EmanuelKaefer/Open-robot-arm/README.txt

# Robot Arm Project

This repository contains an ongoing project focused on the development of a 6-DOF robotic arm. The project is part of a school project and may later be extended into a larger final thesis project. The goal is to design and build a functional robotic arm while gaining experience in mechanical design, electronics, embedded systems, and software.

The repository includes hardware designs, firmware, control software, and documentation. As the project progresses, new features, improvements, and design iterations will be added.

# Technical Details
* Mechanical: Largely custom built. Most components are designed specifically for this project and manufactured using 3D printing.
* Electronics: Custom designed PCB created in KiCad, utilizing an STM32F446RET6 chip and TMC5160t pro 1.0 motor drivers.
* Software: Control algorithms are developed using MATLAB for modeling, simulation, and deployment.

# Licensing
This project is dual-licensed to respect the different requirements of hardware and software development:

* Software: All code within this repository is licensed under the GNU General Public License v3.0 (GPL-3.0). See `LICENSE-SOFTWARE` for details.
* Hardware: All hardware designs, including PCB layouts and mechanical CAD files, are licensed under the CERN Open Hardware Licence Version 2 (CERN-OHL-S-2.0). See `LICENSE-HARDWARE` for details.
