EmanuelKaefer/Open-robot-arm/Software/README.txt

# Software

This folder contains all software related to controlling the robot arm.  

## Notes
- Currently, most files are placeholders and will be implemented later.
