EmanuelKaefer/Open-robot-arm/Electrical/driver_board/README.txt

# Motor Driver Board

This board will handle the power and control signals for the robot arm's motors.

Decisions pending:
-Layout
