EmanuelKaefer/Open-robot-arm/doc/template/template_mama/.template_mama/content/software.tex

% !TeX spellcheck = de_DE
\chapter{Low Level Architektur und Steuerung}

%\section{Low Level Architektur und Steuerung}
\label{sec:software}

Dieses Kapitel beschreibt die Implementierung der zentralen Low-Level-Robotersteuerung, die auf einem Mikrocontroller läuft. Sie stellt das funktionale Bindeglied zwischen der mechanischen Konstruktion (siehe \ref{sec:hardware}) und der elektrischen Leistungselektronik (siehe \ref{sec:elektrisches_H}) dar. Die Firmware wurde auf Hardwareabstraktionsebene (STM32CubeHAL) basierendem C für einen STM32F446-Mikrocontroller in der Entwicklungsumgebung STM32CubeIDE entwickelt \cite{a2021_this}. Ziel der Softwarearchitektur ist es, harte Echtzeitanforderungen für die synchrone Ansteuerung von sechs Schrittmotoren zu erfüllen und gleichzeitig eine hochgradig skalierbare Basis für zukünftige Pfadplanungen zu schaffen.

\section{Implementierung der 6 Achsen und Skalierbarkeit}
\label{subsec:hal}

Bei der Ansteuerung eines 6-Achs-Roboterarms führt die Zuweisung von Mikrocontroller-Pins als Einzelvariablen und die statische Zuweisung von Peripherie-Registern schnell zu eingeschränktem und fehleranfälligem Programmcode. Um dies zu vermeiden, wurde eine Pointer-Array-basierte Datenstruktur implementiert. Anstatt jede Achse separat zu adressieren, werden Pointer auf die entsprechenden Hardware-Timer (\texttt{TIM\_HandleTypeDef}), PWM-Kanäle sowie die GPIO-Ports für Richtungs- (\texttt{DIR}) und Chip-Select-Signale (\texttt{CS}) in globalen Arrays gekapselt.\cite{a2021_this}

Durch diese Entkopplung von physikalischer Hardware und Steuerungslogik kann jede Achse über einen simplen Index angesprochen werden. Dies ermöglicht es, Kernfunktionen wie das Starten und Stoppen der Motoren oder das Homing über alle Treiber mittels einfacher Schleifenkonstrukte umzusetzen, was die Skalierbarkeit und Wartbarkeit des Systems maßgeblich erhöht.

\subsection{Richtungssignale (DIR-Pins)}
\label{subsec:hal_DIR}
Zur Bestimmung der Drehrichtung benötigt jeder Schrittmotortreiber einen DIR-Pin (Direction). Ein High-Pegel (1) bewirkt eine Drehung im Uhrzeigersinn, ein Low-Pegel (0) eine Drehung gegen den Uhrzeigersinn. Um dies für alle sechs Motoren effizient und skalierbar umzusetzen, wurden Arrays eingesetzt. 

\begin{lstlisting}[language=C, caption={Arrays für DIR-Pins/Ports}, label={lst:ARRAY_DIR}]
	GPIO_TypeDef* DIR_PORTS[6] = {TMC1_DIR_GPIO_Port, TMC2_DIR_GPIO_Port,  TMC3_DIR_GPIO_Port, TMC4_DIR_GPIO_Port, TMC5_DIR_GPIO_Port, TMC6_DIR_GPIO_Port};
	uint16_t      DIR_PINS[6]  = {TMC1_DIR_Pin, TMC2_DIR_Pin,  TMC3_DIR_Pin, TMC4_DIR_Pin, TMC5_DIR_Pin, TMC6_DIR_Pin};
\end{lstlisting}
%TODO erklären was mit Port Pins und warum pointer

\subsection{Geschwindigkeitsregelung (STEP-Pins)}
\label{subsec:hal_STEP}
Die Geschwindigkeitsregelung über die STEP-Pins wird mittels Hardware-Pulsweitenmodulation (PWM) durch Timer implementiert. Die Motortreiber benötigen zur Vorgabe der Geschwindigkeit ein Frequenzsignal am STEP-Eingang. Dies ist ebenfalls durch Arrays realisiert.
\begin{lstlisting}[language=C, caption={Arrays für STEP-Timer/Channels}, label={lst:ARRAY_STEP}]
	TIM_HandleTypeDef* AXIS_TIMERS[6] = {&htim2, &htim1, &htim3, &htim4, &htim8, &htim10};
	uint32_t AXIS_CHANNELS[6] = {TIM_CHANNEL_1, TIM_CHANNEL_1, TIM_CHANNEL_1, TIM_CHANNEL_1, TIM_CHANNEL_1, TIM_CHANNEL_1};
\end{lstlisting}

\subsection{Vergleich: Mit und ohne Array-Abstraktion}
\label{subsubsec:hal_comparison}

Ohne Array-Abstraktion würde die Motoransteuerung mehrere if-else-Blöcke 
erfordern. Als Beispiel wird die Funktion zum Stoppen einer Motor-PWM von drei Achsen gezeigt.

\subsubsection{Hardcodierte Hardware-Zuordnung}

\begin{lstlisting}[language=C, caption={Motor-Stopp ohne Array-Abstraktion (Anti-Pattern)}, 
	label={lst:hal_no_array}]
	void Step_Stop_HardCoded(uint8_t ax) {
		if (ax == 0) {
			HAL_TIM_PWM_Stop(&htim2, TIM_CHANNEL_1);
			HAL_TIM_Base_Stop_IT(&htim2);
		}
		else if (ax == 1) {
			HAL_TIM_PWM_Stop(&htim1, TIM_CHANNEL_1);
			HAL_TIM_Base_Stop_IT(&htim1);
		}
		else if (ax == 2) {
			HAL_TIM_PWM_Stop(&htim3, TIM_CHANNEL_1);
			HAL_TIM_Base_Stop_IT(&htim3);
		}
		
	}
\end{lstlisting}

Das führt zu mehreren Problemen:
\begin{itemize}
	\item \textbf{Code-Duplikation}: Die gleiche Logik wird sechsmal wiederholt.
	\item \textbf{Wartbarkeit}: Änderungen müssen sechsmal vorgenommen werden.
	\item \textbf{Fehleranfälligkeit}: Es ist leicht, einen Achsen-Fall zu vergessen oder falsch zuzuordnen.
	\item \textbf{Skalierbarkeit}: Das Hinzufügen oder Entfernen einer Achse erfordert massive Codeänderungen.
\end{itemize}

\section{Initialisierung und SPI-Kommunikation der Motortreiber}
\label{subsec:spi_init}
\subsection{SPI-Protokoll}
Das Serial Peripheral Interface (SPI) ist ein serielles Hochgeschwindigkeits-Bussystem, das vorwiegend zur Kommunikation von Mikrocontrollern mit Peripheriegeräten auf Platinen dient. SPI ist vollduplexfähig, das heißt, dass bei jedem Takt ein Bit vom Master an den Slave und umgekehrt gesendet wird. Es besteht aus drei Leitungen: MOSI (Master Out $\longrightarrow$ Slave In), MISO (Master In $\longleftarrow$ Slave Out) und SCK (Serial Clock). Hinzu kommt eine CS-Leitung (Chip Select), die vom Master separat zu jedem Slave geführt werden muss. Nur wenn diese CS-Leitung auf LOW gezogen wird, sendet oder empfängt der Slave Daten. Die Kommunikation erfordert in der Regel zwei Übertragungszyklen. Im ersten Zyklus sendet der Master ein Kommando an den Slave. Da der Slave zu diesem Zeitpunkt die Antwort noch nicht vorbereitet hat, sendet er irrelevante Dummy-Daten zurück. In der zweiten Übertragung sendet der Master einen leeren Datensatz, um das Taktsignal aufrechtzuerhalten, woraufhin der Slave die bereitgestellte Antwort übermittelt. Die Übertragungen erfolgen jeweils synchron \cite{a2025_serial}.

\subsubsection{SPI-Modi}
\label{subsubsec:SPIMODE}
Es existieren vier SPI-Modi (0-3). Diese definieren sich wie folgt:

\begin{figure}[htbp]
	\centering
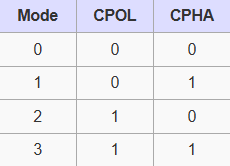
[picture p1: doc/template/template_mama/.template_mama/figures/allgemein/SPIMode.png]
	
	\caption{Diagramm der SPI-Modi}
	\label{fig:SPIMode}
\end{figure}

CPOL (Clock Polarity):
\begin{itemize}
	\item 0: Takt ist im Ruhezustand LOW, ein Wechsel auf HIGH zählt als steigende Taktflanke.
	\item 1: Takt ist invertiert (im Ruhezustand HIGH), ein Wechsel auf LOW zählt als steigende Taktflanke.
\end{itemize}

CPHA (Clock Phase):
\begin{itemize}
	\item 0: Daten werden bei der ersten Taktflanke (abhängig von CPOL) eingelesen und bei der darauffolgenden ausgegeben.
	\item 1: Daten werden bei der zweiten Taktflanke eingelesen und bei der ersten ausgegeben.
\end{itemize}

\subsection{Initialisierung der Motortreiber}
Die verwendeten Schrittmotortreiber vom Typ TMC5160 in Kombination mit NEMA-17-Schrittmotoren erfordern eine initiale Konfiguration ihrer internen Register, um Parameter wie Haltestrom, Betriebsstrom (Run-Current) und den Chopper-Modus festzulegen. Diese Kommunikation erfolgt über einen geteilten SPI-Bus. Um die Treiber individuell adressieren zu können, wird vor jedem Datentransfer der spezifische Chip-Select-Pin (\texttt{CS}) der Zielachse auf ein niedriges Potential (LOW) gezogen. Die TMC5160 erfordern den Betrieb im SPI-Modus 3 (siehe \ref{fig:SPIMode}) \cite{power}.

Um Fehler direkt bei der Initialisierung der Treiber zu erkennen, wurde eine Validierung implementiert, die zwingend erfolgreich durchlaufen werden muss. Nach dem Schreiben der Konfigurationsdaten liest der Mikrocontroller das globale Statusregister (\texttt{GSTAT}) sowie aktuelle Treiberzustände zurück. Nur wenn das System valide Antworten (\texttt{GSTAT} = 0) detektiert, wird die Steuerung freigegeben. Störsignale oder fehlende Hardware-Verbindungen werden so unmittelbar beim Systemstart erkannt und führen zu einem sicheren Systemabbruch. 

Die gewählte Konfiguration der Motortreiber stellt sich wie folgt dar:

\begin{table}[htbp]
	\footnotesize 
	\centering
	\caption[Konfiguration der TMC5160T-Register via SPI]{\textsc{Konfiguration der TMC5160T-Register via SPI}}
	\label{tab:tmc5160_config}
	
	\begin{tabularx}{\linewidth}{l X}
		\toprule
		\textbf{Register (Wert)} & \textbf{Funktion} \\
		\midrule
		\texttt{GSTAT} (0x01) = \texttt{0x00000007} & Setzt das globale Statusregister zurück. Löscht den Fehlerspeicher für Reset, Unterspannung der Charge-Pump und Driver-Shutdown vor dem Testlauf. \\
		\addlinespace
		\texttt{GCONF} (0x00) = \texttt{0x00000005} & Der treiber nutzt die Analoge Stromskalierung und den Internen Sense Wiederstand \\
		\addlinespace
		\texttt{IHOLD\_IRUN} (0x10) = \texttt{0x0008100A} & Konfiguriert den Motorstrom: Setzt den Fahrstrom (\texttt{IRUN}) auf 52\,\%, den Haltestrom im Stillstand (\texttt{IHOLD}) auf 32\,\% sowie eine Verzögerung (\texttt{IHOLDDELAY}) von 20µs für die Stromabsenkung. \\
		\addlinespace
		\texttt{CHOPCONF} (0x6C) = \texttt{0x100C0403} & Konfiguration des Chopper-Verfahrens. Aktiviert den \textit{SpreadCycle}-Modus und definiert das Signal-Timing (\textit{TOFF}, \textit{TBL}). \\
		\bottomrule \cite{power}
	\end{tabularx}
\end{table}

\section{Finite State Machine (Endlicher Zustandsautomat)}
\label{subsec:fsm}

Um die auf dem Mikrocontroller laufende Software deterministisch zu gestalten und Deadlocks zu verhindern, kommt eine Finite State Machine (FSM) zum Einsatz. Eine FSM ist ein mathematisches Modell für Systeme, die sich zu jedem Zeitpunkt in genau einem von mehreren Zuständen befinden. Eine FSM besteht strukturell aus den folgenden Komponenten \cite{a2026_statemachine}:

\begin{itemize}
	\item Zustände (States): Die verschiedenen operativen Phasen des Systems.
	\item Startzustand (Initial State): Der Zustand, in dem die FSM initialisiert wird.
	\item Übergänge (Transitions): Die definierten Bedingungen für den Wechsel zwischen Zuständen.
	\item Ereignisse (Inputs): Die Trigger, die einen Zustandswechsel bewirken.
	\item Aktionen (Outputs): Die ausführenden Operationen der FSM.
\end{itemize}

\subsection{Zustände}

\begin{figure}[htbp]
	\centering
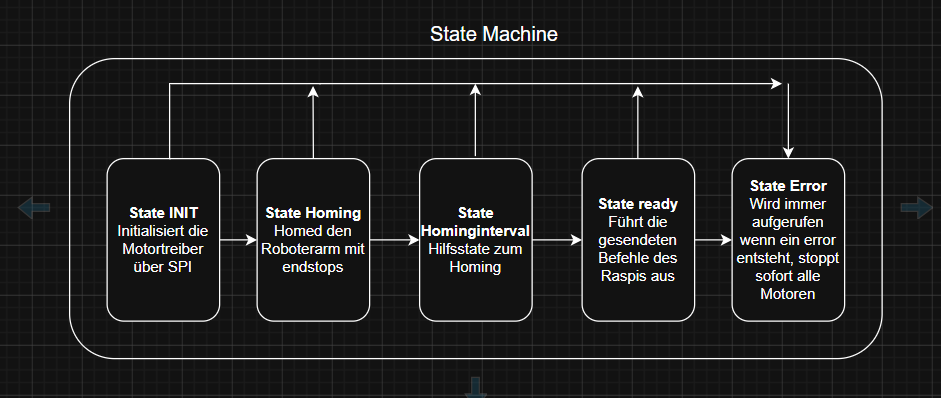
[picture p2: doc/template/template_mama/.template_mama/figures/allgemein/State_maschin.png]
	
	\caption{Diagramm der Finite State Machine}
	\label{fig:Finite_State_Maschine}
\end{figure}

Für den entwickelten Roboterarm wurden die Zustände \texttt{STATE\_INIT}, \texttt{STATE\_HOMING}, \texttt{STATE\_HOMING\_OFFSET}, \texttt{STATE\_READY} und \texttt{STATE\_ERROR} definiert. Als Startzustand dient \texttt{STATE\_INIT}, da vor dem regulären Betrieb eine Treiberinitialisierung zwingend erforderlich ist.
%TODO mehr ausführen wie unsere Finite State Machine die Komponenten macht und ändern auf das was es dann am ende ist
Die Spezifikationen der Zustände gestalten sich wie folgt:

\begin{table}[htbp]
	\footnotesize 
	\centering
	\caption[Zustände der Finite State Machine]{\textsc{Zustände der Finite State Machine}}
	\label{tab:fsm_states}
	
	\begin{tabularx}{\linewidth}{l X}
		\toprule
		\textbf{Zustand} & \textbf{Funktion} \\
		\midrule
		\texttt{STATE\_INIT}          & Initialisiert die Motortreiber über den SPI-Bus und konfiguriert die Registerparameter. \\
		\addlinespace 
		\texttt{STATE\_HOMING}        & Führt den ersten Teil der kinematischen Referenzfahrt durch, bei der die Achse bis zur Auslösung des Endschalters verfahren wird. \\
		\addlinespace
		\texttt{STATE\_HOMING\_OFFSET} & Führt den zweiten Teil der kinematischen Referenzfahrt durch. Die Achse verfährt vom Endschalter um einen definierten Offset auf die finale Home-Position. \\
		\addlinespace
		\texttt{STATE\_READY}         & Der reguläre Betriebszustand. Der Mikrocontroller verarbeitet eingehende Befehle und setzt diese in Trajektorien um. \\
		\addlinespace
		\texttt{STATE\_ERROR}         & Fehlerzustand. Alle Motoren werden umgehend gestoppt und ein Fehlercode wird ausgegeben. Ein manueller Reset ist erforderlich. \\
		\bottomrule
	\end{tabularx}
\end{table}
\newpage
%\section{Kinematische Referenzierungsfahrt (Homing)}
%\label{subsec:homing}
%
%Da Schrittmotoren über keine absolute Positionscodierung verfügen und aus Kostengründen auf absolute Encoder verzichtet wurde, ist der Systemzustand nach jedem Kaltstart undefiniert. Um den vordefinierten kinematischen Nullpunkt des Roboters zu ermitteln, muss zwingend eine Kalibrierungsfahrt (Homing) durchgeführt werden.
%
%\subsection{Interrupt-Verarbeitung und Hardware-Entprellung}
%\label{subsubsec:interrupts}
%
%Für die Erfassung der Endschaltersignale kommen externe Interrupts (\texttt{EXTI}s) zum Einsatz. Die Verwendung von Interrupts reduziert die Prozessorauslastung signifikant, da aktives Polling (permanentes Abfragen der Pins) entfällt. Sobald eine Signalflanke detektiert wird, löst der Hardware-Controller einen Interrupt-Request aus, der den regulären Programmablauf unterbricht und eine spezifische Interrupt-Service-Routine (ISR) aufruft. Diese Routine setzt ein Flag, das dem Hauptprogramm signalisiert, dass der Endschalter erreicht wurde, der Positions-Offset berechnet und die Drehrichtung umgekehrt werden muss \cite{a2021_this}.
%
%Um mehrfache Interrupt-Auslösungen durch mechanisches Schalterprellen (Bouncing) zu verhindern, ist in der Interrupt-Routine eine softwareseitige Entprellung (Debouncing) integriert. Diese blockiert nach der ersten Flankenerkennung alle weiteren Signale desselben Pins für ein Zeitfenster von 30\,ms. 
%
%Die Implementierung in C ist wie folgt realisiert:
%\newpage
%\begin{lstlisting}[language=C, caption={Software-Entprellung (Debouncing) innerhalb der ISR}, label={lst:IQR_debounce}]
%	static uint32_t last = 0;
%	uint32_t now = HAL_GetTick();
%	if (now - last < 30) return;
%	last = now;
%\end{lstlisting}
%
%\subsection{Berechnung kinematischer Offsets}
%\label{subsubsec:offsets}
%
%Der mechanische Nullpunkt an der Position der Endschalter entspricht in der Regel nicht dem kinematischen Nullpunkt des Robotermodells. Diese Diskrepanz erfordert die Berechnung eines Ausgleichsoffsets. Die zu kompensierende Winkeldifferenz muss dazu in die entsprechende Schrittanzahl der Motoren umgerechnet werden. Die allgemeine Gleichung lautet:
%
%$$ \text{Steps} = \frac{\Delta\text{rad}}{2\cdot\pi} \cdot \text{Vollschritte} \cdot \text{Mikroschritte} \cdot \text{Getriebeübersetzung} $$
%
%Mit den konkret eingesetzten Hardwareparametern ergibt sich folgende Berechnung:
%
%$$ \text{Steps} = \frac{\Delta\text{rad}}{2\cdot\pi} \cdot 200 \cdot 16 \cdot 20 $$
%
%\begin{itemize}
%	\item $\Delta\text{rad}$: Die berechnete Winkeldifferenz zwischen Endschalter und kinematischer Home-Position (in Radiant).
%	\item $200$: Die Anzahl der physikalischen Vollschritte des Motors pro Umdrehung ($1,8^\circ$ Schrittwinkel).
%	\item $16$: Die konfigurierte Mikroschritt-Auflösung pro Vollschritt.
%	\item $20$: Das mechanische Untersetzungsverhältnis des Getriebes (1:20) für alle Achsen.
%\end{itemize}
%
%\subsection{Sequenzieller Homing-Ablauf}
%\label{subsubsec:homing_sequence}
%
%Die Referenzierung des 6-Achs-Systems erfolgt aus Sicherheitsgründen sequenziell. Dadurch werden mechanische Kollisionen oder kritische Fehler – wie das gleichzeitige Auffahren mehrerer Achsen auf die Endanschläge – konstruktiv ausgeschlossen. Ein weiterer Vorteil des sequenziellen Homings ist die Möglichkeit der isolierten visuellen Überprüfung der Korrektheit jeder einzelnen Achsbewegung. Der Ablauf wird durch eine globale Index-Variable (\texttt{current\_homingaxis}) gesteuert und verläuft hierarchisch von der Basis (Achse 0) bis zum Endeffektor (Achse 5). Der Vorgang pro Achse gliedert sich in folgende Phasen: 
%
%Zunächst verfährt die Achse im Zustand \texttt{STATE\_HOMING} mit konstanter Geschwindigkeit in Richtung des Endschalters. Nach Auslösen des Interrupts berechnet der Algorithmus den erforderlichen Offset, invertiert das Richtungssignal (\texttt{DIR}) und leitet den Zustandswechsel zu \texttt{STATE\_HOMING\_OFFSET} ein. Die Achse gilt erst dann als referenziert, wenn die berechnete Schrittzahl für den Offset über den Timer-Interrupt exakt abgefahren wurde. Anschließend wird der Achsindex inkrementiert und die Prozedur für das nächste Gelenk gestartet, bis das Gesamtsystem kalibriert ist und in den regulären Betriebszustand \texttt{STATE\_READY} übergeht.

%\section{Verbindung mir Raspberry Pi und normaler Betrieb}

%\label{sec:normalerBetrieb}
%	Im normalen Betrieb erhält der STM über UART Befehle von einem Raspberry pi 4b, der Raspberry sendet die Zielposition zu der sich der Endeffektor des Roboterarms bewegen soll in Radianten, also einen Array von 6 joint Winkeln und die Ausrichtung des Greifers. Außerdem noch eine Maximale Geschwindigkeit auf die die Motoren beschleunigen sollen
%\subsection{UART-Protokoll}
%	  
\section{Regulärer Betrieb und Trajektoriensteuerung}
\label{sec:regulaerer_betrieb}
%TODO: alles da iwan mal umschreiben weil is !:! von ai wegen kein bock jetz doku schreiben aber trotzdem bsschen zusammenfassung das ich anhalt habe wenn ich mache...

Im regulären Punkt-zu-Punkt-Betrieb würde ein abruptes Anfahren der Schrittmotoren zu extrem hohen mechanischen Belastungen, starken Schwingungen und eventuellen Schrittverlusten führen. Um eine geschmeidige Bewegung zu garantieren wird eine Trajektorienplanung mit trapez- bzw. dreieckförmigem Geschwindigkeitsprofil auf dem Mikrocontroller ausgeführt.

\subsection{Mathematische Umsetzung des Trapezprofils}
\label{subsec:math_trapez}

Das Geschwindigkeitsprofil unterteilt die Bewegung einer Achse grundsätzlich in drei Phasen: Beschleunigung ($a$), Konstantfahrt ($v_{\max}$) und Verzögerung ($-a$). 

\subsubsection{Unterscheidung zwischen Trapez- und Dreiecksprofil}
Vor Beginn einer Bewegung wird für jede Achse geprüft, ob die zu fahrende Distanz $S_i$ ausreicht, um die gewünschte Maximalgeschwindigkeit $v_{\max, i}$ und damit das Trapezprofil zu erreichen. Die dafür erforderliche Mindestdistanz berechnet sich zu:
\begin{equation}
	S_{\text{min}, i} = \frac{v_{\max, i}^2}{a_i}
\end{equation}
Ist $S_i < S_{\text{min}, i}$, wird die Maximalgeschwindigkeit nicht erreicht. Das Profil wird zu einem Dreiecksprofil reduziert.
\subsubsection{Mehrachs-Synchronisation ($t_{\text{sync}}$)}
Damit sich der Endeffektor des Roboterarms geradlinigen und synchrone bewegt, müssen alle sechs Achsen exakt zeitgleich an ihrer jeweiligen Zielposition ankommen. Dafür wird zunächst für jede Achse $i$ die theoretische Gesamtfahrzeit $t_i$ berechnet:
\begin{equation}
	t_i = 
	\begin{cases} 
		\frac{S_i}{v_{\max, i}} + \frac{v_{\max, i}}{a_i} & \text{falls Trapezprofil} \\[6pt]
		2 \cdot \sqrt{\frac{S_i}{a_i}} & \text{falls Dreiecksprofil}
	\end{cases}
\end{equation}
Die langsamste Achse bestimmt die globale Synchronisationszeit $t_{\text{sync}}$ des Gesamtsystems:
\begin{equation}
	t_{\text{sync}} = \min(t_1, t_2, \dots, t_6)
\end{equation}
Anschließend werden die Geschwindigkeiten $v_{\text{synced}, i}$ aller schnelleren Achsen skaliert, sodass ihre Bewegung exakt über die Zeit $t_{\text{sync}}$ gestreckt wird. Die beschleunigung bleibt hierbei unabhängig der zu fahrenden Schritte gleich da die veränderung von  $v_{\text{max}}$ ausreicht um alle möglichen szenarien ausreichend abzudecken.

\subsection{Softwareimplementierung auf dem STM32}
\label{subsec:sw_implementation}

Die Generierung der Schrittfrequenzen erfolgtchtzeitnah über eine periodische Interrupt-Service-Routine (ISR) mittels eines Timer-Interrupts.

\subsubsection{Dynamische Frequenzanpassung via ARR}
Die Geschwindigkeit eines Schrittmotors ist proportional zur Frequenz der STEP-Impulse. Der STM32 steuert diese Frequenz über das Auto-Reload-Register (\texttt{ARR}) des jeweiligen Timers. In jedem Regelzyklus der ISR wird die neue Soll-Geschwindigkeit $v(t)$ berechnet und das \texttt{ARR}-Register dynamisch nach folgender Formel aktualisiert:
\begin{equation}
	\text{ARR}_i = \frac{f_{\text{timer}}}{(PSC_i + 1) \cdot f_{\text{step}, i}} - 1
\end{equation}
wobei $f_{\text{timer}}$ die Quarzfrequenz des Mikrocontrollers und $PSC$ den eingestellten Prescaler bezeichnet.

\subsection{Systemstabilität und Troubleshooting (Praktische Herausforderungen)}
\label{subsec:troubleshooting}

Bei der Umsetzung der Trajektoriensteuerung zeigten sich in der Praxis hardware- und softwareseitige Phänomene, die gezielt gelöst werden mussten, um einen stabilen Lauf zu garantieren.

\subsubsection{Timer-Lockup und Auto-Reload Preload (\texttt{TIM\_CR1\_ARPE})}
Beim dynamischen Herabsetzen des \texttt{ARR}-Wertes während der Bremsphase trat vereinzelt ein Einfrieren des Timers bzw. ein Kriecheffekt mit minimaler Frequenz ($\approx 15\,\text{Hz}$) auf. 
\textbf{Ursache:} Wenn der aktuelle Zählerstand des Timers (\texttt{CNT}) im Moment des Umschreibens bereits größer war als der neue, kleinere \texttt{ARR}-Wert, zählte der Timer bis zum Maximum des 16-Bit-Registers ($65.535$) hoch, bevor ein Overflow stattfand.
\textbf{Lösung:} Aktivierung des Auto-Reload Preload Bits (\texttt{ARPE}) im Kontrollregister \texttt{TIMx\_CR1}. Dadurch wird das neue \texttt{ARR} gepuffert und erst beim nächsten regulären Update-Event (UEV) übernommen.

\subsubsection{Besonderheiten der Advanced Timers (\texttt{TIM1} / \texttt{TIM8})}
Während die Allzweck-Timer (\texttt{TIM2}--\texttt{TIM4}) direkt PWM-Signale ausgaben, blieben die Ausgänge von \texttt{TIM1} und \texttt{TIM8} zunächst pegellos.
\textbf{Ursache:} \texttt{TIM1} und \texttt{TIM8} sind präzise \textit{Advanced Control Timer}. Diese verfügen über eine Totzeit-Generierung und eine Notabschaltung (Break Input), weshalb die Ausgänge standardmäßig hochohmig geschaltet sind.
\textbf{Lösung:} Explizites Setzen des Main Output Enable Bits (\texttt{MOE}) im Break-and-Dead-Time-Register (\texttt{BDTR}) via Macro:
\begin{lstlisting}[language=C, caption={Freischaltung der Advanced Timer Ausgänge}]
	__HAL_TIM_MOE_ENABLE(&htim1);
	__HAL_TIM_MOE_ENABLE(&htim8);
\end{lstlisting}

\subsubsection{Fließkommarundung und Kriechphasen-Eliminierung}
Durch Akkumulation von Fließkomma-Rundungsfehlern (\texttt{float}-Präzision) in der Iterationsschleife erreichte die Differenz zwischen Ist- und Zielposition in Grenzfällen nie exakt Null. Dies führte dazu, dass der Motor kurz vor dem Ziel in einer unendlichen Kriechphase mit Minimalfrequenz verharrte.
\textbf{Lösung:} Einführung einer Abbruchschwelle. Unterschreitet die Restdistanz einen Wert von $0{,}5$ Mikroschritten, wird die Profilberechnung hart beendet und der PWM-Timer gestoppt.
\textbf{Mathematischer Nachweis der Toleranz:} Bei $16$ Mikroschritten pro Vollschritt, einem $1{,}8^\circ$-Motor und einer $1:20$ Getriebeübersetzung entspricht eine Abweichung von $0{,}5$ Mikroschritten:
\begin{equation}
	\Delta\varphi = \frac{1{,}8^\circ}{16 \cdot 20} \cdot 0{,}5 = 0{,}0028125^\circ \ll 1^\circ
\end{equation}
Die Positioniergenauigkeit liegt somit um Größenordnungen unterhalb der geforderten $1^\circ$-Toleranzgrenze.
\chapter{High Level Software}
\section{Ausblick}
Die High-Level-Software auf dem Raspberry Pi ermöglicht die Eingabe kartesischer Zielkoordinaten für den Endeffektor über ein Graphical User Interface (GUI). Diese kartesischen Koordinaten (x, y, z) werden mithilfe der Python-Bibliothek IKpy über inverse Kinematik in sechs Gelenkwinkel in Radiant transformiert. Zudem lässt sich über die GUI die maximale Geschwindigkeit definieren, auf welche die Motoren beschleunigen dürfen. Da der Fokus der bisherigen Entwicklung primär auf der Low-Level-Software lag, befindet sich die High-Level-Implementierung noch in einer frühen Projektphase.
%\section{Inverse Kinematik}
%
%\subsection{Grundlagen der Kinematik}
%
%Die Kinematik ist ein Teilgebiet der Mechanik, das sich mit der Beschreibung von Bewegungen 
%starrer Körper befasst, ohne dabei die verursachenden Kräfte zu berücksichtigen. Im Kontext 
%der Robotik wird zwischen zwei grundlegenden Problemstellungen unterschieden: der 
%\textit{Vorwärtskinematik} (engl. \textit{Forward Kinematics}) und der \textit{Inversen 
%	Kinematik} (engl. \textit{Inverse Kinematics}, kurz IK).
%
%Bei der \textbf{Vorwärtskinematik} werden aus gegebenen Gelenkwinkeln $\theta_1, \theta_2, 
%\ldots, \theta_n$ eines kinematischen Systems die resultierende Position und Orientierung 
%des Endeffektors im kartesischen Raum berechnet. Diese Transformation ist eindeutig und 
%lässt sich durch eine geschlossene mathematische Abbildung beschreiben:
%
%\begin{equation}
%	\mathbf{T} = f(\theta_1, \theta_2, \ldots, \theta_n)
%\end{equation}
%
%\noindent wobei $\mathbf{T} \in SE(3)$ die homogene Transformationsmatrix darstellt, die 
%sowohl die Rotation als auch die Translation des Endeffektors im Weltkoordinatensystem 
%kodiert.
%
%\subsection{Definition der Inversen Kinematik}
%
%Die \textbf{Inverse Kinematik} stellt das inverse Problem dar: Gegeben eine gewünschte 
%Position und Orientierung $\mathbf{T}^* \in SE(3)$ des Endeffektors, gesucht ist der 
%Vektor der Gelenkwinkel $\boldsymbol{\theta} = (\theta_1, \ldots, \theta_n)^T$, der 
%diese Zielkonfiguration realisiert:
%
%\begin{equation}
%	\boldsymbol{\theta} = f^{-1}(\mathbf{T}^*)
%\end{equation}
%
%Im Gegensatz zur Vorwärtskinematik ist dieses Problem im Allgemeinen weder trivial noch 
%eindeutig lösbar. Abhängig von der Struktur des Roboters und der gewünschten Zielposition 
%können mehrere, unendlich viele oder keine Lösungen existieren.
%
%\subsection{Mathematische Herausforderungen}
%
%Die Inverse Kinematik ist mit einer Reihe grundlegender mathematischer Herausforderungen 
%verbunden:
%
%\begin{itemize}
%	\item \textbf{Nichtlinearität:} Die kinematischen Gleichungen beinhalten trigonometrische 
%	Funktionen, was das System nichtlinear und damit analytisch schwer lösbar macht.
%	
%	\item \textbf{Mehrdeutigkeit:} Ein und dieselbe Endeffektorposition kann durch 
%	unterschiedliche Gelenkkonfigurationen erreicht werden (z.\,B. Ellbogen oben vs. 
%	Ellbogen unten bei einem menschlichen Arm).
%	
%	\item \textbf{Redundanz:} Besitzt ein Roboterarm mehr Freiheitsgrade (DOF, 
%	\textit{Degrees of Freedom}) als zur Erfüllung der Aufgabe notwendig, spricht man von 
%	einem redundanten System. In diesem Fall existiert ein kontinuierlicher Lösungsraum.
%	
%	\item \textbf{Erreichbarkeit:} Nicht jede beliebige Pose im Raum liegt im 
%	Arbeitsraum (engl. \textit{Workspace}) des Roboters. Außerhalb des Arbeitsraums 
%	existiert keine Lösung.
%	
%	\item \textbf{Singularitäten:} Bestimmte Konfigurationen führen zu sogenannten 
%	kinematischen Singularitäten, in denen die Jacobi-Matrix ihren vollen Rang verliert 
%	und das System seine Manövrierfähigkeit in bestimmten Richtungen einbüßt.
%\end{itemize}
%
%\subsection{Lösungsverfahren der Inversen Kinematik}
%
%Die Inverse Kinematik lässt sich grundsätzlich durch verschiedene Ansätze lösen. Die
%Bibliothek IKpy, die in dieser Arbeit eingesetzt wird, verwendet ein
%\textbf{optimierungsbasiertes numerisches Verfahren}. Dabei wird die Inverse Kinematik
%als nichtlineares Minimierungsproblem formuliert: Gesucht ist derjenige
%Gelenkwinkelvektor $\boldsymbol{\theta} = (\theta_1, \ldots, \theta_n)^T$, der den
%Fehler zwischen der tatsächlich erreichten Pose des Endeffektors
%$f(\boldsymbol{\theta})$ und der gewünschten Zielppose $\mathbf{T}^*$ minimiert:
%
%\begin{equation}
%	\boldsymbol{\theta}^* = \arg\min_{\boldsymbol{\theta}}
%	\left\| f(\boldsymbol{\theta}) - \mathbf{T}^* \right\|^2
%\end{equation}
%
%\noindent Zur Lösung dieses Optimierungsproblems greift IKpy auf Algorithmen aus der
%Bibliothek \texttt{scipy.optimize} zurück, standardmäßig auf die Methode
%\textit{L-BFGS-B} (\textit{Limited-memory Broyden–Fletcher–Goldfarb–Shanno with Bounds})
%\cite{byrd1995limited}. Dabei handelt es sich um ein quasi-Newton-Verfahren, das speziell
%für hochdimensionale Probleme mit Variablenbeschränkungen entwickelt wurde. Es approximiert
%die Hesse-Matrix der Kostenfunktion durch eine kompakte Darstellung der vergangenen
%Gradienten, ohne diese vollständig zu berechnen oder zu speichern. Dies macht das
%Verfahren sowohl speicher- als auch recheneffizient.
%
%Der Gradient der Kostenfunktion wird dabei numerisch über finite Differenzen approximiert.
%Für jeden Iterationsschritt $k$ wird der Gelenkwinkelvektor in Richtung des negativen
%Gradienten aktualisiert, bis ein Konvergenzkriterium erfüllt ist:
%
%\begin{equation}
%	\boldsymbol{\theta}_{k+1} = \boldsymbol{\theta}_k -
%	\alpha_k \, \mathbf{H}_k^{-1} \, \nabla_{\boldsymbol{\theta}} \,
%	\mathcal{L}(\boldsymbol{\theta}_k)
%\end{equation}
%
%\noindent wobei $\alpha_k$ die Schrittweite, $\mathbf{H}_k^{-1}$ die approximierte
%inverse Hesse-Matrix und $\mathcal{L}(\boldsymbol{\theta})$ die Kostenfunktion bezeichnet.
%Gelenklimitierungen $\theta_i \in [\theta_i^{\min},\, \theta_i^{\max}]$ werden direkt
%als Variablenbeschränkungen (Bounds) in das Optimierungsproblem integriert und vom
%L-BFGS-B-Algorithmus nativ berücksichtigt, ohne dass Strafterme erforderlich sind.
%%TODO irgendwie Zitieren und AI auch Zitieren
%\subsection{Implementierung mit IKpy}
%Die Python Bibliothek IKpy übernimmt mit einem Simplen code die Berechnung der Inversen Kinematik. Das spart den Zeitaufwand die Inverse Kinematik von Grund auf selbst zu programmieren. Dabei bezieht sie sich für die Propationendes Roboters auf die aus dem 3d CAD Model extrahierte URDF. 
%
%\subsubsection{Universal Robot Description File - URDF}
%
%
%\subsection{Zusammenfassung}
%
%Die Inverse Kinematik stellt eine zentrale Aufgabe in der Robotik dar, die die Brücke 
%zwischen der aufgabenorientierten Beschreibung von Bewegungen im kartesischen Raum und 
%der gelenk\-winkel\-basierten Steuerung realer Robotersysteme schlägt. Die Wahl des 
%geeigneten Lösungsverfahrens hängt dabei stets von der konkreten Roboterstruktur, den 
%Echtzeitanforderungen sowie den gewünschten Nebenbedingungen ab.
%
%
%\section{Hypertext Markup Language-HTML}
%
%
%\section{FastAPI}
%
