EmanuelKaefer/Open-robot-arm/doc/template/template_mama/.template_mama/content/vorwort.tex

%% !TeX spellcheck = de_DE
%%DATE 2.4 12:01
%\chapter{Vorwort}
%{
%Vorwort Einfügen
%\par
%-""-\par
%\vspace{1cm}
%Ort Datum Einfügen\par
%Matteo Gassler \& Emanuel Käfer \& Alexander Dick
%}
