EmanuelKaefer/Open-robot-arm/doc/template/template_mama/.template_mama/formal/title.tex

%%%% Time-stamp: <2013-02-25 16:05:46 vk>
%% ========================================================================
%%%% Titelseite für eine Vorwissenschaftliche Arbeit
%% ========================================================================
%%
%% created by
%%
%%      Karl Voit
%%

\thispagestyle{empty}  %% no page header or footer

\large  %% basic font size of the titlepage

\begin{center}

{\huge\bfseries\mytitle}

\vfill

\\[5mm]

\vfill

ASIT-Projekt verfasst von\\[5mm]
\begin{spacing}{1.0}
	\Large\bfseries\myauthor\\
\end{spacing}

\vfill

Betreuer: \mysupervisor

\vfill

\myinstitute\\

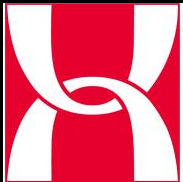
[picture p4: doc/template/template_mama/.template_mama/figures/allgemein/HTBLA_Saalfelden_Logo.png]
\\[5mm]

\vfill

%%\mysubmissiontown, \mysubmissionmonth~\mysubmissionyear
\end{center}

\hrule

Abgabevermerk:

%%\hfill

\mysubmissiontown, 19 Juni~\mysubmissionyear \quad \quad \quad \quad \quad \quad übernommen von: 

\normalsize %% new page, reset font size
\newpage

%% if myaddcolophon is set to "true", colophon is added:
\ifthenelse{\boolean{myaddcolophon}}{
  \newpage
  \thispagestyle{empty}  %% no page header or footer

  ~
  \vfill
  \mycolophon
}{}
\newpage

%% end of title page
%%% Local Variables:
%%% mode: latex
%%% mode: auto-fill
%%% mode: flyspell
%%% eval: (ispell-change-dictionary "de_AT")
%%% TeX-master: "../main"
%%% End:
