EmanuelKaefer/Open-robot-arm/doc/template/template_mama/.template_mama/content/abtract_englisch.tex

% !TeX spellcheck = en_US
%DATE 2.4 12:01
\chapter{Abstract-Englisch}
{
abstract english einfügen
}
%The thesis deals with the development of the ice hockey training system "PuckVision", whose core component is an 0.80 m x 0.80 m plastic plate serving as the playing surface. The objective is to move the puck as quickly as possible over illuminated spots. Each spot consists of an LED light and a Hall effect sensor, which precisely detects whether the puck has been successfully guided over it. The LED visualizes the spot and indicates the respective training task.  
%
%The data is transmitted in real-time via the I\textsuperscript{2}C communication protocol to a central control unit, the "ESP32" microcontroller, which synchronizes and controls all sensors, LEDs, and game functions. Players can track their progress through an accompanying website, which provides data such as scores or an option to reset the system.
