EmanuelKaefer/Open-robot-arm/doc/template/template_mama/.template_mama/formal/declaration.tex

%%%% Time-stamp: <2017-02-14 16:01:12 vk>
%% ========================================================================
%%%% Disclaimer
%% ========================================================================
%%
%% created by
%%
%%      Karl Voit, and Matthias Wölbitsch
%%
%%
%% code for the date and signature fields adapted from
%% http://tex.stackexchange.com/a/20562

\chapter*{Eidesstattliche Erklärung}
\foreignlanguage{ngerman}{%
	Wir erklären an Eides statt, dass wir die vorliegende Arbeit
	selbstständig verfasst, andere als die angegebenen
	Quellen/Hilfsmittel nicht benutzt, und die den benutzten Quellen
	wörtlich und inhaltlich entnommenen Stellen als solche kenntlich
	gemacht haben.}

 {

\newcommand{\textfield}[2]{
	\vbox{
		\hsize=#1\kern3cm\hrule\kern1ex
		\hbox to \hsize{\strut\hfil\footnotesize#2\hfil}
	}
}

\hbox to \hsize{\textfield{4cm}{Datum}\hfill\textfield{7cm}{Iason Vasiliadis}}
\hbox to \hsize{\hfill\textfield{7cm}{Fabian Gassler}}
}
