EmanuelKaefer/Open-robot-arm/Software/config_TMC5160T V1.0 [09.04.2026].docx

Hier sind alle wichtigen Kenndaten aus deinem aktuellen Konfig-Code:

Strom

Parameter | Wert | Bedeutung
IRUN | 16/31 | 50% = ~1.05A Fahrstrom
IHOLD | 8/31 | 25% = ~0.52A Haltestrom
IHOLDDELAY | 6 | Verzögerung bis Haltestrom nach Stopp
Max möglich | 31/31 | 100% = ~2.1A (Motorlimit)

Schritte

Parameter | Wert | Bedeutung
Mikroschritte (mres) | 4 = 16x | 16 Mikroschritte pro Vollschritt
Motorschritte | 200 | Standard Schrittmotor
Pulse/Umdrehung | 3200 | 200 × 16 = 3200 Pulse = 1 Umdrehung

Geschwindigkeit

Frequenz | U/min | U/s
800 Hz | 15 RPM | 0.25 U/s
1600 Hz | 30 RPM | 0.5 U/s
3200 Hz | 60 RPM | 1.0 U/s
8000 Hz | 150 RPM | 2.5 U/s

Chopper / Treiber

Parameter | Wert | Bedeutung
toff | 3 | Chopper aktiv (>0 = ein)
StealthChop | aktiv | leiser Betriebsmodus
RSENSE | 0.075Ω | Sense Widerstand auf der Platine
VM | 24V | Motorversorgungsspannung
