EmanuelKaefer/Open-robot-arm/doc/Software/Doku MicrokontollerSW[27.04.2026].odt

Dokumentation: Implementierung der Achssteuerung (Baseline-Setup)

1. Einleitung und Zielsetzung

Im Rahmen des Projekts (Steuerung eines 6-Achs-Roboterarms) wurde zunächst die Basisarchitektur für eine einzelne Achse entwickelt und validiert. Das Ziel dieser Phase war es, eine robuste Kommunikation mit dem Schrittmotortreiber (TMC5160) aufzubauen, eine deterministische Signalerzeugung für die Motorbewegung zu implementieren und ein sicheres, echtzeitfähiges Homing-Verfahren mittels Endschaltern zu evaluieren. Diese validierte Einzelachs-Architektur dient als Skalierungsgrundlage für das spätere 6-Achs-System.

2. Hardware-Abstraktion und Treiber-Kommunikation

Die Steuerung des Schrittmotors erfolgt über den Trinamic TMC5160 Treiber. Die Anbindung an den STM32F446-Mikrocontroller wurde in zwei logische Schichten unterteilt: Konfiguration (via SPI) und Bewegung (via STEP/DIR).

2.1 SPI-Kommunikation (Register-Konfiguration)

Für die Initialisierung und Überwachung des Treibers wurde eine SPI-Schnittstelle (SPI1) im Master-Modus konfiguriert.

- Implementierung: Es wurden spezifische Lese- und Schreibfunktionen (TMC_WriteReg, TMC_ReadReg) entwickelt, die das TMC-spezifische Protokoll (5 Byte pro Transfer: 1 Byte Adresse + 4 Byte Payload) umsetzen.
- Besonderheit: Das MSB (Most Significant Bit) des Adress-Bytes wird programmatisch modifiziert (Setzen auf 1 für Write, 0 für Read).
- Diagnose: Beim Systemstart werden Statusregister wie GSTAT und DRV_STATUS ausgelesen, um Parameter wie Undervoltage oder fehlende Chip-Select-Antworten vor dem Motorstart zu detektieren. Dies verhindert undefinierte Zustände, falls die Hardware nicht korrekt versorgt ist.

3. Echtzeitfähige Signalgenerierung (STEP/DIR)

Anstatt die STEP-Pulse per Software (z. B. Polling oder HAL_Delay) zu generieren, wurde eine hardwarenahe Timer-PWM-Lösung implementiert. Dies entlastet die CPU (wichtig für spätere kinematische Berechnungen von 6 Achsen) und garantiert ein jitterfreies Taktsignal.

3.1 Timer-Konfiguration (Hardware-PWM)

- Es wird Timer 1 (TIM1, Channel 1) im PWM-Modus verwendet.
- Frequenz-Berechnung: Die Funktion Step_SetFreqHz() berechnet dynamisch den Auto-Reload-Register (ARR) Wert basierend auf einem 1-MHz-Timer-Tick (erreicht durch einen Prescaler von 15 bei 16 MHz Systemtakt).
  - Formel: ARR=(ftimerfstep)−1
- Tastverhältnis (Duty Cycle): Das Compare-Register (CCR) wird dynamisch auf (ARR+1)/2 gesetzt, um ein konstantes Tastverhältnis von exakt 50 % bei allen Frequenzen zu gewährleisten, was für den TMC5160 optimal ist.

4. Sensorauswertung und Interrupt-System (EXTI)

Für die Endschalter (Limit Switches) wurde ein interruptbasiertes System (EXTI - External Interrupt) gewählt.

4.1 Design-Entscheidung: EXTI vs. Polling

Polling (das ständige Abfragen des Pin-Zustands in der Hauptschleife) wurde verworfen, da bei blockierenden Prozessen (z.B. UART-Übertragungen oder späteren Inverskinematik-Berechnungen) der Motor über den Endschalter hinaus in den mechanischen Anschlag fahren könnte. Der Hardware-Interrupt (EXTI) garantiert eine sofortige, deterministische Reaktion im Mikrosekundenbereich.

4.2 Skalierbare Pin-Auswahl

- Da das finale System 6 Endschalter benötigt, wurden die Pins strategisch so gewählt, dass keine EXTI-Line-Konflikte entstehen. Im STM32 teilen sich Pins mit derselben Nummer (z. B. PA10 und PC10) dieselbe Interrupt-Leitung.
- Gewähltes Mapping: PC10 (EXTI10), PC11 (EXTI11), PB12 (EXTI12), PB13 (EXTI13), PB14 (EXTI14) und PD2 (EXTI2). Somit hat jeder Endschalter eine eigene, diskrete Interrupt-Leitung.

4.3 Signalaufbereitung (Entprellung / Debouncing)

- Mechanische Schalter weisen ein Prellverhalten auf (Signal flackert beim Schließen). Um Mehrfachauslösungen des Interrupts zu verhindern, wurde in der Callback-Funktion (HAL_GPIO_EXTI_Callback) ein Software-Debounce implementiert. Dabei wird mittels HAL_GetTick() ein Zeitstempel geprüft; weitere Flanken innerhalb von 30 Millisekunden werden ignoriert.

5. Software-Architektur: Finite State Machine (FSM)

- Die Hauptlogik in der while(1)-Schleife wurde als Zustandsautomat (Finite State Machine) mit switch-case umgesetzt. Dies strukturiert den Programmablauf deterministisch:
- STATE_INIT: Startet SPI, schreibt TMC-Register, prüft die Kommunikation. Wechselt nur bei fehlerfreiem Treiberstatus in den nächsten Zustand.
- STATE_HOMING: Führt die Referenzfahrt durch. Der Motor wird mit einer langsamen, vordefinierten Frequenz (z. B. 200 Hz) gestartet.
- STATE_READY: Wartezustand für spätere Trajektorien-Befehle (UART-Parsing etc.).
- STATE_ERROR: Fängt Hardwarefehler (Undervoltage) oder Homing-Fehler ab.

6. Problemanalyse und Lösungsansätze (Troubleshooting)

Dieser Abschnitt ist extrem wertvoll für die Arbeit, da er zeigt, dass du iterativ und analytisch arbeitest.

6.1 Fehlerhafte HAL-Architektur-Integration (Interrupt-Verlust)

Problem: Der EXTI-Pin PC10 (Limit Switch) stoppte den Motor bei Betätigung zunächst nicht, obwohl der Pin in CubeMX korrekt auf GPIO_MODE_IT_FALLING konfiguriert war. Analyse: Die STM32-HAL-Architektur erfordert ein manuelles Aktivieren des NVIC (Nested Vectored Interrupt Controller) sowie das explizite Verknüpfen der Hardware-Interrupt-Vektoren in der Datei stm32f4xx_it.c. Diese fehlten im generierten Code. Lösung: Der Interrupt EXTI15_10_IRQn wurde im NVIC manuell mit Priorität 5 freigeschaltet. Zudem wurde der Handler EXTI15_10_IRQHandler implementiert, welcher den Hardware-Flag löscht und den User-Callback aufruft.

6.2 Stromspitzen und Schutzabschaltung (CC-Mode des Netzteils)

Problem: Nach Upload des Codes rotierte der Motor kurzzeitig sehr schnell, woraufhin das Labornetzteil in die Strombegrenzung (Constant Current - CC) ging. Analyse: Es gab zwei Faktoren:

Das Homing startete den Hardware-Timer (Step_Start()) in jedem Zyklus der while(1)-Schleife neu, was zu unsauberer Pulsausgabe führte.

Beim plötzlichen Stoppen durch den Endschalter ging der TMC5160 in den "Hold"-Zustand über. Bei unpassender Konfiguration der Registerwerte (speziell IHOLD_IRUN) forderte der Treiber den vollen Haltestrom an. Der hohe Strom bei stehendem Motor überstieg das Limit des Netzteils, was zu einem Spannungseinbruch führte. Lösung: Das Homing wurde durch ein "Start-Flag" gesichert, sodass der Motor nur einmalig angesteuert wird (if (!started)). Zusätzlich wurde beim Stopp-Event (stoprequest) der Haltestrom im Register 0x10 dynamisch von 0x00061008 (hoher Run-Strom) auf 0x00061002 (niedriger Hold-Strom) reduziert. Dadurch bleibt die Leistungsaufnahme beim Anhalten des Motors stabil unter der Netzteilgrenze. Zusätzlich erzwingt __HAL_TIM_MOE_DISABLE_UNCONDITIONALLY(&htim1) einen sofortigen Hardware-Stopp des PWM-Signals beim Homing-Event.

Tipp für später: Speichere dir diesen Text ab. Wenn du später in der Arbeit ein Kapitel über "Entwicklung der Mikrocontroller-Firmware" schreibst, hast du hier bereits die perfekten Zwischenüberschriften und Argumentationsketten!

Anmerkung Interrupts:„Um die Echtzeitanforderungen der Endschalter zu erfüllen, wurde das Hardware-Interrupt-System (EXTI) des STM32 genutzt. Dabei wurde die von der STM32-HAL vorgegebene Callback-Architektur verwendet. Die physikalische Interrupt Service Routine (ISR, EXTI15_10_IRQHandler) dient lediglich als Einsprungpunkt und delegiert die Hardware-Verwaltung (wie das Löschen des Pending-Flags) an die HAL-Schicht. Die eigentliche Applikationslogik – der Notstopp des Motors – wurde isoliert in der Callback-Funktion (HAL_GPIO_EXTI_Callback) implementiert. Diese Trennung von Hardware-Verwaltung und Steuerungslogik erhöht die Wartbarkeit und Sicherheit des Codes.“

Achsen homing

1. Die Mathematik (für deine Dokumentation)

Wir gehen von einem Standard-Schrittmotor mit 1.8° pro Vollschritt aus (200 Schritte pro Umdrehung).

- Schritte pro Motorumdrehung: 200×16 (Microsteps)=3200 Schritte
- Schritte pro Getriebeausgangsumdrehung: 3200×20 (Gear Ratio)=64000 Schritte
- Winkeldifferenz (Δrad): |−0.3470−0.0174|=0.3644 rad
- Benötigte Schritte: 0.3644/2π×64000≈3711.7→3712 Schritte

Zusammenfassung des Ablaufs:

1. Das Programm startet das Homing und der Motor dreht langsam auf den Schalter zu.
2. Der Schalter wird gedrückt → EXTI Callback feuert → Step_Stop() hält sofort an und setzt stoprequest = 1.
3. Die Main-Schleife sieht stoprequest, berechnet die Differenz in Radiant und wandelt sie in genau 3712 Schritte um.
4. Die Drehrichtung wird umgekehrt.
5. Step_Start_Exact(3712) wird aufgerufen.
6. Der Timer erzeugt Pulse. Bei jedem Puls zählt der PeriodElapsedCallback mit.
7. Bei Puls 3712 stoppt der Callback den Motor hart, setzt currentState = STATE_READY und der Roboter ist exakt an seiner kinematischen Nullposition!

Anmerkung SPI auf breadboard

Für deine wissenschaftliche Arbeit:

Das ist ein Geschenk für deine Doku! Du kannst ein ganzes Unterkapitel darüber schreiben: "Einfluss parasitärer Effekte beim Breadboard-Prototyping auf die SPI-Kommunikation". Darin beschreibst du:

1. Signalintegrität bei fliegender Verdrahtung war ungenügend.
2. Falsche SPI-Antworten führten zu fehlerhafter Initialisierung.
3. Lösungsansatz: Reduktion der SPI-Baudrate und Einfügen einer Boot-Verzögerung für den Motor-Treiber.

"Transition vom Solderless-Breadboard-Prototypen zur gelöteten Lochrasterplatine zur Minimierung von parasitären Effekten und Kontaktwiderständen."
