EmanuelKaefer/Open-robot-arm/doc/template/template_mama/.template_mama/main.pdf

# Entwicklung eines 6dof Roboterarms

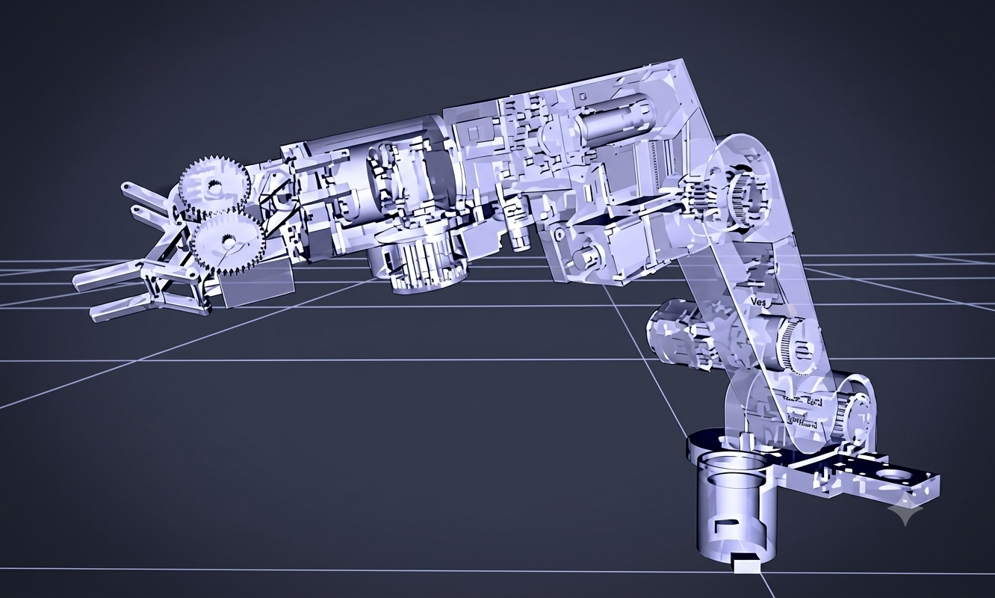
[picture p5: figure]

### ASIT-Projekt verfasst von

## Matteo Gassler Emanuel Kafer ¨ Alexander Dick

### Betreuer: Prof. Dr. Gerhard Gaube

### HTBLA Saalfelden

### Abteilung fur Elektrotechnik ¨

### Abgabevermerk:

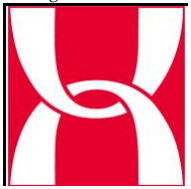
[picture p6: figure]

Saalfelden, 19 Juni 2026 | ubernommen von: ¨

# Inhaltsverzeichnis

1 Projektuberblick ¨ | 1
2 Low Level Architektur und Steuerung | 3
3 High Level Software | 13
4 Mechanik | 14
5 Elektronikdesign und Hardware-Architektur | 18
Quellenverzeichnis | 25

ii

# 1 Projektuberblick ¨

### 1.1 Zielsetzung

Da die Entwicklung unseres 6dof Roboterarms im Rahmen des Faches ASIT erfolgt und der Lernerfolg im Vordergrund steht konnten wir uns die Aufgabenstellung selbst stellen und hatten dabei keine großen Einschrankungen. Wir haben uns dazu ¨ entschieden das der Roboterarm als Mindestanforderung eine Pick and Place Operation, also ein Objekt aufheben und wo anders platzieren konnen soll. Als optionale weitere ¨ Herausforderung soll man uber ein Graphical user Interface Koordinaten eingeben ¨ konnen zu denen sich der Arm dann bewegt. Nach einem Schuljahr Arbeit an dem ¨ Projekt haben wir uns entschieden es als Diplom und Abschlussarbeit fortzusetztn.

### 1.2 Umsetzungsstand der Software

Der aktuelle Umsetzungsstand der Software umfasst ein vollstandiges Initialisieren ¨ der Motortreiber und ein sequentielles Homing. Dieses sequentielle Homing wird im verlauf des Projekts aber noch durch ein Absolut encoderhoming ersetzt.

### 1.3 Umsetzungsstand der Elektronik

Der aktuelle Entwicklungsstand der Elektronik basiert auf der Evaluierung der Messdaten unserer ersten Testplatine. Derzeit werden die finalen Erganzungen im Schaltplan ¨ vorgenommen und mittels Simulationen verifiziert.

### 1.4 Umsetzungsstand des Mechanischen

Der aktuelle Umsetzungsstand der Mechanik, ist dass der Roboter Arm nahe null Spiel in den Getrieben hat und nun einen Geradlinigen Schwerpunkt auf weißt. Durch den Geradlinigen Aufbau, steht der Arm nun Stabiler und die Massen verteilt sich berechenbarer. Durch großere Motoren und besseren Getrieben hat der Arm mehr ¨

1 Projektuberblick ¨

Drehmoment pro gelenk. Zudem wird durch eingeplante Hallsensoren die Bewegung Uberwacht werden, somit wird der arm genauer. ¨

# 2 Low Level Architektur und Steuerung

Dieses Kapitel beschreibt die Implementierung der zentralen Low-Level-Robotersteuerung, die auf einem Mikrocontroller lauft. Sie stellt das funktionale Bindeglied zwischen ¨ der mechanischen Konstruktion (siehe 4) und der elektrischen Leistungselektronik (siehe 5) dar. Die Firmware wurde auf Hardwareabstraktionsebene (STM32CubeHAL)
basierendem C fur einen STM ¨ | 32F446-Mikrocontroller in der Entwicklungsumgebung
STM32CubeIDE entwickelt [1]. Ziel der Softwarearchitektur ist es, harte Echtzeitan-
forderungen fur die synchrone Ansteuerung von sechs Schrittmotoren zu erf ¨ | | ullen ¨
und gleichzeitig eine hochgradig skalierbare Basis fur zuk ¨ | unftige Pfadplanungen zu ¨
schaffen.

### 2.1 Implementierung der 6 Achsen und Skalierbarkeit

Bei der Ansteuerung eines 6-Achs-Roboterarms fuhrt die Zuweisung von Mikrocontroller- ¨ Pins als Einzelvariablen und die statische Zuweisung von Peripherie-Registern schnell
zu eingeschranktem und fehleranf ¨ | alligem Programmcode. Um dies zu vermeiden, ¨
wurde eine Pointer-Array-basierte Datenstruktur implementiert. Anstatt jede Achse separat zu adressieren, werden Pointer auf die entsprechenden Hardware-Timer
(TIM HandleTypeDef), PWM-Kanale sowie die GPIO-Ports f ¨ | ur Richtungs- ( ¨ | DIR) und
Chip-Select-Signale (CS) in globalen Arrays gekapselt.[1]
Durch diese Entkopplung von physikalischer Hardware und Steuerungslogik kann
jede Achse uber einen simplen Index angesprochen werden. Dies erm ¨ | oglicht es, Kern- ¨
funktionen wie das Starten und Stoppen der Motoren oder das Homing uber alle ¨ Treiber mittels einfacher Schleifenkonstrukte umzusetzen, was die Skalierbarkeit und Wartbarkeit des Systems maßgeblich erhoht. ¨

### 2.1.1 Richtungssignale (DIR-Pins)

Zur Bestimmung der Drehrichtung benotigt jeder Schrittmotortreiber einen DIR-Pin ¨ (Direction). Ein High-Pegel (1) bewirkt eine Drehung im Uhrzeigersinn, ein Low-Pegel
(0) eine Drehung gegen den Uhrzeigersinn. Um dies fur alle sechs Motoren effizient ¨

2 Low Level Architektur und Steuerung

und skalierbar umzusetzen, wurden Arrays eingesetzt.

1 GPIO_TypeDef * DIR_PORTS [6] = { TMC1_DIR_GPIO_Port , TMC2_DIR_GPIO_Port ,

TMC3_DIR_GPIO_Port , TMC4_DIR_GPIO_Port , TMC5_DIR_GPIO_Port ,

TMC6_DIR_GPIO_Port };

2 | uint16_t | DIR_PINS [6] | = { TMC1_DIR_Pin , TMC2_DIR_Pin , | TMC3_DIR_Pin

, TMC4_DIR_Pin , TMC5_DIR_Pin , TMC6_DIR_Pin };

Programmcode 2.1: Arrays fur DIR-Pins/Ports ¨

### 2.1.2 Geschwindigkeitsregelung (STEP-Pins)

Die Geschwindigkeitsregelung uber die STEP-Pins wird mittels Hardware-Pulsweitenmodulation ¨ (PWM) durch Timer implementiert. Die Motortreiber benotigen zur Vorgabe der Ge- ¨ schwindigkeit ein Frequenzsignal am STEP-Eingang. Dies ist ebenfalls durch Arrays realisiert.

1 | TIM_HandleTypeDef * AXIS_TIMERS [6] = {& htim2 , &htim1 , &htim3 , &htim4 , &
| htim8 , & htim10 };
2 | uint32_t AXIS_CHANNELS [6] = { TIM_CHANNEL_1 , TIM_CHANNEL_1 ,
| TIM_CHANNEL_1 , TIM_CHANNEL_1 , TIM_CHANNEL_1 , TIM_CHANNEL_1 };

Programmcode 2.2: Arrays fur STEP-Timer/Channels ¨

### 2.1.3 Vergleich: Mit und ohne Array-Abstraktion

Ohne Array-Abstraktion wurde die Motoransteuerung mehrere if-else-Bl ¨ | ocke erfordern. ¨
Als Beispiel wird die Funktion zum Stoppen einer Motor-PWM von drei Achsen gezeigt.

Hardcodierte Hardware-Zuordnung

1 | void Step_Stop_HardCoded ( uint8_t ax) {
2 | if (ax == 0) {
3 | HAL_TIM_PWM_Stop (& htim2 , TIM_CHANNEL_1 ) ;
4 | HAL_TIM_Base_Stop_IT (& htim2 ) ;
5 | }
6 | else if (ax == 1) {
7 | HAL_TIM_PWM_Stop (& htim1 , TIM_CHANNEL_1 ) ;

8 | HAL_TIM_Base_Stop_IT (& htim1 ) ;
9 | }
10 | else if (ax == 2) {
11 | HAL_TIM_PWM_Stop (& htim3 , TIM_CHANNEL_1 ) ;
12 | HAL_TIM_Base_Stop_IT (& htim3 ) ;
13 | }

14

15 }

Programmcode 2.3: Motor-Stopp ohne Array-Abstraktion (Anti-Pattern)

Das fuhrt zu mehreren Problemen: ¨

- Code-Duplikation: Die gleiche Logik wird sechsmal wiederholt.
- Wartbarkeit: Anderungen m ¨ | ussen sechsmal vorgenommen werden. ¨
- Fehleranfalligkeit ¨ | : Es ist leicht, einen Achsen-Fall zu vergessen oder falsch
zuzuordnen.
- Skalierbarkeit: Das Hinzufugen oder Entfernen einer Achse erfordert massive ¨ Codeanderungen. ¨

### 2.2 Initialisierung und SPI-Kommunikation der

### Motortreiber

### 2.2.1 SPI-Protokoll

Das Serial Peripheral Interface (SPI) ist ein serielles Hochgeschwindigkeits-Bussystem, das vorwiegend zur Kommunikation von Mikrocontrollern mit Peripheriegeraten auf ¨ Platinen dient. SPI ist vollduplexfahig, das heißt, dass bei jedem Takt ein Bit vom ¨ Master an den Slave und umgekehrt gesendet wird. Es besteht aus drei Leitungen: MOSI (Master Out −→ Slave In), MISO (Master In ←− Slave Out) und SCK (Serial Clock). Hinzu kommt eine CS-Leitung (Chip Select), die vom Master separat zu jedem Slave gefuhrt werden muss. Nur wenn diese CS-Leitung auf LOW gezogen wird, ¨ sendet oder empfangt der Slave Daten. Die Kommunikation erfordert in der Regel ¨ zwei Ubertragungszyklen. Im ersten Zyklus sendet der Master ein Kommando an den ¨

Slave. Da der Slave zu diesem Zeitpunkt die Antwort noch nicht vorbereitet hat, sendet
er irrelevante Dummy-Daten zuruck. In der zweiten ¨ | Ubertragung sendet der Master ¨

2 Low Level Architektur und Steuerung

einen leeren Datensatz, um das Taktsignal aufrechtzuerhalten, woraufhin der Slave die
bereitgestellte Antwort ubermittelt. Die ¨ | Ubertragungen erfolgen jeweils synchron [ ¨ | 2].

SPI-Modi

Es existieren vier SPI-Modi (0-3). Diese definieren sich wie folgt:

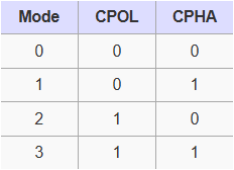
[picture p7: figure]

Abbildung 2.1: Diagramm der SPI-Modi

CPOL (Clock Polarity):

- 0: Takt ist im Ruhezustand LOW, ein Wechsel auf HIGH zahlt als steigende ¨ Taktflanke.
- 1: Takt ist invertiert (im Ruhezustand HIGH), ein Wechsel auf LOW zahlt als ¨ steigende Taktflanke.

CPHA (Clock Phase):

- 0: Daten werden bei der ersten Taktflanke (abhangig von CPOL) eingelesen und ¨ bei der darauffolgenden ausgegeben.
- 1: Daten werden bei der zweiten Taktflanke eingelesen und bei der ersten ausgegeben.

### 2.2.2 Initialisierung der Motortreiber

Die verwendeten Schrittmotortreiber vom Typ TMC5160 in Kombination mit NEMA-17-Schrittmotoren erfordern eine initiale Konfiguration ihrer internen Register, um Parameter wie Haltestrom, Betriebsstrom (Run-Current) und den Chopper-Modus festzulegen. Diese Kommunikation erfolgt uber einen geteilten SPI-Bus. Um die Treiber ¨ individuell adressieren zu konnen, wird vor jedem Datentransfer der spezifische Chip- ¨ Select-Pin (CS) der Zielachse auf ein niedriges Potential (LOW) gezogen. Die TMC5160 erfordern den Betrieb im SPI-Modus 3 (siehe 2.1) [3].
Um Fehler direkt bei der Initialisierung der Treiber zu erkennen, wurde eine Validierung implementiert, die zwingend erfolgreich durchlaufen werden muss. Nach dem Schreiben der Konfigurationsdaten liest der Mikrocontroller das globale Statusregister
(GSTAT) sowie aktuelle Treiberzustande zur ¨ | uck. Nur wenn das System valide Antwor- ¨
ten (GSTAT = 0) detektiert, wird die Steuerung freigegeben. Storsignale oder fehlende ¨ Hardware-Verbindungen werden so unmittelbar beim Systemstart erkannt und fuhren ¨ zu einem sicheren Systemabbruch.
Die gewahlte Konfiguration der Motortreiber stellt sich wie folgt dar: ¨

Tabelle 2.1: Konfiguration der TMC5160T-Register via SPI

Register (Wert) | Funktion
GSTAT (0x01) = 0x00000007 | Setzt das globale Statusregister zuruck. L ¨ | oscht den Fehlerspei- ¨
| cher fur Reset, Unterspannung der Charge-Pump und Driver- ¨ Shutdown vor dem Testlauf.
GCONF (0x00) = 0x00000005 | Der treiber nutzt die Analoge Stromskalierung und den Internen
| Sense Wiederstand
IHOLD IRUN (0x10) = 0x0008100A | Konfiguriert den Motorstrom: Setzt den Fahrstrom (IRUN) auf
52 %, den Haltestrom im Stillstand (IHOLD) auf 32 % sowie eine
Verzogerung ( ¨ | IHOLDDELAY) von 20µs fur die Stromabsenkung. ¨
CHOPCONF (0x6C) = 0x100C0403 | Konfiguration des Chopper-Verfahrens. Aktiviert den SpreadCycle-
Modus und definiert das Signal-Timing (TOFF, TBL).
[3]

### 2.3 Finite State Machine (Endlicher Zustandsautomat)

Um die auf dem Mikrocontroller laufende Software deterministisch zu gestalten und Deadlocks zu verhindern, kommt eine Finite State Machine (FSM) zum Einsatz. Eine FSM ist ein mathematisches Modell fur Systeme, die sich zu jedem Zeitpunkt in ¨

2 Low Level Architektur und Steuerung

genau einem von mehreren Zustanden befinden. Eine FSM besteht strukturell aus den ¨ folgenden Komponenten [4]:

- Zustande (States): Die verschiedenen operativen Phasen des Systems. ¨
- Startzustand (Initial State): Der Zustand, in dem die FSM initialisiert wird.
- Uberg ¨ | ange (Transitions): Die definierten Bedingungen f ¨ | ur den Wechsel zwischen ¨

Zustanden. ¨
- Ereignisse (Inputs): Die Trigger, die einen Zustandswechsel bewirken.
- Aktionen (Outputs): Die ausfuhrenden Operationen der FSM. ¨

### 2.3.1 Zust¨ande

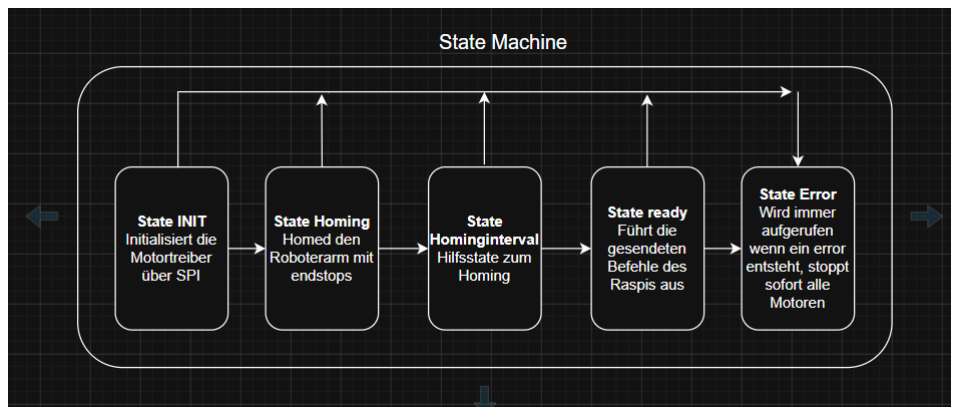
[picture p8: figure]

Abbildung 2.2: Diagramm der Finite State Machine

Fur den entwickelten Roboterarm wurden die Zust ¨ | ande ¨ | STATE INIT, STATE HOMING,

STATE HOMING OFFSET, STATE READY und STATE ERROR definiert. Als Startzustand dient
STATE INIT, da vor dem regularen Betrieb eine Treiberinitialisierung zwingend erfor- ¨ derlich ist. Die Spezifikationen der Zustande gestalten sich wie folgt: ¨

Tabelle 2.2: Zustande der ¨ | Finite State Machine
Zustand | Funktion
STATE INIT | Initialisiert die Motortreiber uber den SPI-Bus und konfiguriert die Register- ¨
parameter.
STATE HOMING | Fuhrt den ersten Teil der kinematischen Referenzfahrt durch, bei der die ¨
Achse bis zur Auslosung des Endschalters verfahren wird. ¨

STATE HOMING OFFSET Fuhrt den zweiten Teil der kinematischen Referenzfahrt durch. Die Achse ¨ verfahrt vom Endschalter um einen definierten Offset auf die finale Home- ¨ Position.

STATE READY | Der regulare Betriebszustand. Der Mikrocontroller verarbeitet eingehende ¨
Befehle und setzt diese in Trajektorien um.
STATE ERROR | Fehlerzustand. Alle Motoren werden umgehend gestoppt und ein Fehlercode
wird ausgegeben. Ein manueller Reset ist erforderlich.

### 2.4 Regul¨arer Betrieb und Trajektoriensteuerung

Im regularen Punkt-zu-Punkt-Betrieb w ¨ | urde ein abruptes Anfahren der Schrittmotoren ¨
zu extrem hohen mechanischen Belastungen, starken Schwingungen und eventuellen Schrittverlusten fuhren. Um eine geschmeidige Bewegung zu garantieren wird eine ¨ Trajektorienplanung mit trapez- bzw. dreieckformigem Geschwindigkeitsprofil auf ¨ dem Mikrocontroller ausgefuhrt. ¨

### 2.4.1 Mathematische Umsetzung des Trapezprofils

Das Geschwindigkeitsprofil unterteilt die Bewegung einer Achse grundsatzlich in drei ¨
Phasen: Beschleunigung (a), Konstantfahrt (vmax) und Verzogerung ( ¨ | −a).

Unterscheidung zwischen Trapez- und Dreiecksprofil

Vor Beginn einer Bewegung wird fur jede Achse gepr ¨ | uft, ob die zu fahrende Di- ¨
stanz Si ausreicht, um die gewunschte Maximalgeschwindigkeit ¨ | vmax,i und damit das
Trapezprofil zu erreichen. Die dafur erforderliche Mindestdistanz berechnet sich zu: ¨

Smin,i =

v

2
max,i
ai

(2.1)

Ist Si < Smin,i

, wird die Maximalgeschwindigkeit nicht erreicht. Das Profil wird zu einem Dreiecksprofil reduziert.

2 Low Level Architektur und Steuerung

Mehrachs-Synchronisation (tsync)

Damit sich der Endeffektor des Roboterarms geradlinigen und synchrone bewegt, mussen alle sechs Achsen exakt zeitgleich an ihrer jeweiligen Zielposition ankommen. ¨
Dafur wird zun ¨ | achst f ¨ | ur jede Achse ¨ | i die theoretische Gesamtfahrzeit ti berechnet:

ti =

Si
vmax,i

+

vmax,i
ai

falls Trapezprofil

2 ·

# qSi

ai

falls Dreiecksprofil

(2.2)

Die langsamste Achse bestimmt die globale Synchronisationszeit tsync des Gesamtsystems:
tsync = min(t1, t2, . . . , t6) | (2.3)

Anschließend werden die Geschwindigkeiten vsynced,i aller schnelleren Achsen skaliert,
sodass ihre Bewegung exakt uber die Zeit ¨ | tsync gestreckt wird. Die beschleunigung
bleibt hierbei unabhangig der zu fahrenden Schritte gleich da die ver ¨ | anderung von ¨
vmax ausreicht um alle moglichen szenarien ausreichend abzudecken. ¨

### 2.4.2 Softwareimplementierung auf dem STM32

Die Generierung der Schrittfrequenzen erfolgtchtzeitnah uber eine periodische Interrupt- ¨ Service-Routine (ISR) mittels eines Timer-Interrupts.

Dynamische Frequenzanpassung via ARR

Die Geschwindigkeit eines Schrittmotors ist proportional zur Frequenz der STEP-
Impulse. Der STM32 steuert diese Frequenz uber das Auto-Reload-Register ( ¨ | ARR) des
jeweiligen Timers. In jedem Regelzyklus der ISR wird die neue Soll-Geschwindigkeit v(t) berechnet und das ARR-Register dynamisch nach folgender Formel aktualisiert:

ARRi =

ftimer
(PSCi + 1) · fstep,i
− 1 | (2.4)

wobei ftimer die Quarzfrequenz des Mikrocontrollers und PSC den eingestellten Prescaler bezeichnet.

### 2.4.3 Systemstabilit¨at und Troubleshooting (Praktische

Herausforderungen)

Bei der Umsetzung der Trajektoriensteuerung zeigten sich in der Praxis hardware- und
softwareseitige Phanomene, die gezielt gel ¨ | ost werden mussten, um einen stabilen Lauf ¨
zu garantieren.

Timer-Lockup und Auto-Reload Preload (TIM CR1 ARPE)

Beim dynamischen Herabsetzen des ARR-Wertes wahrend der Bremsphase trat verein- ¨ zelt ein Einfrieren des Timers bzw. ein Kriecheffekt mit minimaler Frequenz (≈ 15 Hz)
auf. Ursache: Wenn der aktuelle Zahlerstand des Timers ( ¨ | CNT) im Moment des Um-
schreibens bereits großer war als der neue, kleinere ¨ | ARR-Wert, zahlte der Timer bis zum ¨
Maximum des 16-Bit-Registers (65.535) hoch, bevor ein Overflow stattfand. Losung: ¨ Aktivierung des Auto-Reload Preload Bits (ARPE) im Kontrollregister TIMx CR1. Da-
durch wird das neue ARR gepuffert und erst beim nachsten regul ¨ | aren Update-Event ¨
(UEV) ubernommen. ¨

Besonderheiten der Advanced Timers (TIM1 / TIM8)

Wahrend die Allzweck-Timer ( ¨ | TIM2–TIM4) direkt PWM-Signale ausgaben, blieben
die Ausgange von ¨ | TIM1 und TIM8 zunachst pegellos. ¨ | Ursache: TIM1 und TIM8 sind
prazise ¨ | Advanced Control Timer. Diese verfugen ¨ | uber eine Totzeit-Generierung und ¨
eine Notabschaltung (Break Input), weshalb die Ausgange standardm ¨ | aßig hochohmig ¨
geschaltet sind. Losung: ¨ | Explizites Setzen des Main Output Enable Bits (MOE) im
Break-and-Dead-Time-Register (BDTR) via Macro:
1 | __HAL_TIM_MOE_ENABLE (& htim1 ) ;
2 | __HAL_TIM_MOE_ENABLE (& htim8 ) ;

Programmcode 2.4: Freischaltung der Advanced Timer Ausgange ¨

Fließkommarundung und Kriechphasen-Eliminierung

Durch Akkumulation von Fließkomma-Rundungsfehlern (float-Prazision) in der Ite- ¨ rationsschleife erreichte die Differenz zwischen Ist- und Zielposition in Grenzfallen nie ¨ exakt Null. Dies fuhrte dazu, dass der Motor kurz vor dem Ziel in einer unendlichen ¨

2 Low Level Architektur und Steuerung

Kriechphase mit Minimalfrequenz verharrte. Losung: ¨ | Einfuhrung einer Abbruch- ¨
schwelle. Unterschreitet die Restdistanz einen Wert von 0,5 Mikroschritten, wird die Profilberechnung hart beendet und der PWM-Timer gestoppt. Mathematischer Nachweis der Toleranz: Bei 16 Mikroschritten pro Vollschritt, einem 1,8◦
-Motor und einer
1 : 20 Getriebeubersetzung entspricht eine Abweichung von 0,5 Mikroschritten: ¨

∆φ =

1,8◦
16 · 20 · 0,5 = 0,0028125◦ ≪ 1
| ◦
(2.5)

Die Positioniergenauigkeit liegt somit um Großenordnungen unterhalb der geforderten ¨ 1

◦
-Toleranzgrenze.

# 3 High Level Software

### 3.1 Ausblick

Die High-Level-Software auf dem Raspberry Pi ermoglicht die Eingabe kartesischer ¨
Zielkoordinaten fur den Endeffektor ¨ | uber ein Graphical User Interface (GUI). Diese ¨
kartesischen Koordinaten (x, y, z) werden mithilfe der Python-Bibliothek IKpy uber ¨ inverse Kinematik in sechs Gelenkwinkel in Radiant transformiert. Zudem lasst sich ¨ uber die GUI die maximale Geschwindigkeit definieren, auf welche die Motoren ¨
beschleunigen durfen. Da der Fokus der bisherigen Entwicklung prim ¨ | ar auf der Low- ¨
Level-Software lag, befindet sich die High-Level-Implementierung noch in einer fruhen ¨ Projektphase.

# 4 Mechanik

### 4.1 Entwicklungsansatz und Design-Entscheidungen

### 4.1.1 Ausgangssituation

Das Projekt verfolgt das Ziel, einen kostengunstigen, modularen Roboterararm mit ¨ sechs Freiheitsgraden zu entwickeln. Die Hauptanforderungen waren:

- Modulare Architektur: Teilweise Unabhangige Entwicklung, was dadurch Aus- ¨ tausch einzelner Komponenten vereinfacht
- Additive Fertigung: Moglichst einfache Fertigungsart um Diy zu sein ¨
- Open-Source-Prinzip: Vollstandige CAD-Dateien offen verf ¨ | ugbar ¨
- Kostengunstigkeit ¨ | : Minimierung von gekauften Komponenten durch intelligen-
tes Design

### 4.1.2 Design-Aufbau

Segmentierter Aufbau

Der Arm wurde in 6 funktionale Segmente unterteilt, die jeweils einen Freiheitsgrad realisieren:

Segment | DOF | Bewegung | Komponenten
Base | – | Stativ | Strukturrahmen, Befesti-gungspunkte
Shoulder | 1 | Vertikale Rotation (Yaw) | Motor, Getriebe, Hall Sen-sor
Upper Arm | 2 | Pitch & Roll | Motor, Getriebe, Hall Sen-sor
Forearm | 1 | Ellbogen-Pitch | Motor
Wrist | 2 | Pitch & Roll | Motor, Ubsetzung ¨
Gripper | – | Greifbewegung | 2-Finger-Greifer, Servo

Tabelle 4.1: Segmentierung des Roboterarms mit Freiheitsgraden

Iterative Verbesserungen (V1 bis V6)

Der Designprozess durchlief mehrere Versionsschritte:

- V1–V3: Konzeptphase mit grundlegenden Geometrien und ersten Motorintegrationen
- V4: Optimierung der Gelenkgeometrien, Reduktion von Spielraumen, erste Kolli- ¨ sionstests
- V5: Produktionsreife Version mit verfeinerten Toleranzen, optimierter Massenverteilung und vollstandiger CAD-Dokumentation ¨
- V6 Aktuell: Große Anderungen durch Fehlern welche in V ¨ | 5 waren

### 4.2 Konstruktive L¨osungsans¨atze

### 4.2.1 Design choices und Hardware wahl

Die Antriebselemente wurden nach folgenden Kriterien ausgewahlt: ¨

- Nema 17 und Nema 23 Motoren: Fur pr ¨ azise Kontrolle durch Micro-Stepping. ¨
- Getriebe: In V6 wurden 20:1 Cycloidal-Drive-Getriebe verwendet, da diese kaum merkbares Spiel aufweisen.

Berechnung der theoretischen und realen Nutzlast

Um die tatsachliche Nutzlast (Payload) des Roboterarms am Endeffektor zu ermit- ¨ teln, muss das theoretische maximale Drehmoment dem statischen Eigengewicht der bewegten Struktur gegenubergestellt werden. Der Basis-Motor wird hierbei nicht ¨ berucksichtigt, da sein Gewicht nicht gegen die Schwerkraft gehoben werden muss. ¨

Theoretisches Gesamtdrehmoment: Der an der Schulterachse verwendete Nema 23 Schrittmotor liefert ein maximales Haltemoment von MMotor = 2 Nm. Durch die 20-fache Untersetzung des Cycloidal-Getriebes (i = 20) ergibt sich ein theoretisches Gesamtdrehmoment am Schultergelenk von:

Mgesamt = MMotor · i = 2 Nm · 20 = 40 Nm

4 Mechanik

Bei einer maximalen Auslage (Reach) von rmax = 0, 5 m resultiert daraus eine theoretische maximale Hebekraft Fmax, die ohne Berucksichtigung des Eigengewichts senkrecht ¨ nach unten wirken darf:

Fmax =

Mgesamt

rmax

=

40 Nm
0, 5 m = 80 N

Einfluss von Eigengewicht und Schwerkraft: Von diesem theoretischen Maximum muss das Drehmoment MEigen abgezogen werden, welches durch das Eigengewicht des ausgestreckten Arms entsteht. Das bewegte Gesamtgewicht mbewegt setzt sich aus den 3D-gedruckten Strukturteilen (ca. 1, 91 kg) und den mitgehobenen Motoren (ein Nema 23 und drei Nema 17, ca. 2, 30 kg) zusammen.

Fur eine statische Worst-Case-Absch ¨ | atzung nehmen wir eine Gesamtmasse von ¨ | mbewegt =
4, 21 kg an. Der gemeinsame Massenschwerpunkt wird zur Vereinfachung in der Mitte der Auslage bei rS = 0, 25 m angenommen. Bei der Erdbeschleunigung (g = 9, 81 m/s²
| | )
ergibt sich:
| MEigen = mbewegt · g · rS
| MEigen = 4, 21 kg · 9, 81m
s

2

- 0, 25 m ≈ 10, 33 Nm

Reale statische Nutzlast: Das verbleibende Drehmoment, das fur die eigentliche ¨ Nutzlast am Endeffektor (MNutz) zur Verfugung steht, ist die Differenz aus dem ¨ Gesamtdrehmoment und dem Eigengewicht:

MNutz = Mgesamt − MEigen = 40 Nm − 10, 33 Nm = 29, 67 Nm

Damit ergibt sich die maximal hebbare reale Masse mNutz am Greifer bei voller Auslage von 0, 5 m:

mNutz =

MNutz
rmax · g

=

29, 67 Nm
0, 5 m · 9, 81m
s

2

≈ 6, 05 kg

Hinweis: Dies stellt eine rein statische Betrachtung dar. In der Praxis verringern der mechanische Wirkungsgrad der gedruckten Getriebe sowie dynamische Tragheitsmomente bei der ¨ Beschleunigung die tatsachliche Nutzlast. ¨

### 4.3 Zukunftige Entwicklung (V6) ¨

Version 6 wird mit verbesserten Aspekten geplant:

- Optimierte Massenverteilung fur pr ¨ azisere Kinematik ¨
- Zusatzliche Sensorsupports (position durch Hallsensor) ¨
- Verbesserte Zuganglichkeit f ¨ | ur Wartung und Kalibrierung ¨

# 5 Elektronikdesign und

# Hardware-Architektur

Dieses Kapitel beschreibt die Konzeptionierung, Komponentenauswahl und das Plati-
nendesign (PCB) fur die Steuerung des ¨ | 6-DOF-Roboterarms. Die zu entwickelnde Plati-
ne fungiert als zentrales Management-System des Roboters. Sie nimmt die High-Level-Befehle des Raspberry Pi 4B entgegen, verarbeitet diese auf einem STM32F446RET6-
Chip und steuert uber eine dedizierte Leistungselektronik sechs TMC ¨ | 5160T Pro v1.0
Schrittmotortreiber an. Neben der Signalintegritat steht die stabile Spannungsversor- ¨ gung der NEMA-17-Motoren im Vordergrund.

### 5.1 Systemarchitektur und Signalfluss

In diesem Abschnitt wird das grundlegende Blockschaltbild der Elektronik beschrieben. Das System teilt sich in drei logische Ebenen auf: High-Level-Recheneinheit (Raspberry Pi), Low-Level-Steuerung (STM32) und die Leistungsebene (TMC5160T Treiber). Die
Kommunikation erfolgt uber UART (Pi zu STM ¨ | 32) und einen gemeinsamen SPI-Bus
fur die Konfiguration der Treiberstufen. ¨

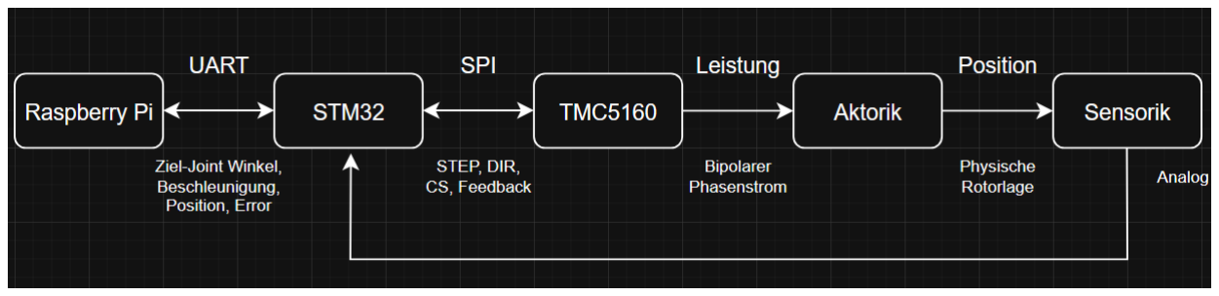
[picture p9: figure]

Abbildung 5.1: Blockschaltbild der Elektronik-Architektur

[1]

### 5.2 Komponentenauswahl und Begrundung ¨

### 5.2.1 Zentraler Mikrocontroller (STM32F446RET6)

Die Wahl fiel auf den STM32F446RET6 im LQFP64-Gehause. Ausschlaggebend hierf ¨ | ur¨
waren die hohe Taktfrequenz von 180 MHz sowie das Vorhandensein von ausreichend Hardware-Timern, um sechs Schrittmotoren unabhangig und synchron per Hardware- ¨
PWM anzusteuern (siehe 2.1.2). Zudem bietet der Chip genugend GPIOs f ¨ | ur die sechs ¨
separaten Chip-Select-Leitungen des SPI-Busses.

### 5.2.2 Schrittmotortreiber (TMC5160T Pro v1.0)

Fur die Ansteuerung der NEMA- ¨ | 17-Schrittmotoren werden TMC5160T Pro v1.0 Mo-
dule genutzt. Diese Treiber bieten neben einer hohen Stromtragfahigkeit vor allem ¨ die Anbindung uber einen geteilten SPI-Bus, was eine dynamische Konfiguration der ¨ Motorstrome erlaubt. ¨

### 5.3 Mikrocontroller-Infrastruktur und Peripherie

Fur den stabilen Betrieb des STM ¨ | 32F446RET6 wurde eine dedizierte Infrastrukturbe-
schaltung auf dem Board implementiert. Diese sichert die Signalqualitat, die Program- ¨ mierbarkeit und optionale Diagnosemoglichkeiten. ¨

### 5.3.1 Taktversorgung (HSE) und Reset-Schaltung

Um die harten Echtzeitanforderungen bei der synchronen Generierung der Schrittfre-
quenzen zu erfullen, wird der interne RC-Oszillator des STM ¨ | | 32 durch einen prazisen, ¨
externen Quarzoszillator (High-Speed External, HSE) ersetzt. Dieser ist mit zwei Lastkondensatoren (C10, C11) und einem Serienwiderstand (R3) beschaltet. Die manuelle
Systemrucksetzung wird ¨ | uber einen physischen Taster realisiert, der ¨ | uber ein RC- ¨
Glied hardwareseitig entprellt ist, um transiente Storungen auf der ¨ | NRST-Leitung zu
blockieren.

5 Elektronikdesign und Hardware-Architektur

### 5.3.2 Programmierschnittstelle (SWD) und USB-C-Interface

Das Flashen und Debuggen der Firmware erfolgt uber ein standardisiertes Serial- ¨ Wire-Debug-Interface (SWD) via Stecker J2 (SWDIO, SWCLK). Erganzend wurde ein ¨ USB-C-Anschluss (J1) als USB-2.0-Full-Speed-Schnittstelle integriert. Um eine korrekte
Erkennung an modernen USB-C-Host-Anschlussen (z. B. PCs) zu gew ¨ | ahrleisten, sind ¨
die Configuration-Channel-Leitungen (CC1, CC2) mit zwei Pull-Down-Widerstanden ¨ gegen Masse gezogen. Ein Pull-Up-Widerstand an der D+-Leitung sorgt fur die korrekte ¨ USB-Enumeration.

### 5.4 Schnittstellen und Bus-Topologie

### 5.4.1 UART-Interface zum Raspberry Pi

Die Kommunikation mit dem Raspberry Pi erfolgt uber eine direkt angebundene ¨ UART-Schnittstelle. Hier werden die berechneten Ziel-Joint-Winkel in Radiant sowie die maximale Beschleunigung vom High-Level-System an den STM32 ubertragen. ¨

### 5.4.2 SPI-Bus und Chip-Select-Logik

Da sich alle sechs TMC5160-Treiber denselben SPI-Bus teilen (MOSI, MISO, SCK),
muss jede Achse uber eine eigene Chip-Select-Leitung ( ¨ | CS) exklusiv angesprochen
werden.

### 5.4.3 STEP/DIR-Leitungen und Signalintegrit¨at

Neben SPI benotigt jeder Treiber eine dedizierte ¨ | STEP- und DIR-Leitung zur Vorgabe
von Geschwindigkeit und Drehrichtung. Da diese Signale im harten Schaltbetrieb
(MHz-Bereich) arbeiten, werden im Layout optionale Vorwiderstande zur D ¨ | ampfung ¨
von Signaluberschwingen eingeplant.[ ¨ | 3]

### 5.5 Spannungsversorgung und Power-Management

Aufgrund der hohen Eingangsspannung von 24 V und den unterschiedlichen Lastanforderungen der Systemkomponenten ist der Einsatz von DC/DC-Abwartswandler (Buck ¨

Converter) erforderlich. Ein linearer Spannungsregler wurde bei dieser Spannungs- ¨
differenz eine unzulassige Verlustleistung ¨ | Ploss = (Vin − Vout) · I in Form von Warme ¨
erzeugen. Das System nutzt eine kaskadierte und parallele Schaltregler-Topologie, um vier getrennte Spannungsebenen bereitzustellen:[5]
- 24 V Hauptversorgung: Direkte Speisung der TMC5160-Leistungsstufen uber ¨ den Terminal-Block J2.
- 12 V Lufter-Versorgung: ¨ | Erzeugt aus den 24 V uber einen synchronen Abw ¨ | artswandler ¨
(U4). Diese Schiene dient exklusiv der Versorgung von aktiven Systemluftern, um ¨
die Abwarme der Motortreiber effektiv abzuf ¨ | uhren. ¨
- 5 V Logik- und Pi-Versorgung: Uber den Schaltregler ( ¨ | U2) realisiert. Diese Schiene

versorgt den Raspberry Pi 4B sowie die Peripheriesensorik. Die Stabilisierung erfolgt uber einen LC-Ausgangsfilter. ¨
- 3,3 V Mikrocontroller-Versorgung: Abgestuft aus der stabilen 5 V-Schiene mittels
eines kompakten Synchron-Abwartswandlers. Dieser versorgt den STM ¨ | 32-Kern
sowie die Digitalstufen der TMC5160-Treiber. Zur Entkopplung hochfrequenter
Storungen der Digitalschaltungen ist die analoge Versorgungsschiene ( ¨ | | VDDA) uber ¨
eine Ferritperle (Ferrite Bead, FB1) und ein zusatzliches Filter-Netzwerk ( ¨ | C6, C7,
C8) realisiert.

[5]

### 5.6 Prototyping und Hardware-Verifikation

Um die theoretische Konzeptionierung sowie die Low-Level-Softwarearchitektur vor dem finalen, integrierten Platinendesign zu validieren, wurde eine modulare Evaluierungsplatine entwickelt. Als Steuerungseinheit dient in dieser Phase ein externes STM32-Nucleo-Entwicklungsboard.

### 5.6.1 Architektur der Testplatine

Die Testplatine wurde als Single-Layer-Board realisiert. Sie dient als Bus- und Verteiler-
platine fur die sechs TMC ¨ | 5160T-Modulsteckplatze ( ¨ | DRV 1 bis DRV 6). Die Signale fur¨
STEP, DIR und CS werden uber Stiftleisten flexibel an das Nucleo-Board ¨ | | ubergeben. Der ¨
SPI-Bus ist als gemeinsame Leiterbahnstruktur uber alle Treiber hinweg geroutet. ¨

5 Elektronikdesign und Hardware-Architektur

### 5.6.2 Maßnahmen zur Signalintegrit¨at und EMV

Da Schrittmotortreiber steile Stromflanken erzeugen, wurden auf dem Testboard gezielte EMV-Schutzmaßnahmen umgesetzt:

- Lokale Dekopplung: Jeder Treiber verfugt ¨ | uber eine direkte Pufferung aus ¨
einem 100 µF Elektrolytkondensator (transiente Spitzenstrome) und einem ¨ | 100 nF
Keramikkondensator (hochfrequente Storungen) unmittelbar am Pin ¨ | VM.
- Uberspannungsschutz: ¨ | Am 24 V-Eingang (J2) ist eine Suppressordiode (TVS-

Diode, D1) platziert, welche die Gegen-EMK der Motoren beim abrupten Bremsen absorbiert.
- Massive Stromschienen: Die Versorgungsleitung fur die Motorspannung wurde ¨
auf der Oberseite als großflachige, niederohmige Kupferschiene ausgef ¨ | uhrt, um ¨
Spannungsabfalle zu minimieren. ¨

### 5.7 Schaltplan und PCB-Layout (Integriertes Design)

### 5.7.1 Leiterbahndimensionierung und Stromtragf¨ahigkeit

Fur das finale Platinendesign (gefertigt ¨ | uber JLCPCB) m ¨ | ussen die Leiterbahnbreiten ¨
der Hauptstromversorgung mathematisch begrundet werden, um ¨ | Uberhitzungen zu ¨

vermeiden. Die Berechnung der minimalen Leiterbahnbreite erfolgt nach der gangigen ¨
Industrienorm IPC-2221. [6] Die grundlegende Formel fur den maximal zul ¨ | assigen ¨
Strom I in Abhangigkeit von der Querschnittsfl ¨ | ache ¨ | A und der zulassigen Temperatur- ¨
erhohung ¨ | ∆T lautet:
I = k · ∆T

b
- A

c
(5.1)
Fur Außenlagen (Top-/Bottom-Layer) gelten nach IPC- ¨ | 2221 die Konstanten k = 0,048,
b = 0,44 und c = 0,725. Umgestellt nach der benotigten Querschnittsfl ¨ | ache ¨ | A (in mils²
)
ergibt sich:

A =

I
k · ∆Tb

1
c
(5.2)

Da die Hauptversorgungsbahn im Layout als durchgehendes Polygon mit einer Breite
von ca. 10 mm ausgefuhrt wurde, liegt das Design deutlich im sicheren Bereich.[ ¨ | 6]

### 5.7.2 Thermisches Management

Um einen sicheren Betrieb trotz der hohen thermischen Beanspruchung der Treiber
zu gewahrleisten, werden L ¨ | ufter ¨ | uber die Onboard- ¨ | 12V-Versorgung betrieben und im
Gehause integriert. Zudem kommen Heatsinks und Thermal Vias zum Einsatz. ¨

# Abbildungsverzeichnis

2.1 | Diagramm der SPI-Modi | | 6
2.2 | Diagramm der Finite State Machine | | 8
5.1 | Blockschaltbild der Elektronik-Architektur | 18

# Quellenverzeichnis

[1] STM32F446RE Datasheet, 2021. Adresse: https://www.st.com/resource/en/

datasheet/stm32f446mc.pdf (https://www.st.com/resource/en/datasheet/stm32f446mc.pdf)

[2] Serial Peripheral Interface – Mikrocontroller.net, Mikrocontroller.net, 2025. Adresse:

https://www.mikrocontroller.net/articles/Serial_Peripheral_Interface

[3] POWER DRIVER FOR STEPPER MOTORS INTEGRATED CIRCUITS TMC5160 / TMC5160A DATASHEET FEATURES AND BENEFITS 2-phase stepper motors from 1 to several 10A coil current Motion Controller with SixPoint™ ramp. Adresse:

https://www.analog.com/media/en/technical-documentation/data-sheets/

TMC5160A_datasheet_rev1.17.pdf (https://www.analog.com/media/en/technical-documentation/data-sheets/TMC5160A_datasheet_rev1.17.pdf)

[4] Statemachine – Mikrocontroller.net, Mikrocontroller.net, 2026. besucht am 27. Mai

2026. Adresse: https://www.mikrocontroller.net/articles/Statemachine

[5] K. Kirasich, New WEBENCH® Power Designer Is Now Even Easier to Use. besucht am
18. Juni 2026. Adresse: https://www.ti.com/lit/ta/sszt719/sszt719.pdf?ts=

1781768693543&ref_url=https%253A%252F%252Fwww.ti.com%252Fsitesearch%

252Fen - us % 252Fdocs % 252Funiversalsearch . tsp % 253FlangPref % 253Den - US %

2526nr%253D20942%2526searchTerm%253Dwebench+power+designer (https://www.ti.com/lit/ta/sszt719/sszt719.pdf?ts=1781768693543)

[6] IPC-2221 Generic Standard on Printed Board Design The Institute for Interconnecting and Packaging Electronic Circuits, 1998. Adresse: https://www.tortai-tech.com/wp-

content/uploads/2023/09/IPC-2221-Generic-Standard-on-Printed-Board-

Design.pdf (https://www.tortai-tech.com/wp-content/uploads/2023/09/IPC-2221-Generic-Standard-on-Printed-Board-Design.pdf)
