EmanuelKaefer/Open-robot-arm/doc/template/template_mama/.template_mama/EigesErklärung.pdf

# Eidesstattliche Erkl¨arung

Wir erklaren an Eides statt, dass wir die vorliegende Arbeit selbstst ¨ | andig verfasst, ¨
andere als die angegebenen Quellen/Hilfsmittel nicht benutzt, und die den benutzten Quellen wortlich und inhaltlich entnommenen Stellen als solche kenntlich gemacht ¨ haben.
Datum | Iason Vasiliadis

Fabian Gassler

ii
