EmanuelKaefer/Open-robot-arm/doc/template/template_mama/.template_mama/main.tex

%%%% Time-stamp: <2018-03-24 14:05:09 vk>
%% ========================================================================
%%%% Disclaimer
%% ========================================================================
%%
%% created by
%%
%%      Karl Voit
%%
%% DOCUMENT created by
%%
%%		Emanuel Käfer, Matteo Gassler, Alexander Dick
%%

%% ========================================================================
%%%% Basic settings
%% ========================================================================
%% (idea of using newcommands for basic documentclass settings from: Thomas Schlager)

\newcommand{\mypapersize}{A4}
%% e.g., "A4", "letter", "legal", "executive", ...
%% The size of the paper of the resulting PDF file.

\newcommand{\mylaterality}{oneside}
%% "oneside" or "twoside"
%% Either you are creating a document which is printed on both, left pages
%% and right pages (twoside) or you create a document which is printed
%% on right pages only (oneside).
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
\input{template/mycommands}

%% ========================================================================
%%%% Typographic settings
%% ========================================================================
\input{template/typographic_settings}

%% ========================================================================
%%%% MISC usepackages
%% ========================================================================

%% ... it's OK to put here your own usepackage commands ...

\usepackage{float}
\usepackage{booktabs} %for tabels

\usepackage{listings} %for code
\usepackage{xcolor} % Für die Farben im Code

% Definition des Designs für den Code
\lstset{
	backgroundcolor=\color{gray!5},   % Leichter grauer Hintergrund
	basicstyle=\ttfamily\footnotesize, % Feste Schriftart (Monospace) und passende Größe
	breaklines=true,                   % Automatische Zeilenumbrüche bei zu langen Zeilen
	captionpos=b,                      % Code-Beschriftung UNTEN (Standard bei Code)
	commentstyle=\color{green!60!black}, % Farbe für Kommentare
	keywordstyle=\color{blue},         % Farbe für Befehle (if, while, etc.)
	numbers=left,                      % Zeilennummern links
	numberstyle=\tiny\color{gray},     % Stil der Zeilenummern
	stringstyle=\color{purple},        % Farbe für Texte in Anführungszeichen
	showstringspaces=false,            % Keine hässlichen Unterstriche bei Leerzeichen
	frame=single,                      % Rahmen um den Code
}
%% ========================================================================
%%%% MISC self-defined commands and settings
%% ========================================================================

%% ... it's OK to put here your own newcommand/newenvironment-definitions ...

\newboolean{noformal}
\setboolean{noformal}{false} %% do not compile stuff that's just formality

\hyphenation{ex-am-ple hy-phen-ate}  %% in order to use German umlauts
%% here (Ver-\"of-fent-li-chung), you have to check for
%% activated \usepackage[T1]{fontenc} in the preamble

%% override default language of babel: (be sure to know, what you're
%% doing here)
%\selectlanguage{american}
%\selectlanguage{ngerman}

%% ========================================================================
%%%% Templates
%% ========================================================================

%% template for inserting figures:
% \myfig{}%% filename
%       {}%% width/height
%       {}%% caption
%       {}%% optional (short) caption for list of figures
%       {fig:}%% label

%% acronyms in small caps: \myacro{UNESCO}

\input{template/pdf_settings}  %% should be *last* definitions in preamble!

\definecolor{background}{rgb}{0.97,0.97,0.97}
\definecolor{turquoise}{HTML}{000000}

% C++ Style definieren
\lstdefinestyle{cppstyle}{
	language=C++,
	basicstyle=\ttfamily\footnotesize,
	keywordstyle=\color{blue},
	commentstyle=\color{green},
	stringstyle=\color{red},
	identifierstyle=\color{turquoise},
	morekeywords={String},
	backgroundcolor=\color{background},
	frame=single,
	rulecolor=\color{gray},
	captionpos=b,
	numbers=left,
	numberstyle=\color{gray},
	showstringspaces=false,
	breaklines=true,
	tabsize=1,         % Minimale Tab-Breite
	keepspaces=true
}

% Stil global setzen
\lstset{style=cppstyle}

\setlength{\parindent}{0pt}
\usepackage{tcolorbox}

\newif\ifisfinalversion
\isfinalversiontrue

\newcommand{\ki}[1]{
	\ifisfinalversion
	#1
	\else
	\begin{tcolorbox}[colback=white, colframe=blue, title=KI-Generiert]
		#1
	\end{tcolorbox}
	\fi
}

\newcommand{\kii}[2]{ 
	\ifisfinalversion
	#1
	\else
	\begin{tcolorbox}[colback=white, colframe=green, title=KI-Inspiriert]
		#1
	\end{tcolorbox}
	\fi
}
\usepackage[table]{xcolor}
\usepackage{array}
\usepackage{graphicx}
\usepackage{colortbl}
\usepackage{pdfpages}
\definecolor{lightgray}{gray}{0.9}
%% ========================================================================
%%%% begin{document}
%% ========================================================================

\setcounter{tocdepth}{1}
\begin{document}

\frontmatter                    %% KOMA: roman page numbers and such; only available in scrbook

\ifthenelse{\boolean{noformal}}{}{
%% Choose your desired title page:
\input{\mytitlepage}            %% include title page

%%\includepdf[pages={1}]{aaa.pdf}  %% Statutory Declaration
}
\input{formal/diplomarbeit-doku}

\input{content/vorwort}
\input{content/Aufgabenstellung}
\input{content/abstract}
\input{content/abtract_englisch}
\input{content/danksagung}

\tableofcontents

\ifthenelse{\boolean{myaddlistoftodos}}{
  \newpage\listoftodos          %% handy if you are using todonotes with \todo{}
}{}                             %% with todonotes-package option "disable" you can get rid of any todo in the output

\mainmatter
\let\cleardoublepage\clearpage
%\input{content/einleitung}

%% include all content chapters

\input{content/chapters}   %% remove this line to get rid of the style chapter
\input{content/Fazit-und-Ausblick}

\ifoot{}
\ofoot{ }
%\addpart*{Anhang}
\backmatter
\newgeometry{a4paper,left=25mm,top=20mm,right=25mm,bottom=30mm}
\listoffigures

\printbibliography[heading=bibintoc,title=Quellenverzeichnis]

\input{formal/Begleiterprotokoll}
%\input{formal/Besprechungsprotokoll}

\setlength{\parskip}{1em}

%%%% end{document}
\end{document}
%% vim:foldmethod=expr
%% vim:fde=getline(v\:lnum)=~'^%%%%\ .\\+'?'>1'\:'='
%%% Local Variables:
%%% mode: latex
%%% mode: auto-fill
%%% mode: flyspell
%%% eval: (ispell-change-dictionary "en_US")
%%% TeX-master: "main"
%%% End:
