EmanuelKaefer/Open-robot-arm/doc/template/template_mama/.template_mama/content/Fazit-und-Ausblick.tex

%% !TeX spellcheck = de_DE
%\chapter{Fazit und Ausblick} {
%Fazit einfügen
%
%\section{Probleme und Lösungen}
%Probleme und Lösungen einfügen
%\par
%-""-
%
%\par
%\section{Ausblick}
%Ausblick einfügen
%}
