EmanuelKaefer/Open-robot-arm/doc/template/template_mama/.template_mama/formal/Besprechungsprotokoll.tex

% !TeX spellcheck = de_DE
\chapter{Besprechungsprotokoll}
{
	%%\begin{tabular}[c]{@{}l@{}}1 \\ 2 \end{tabular}
	\vspace{1cm}
	\textbf{Name:} Iason Vasiliadis, Fabian Gassler\\
	\textbf{Diplomarbeitstitel:} PuckVision - Entwicklung eines Eishockeytrainingssystems\\
	\vspace{-0.8cm}
	\begin{table}[!htb]
		\begin{tabular}{|c|c|c|l|l|}
			\hline
			\textbf{Datum} & \textbf{Dauer} & \textbf{Personen} & \textbf{Thema} & \textbf{Anmerkungen} \\ \hline
			xx.xx.xx & 1h & alle & \begin{tabular}[c]{@{}l@{}}Allgemeines, \\ Organisatorisches \end{tabular} & \\ \hline
            
			xx.xx.xx & 1,5h & alle & \begin{tabular}[c]{@{}l@{}}Sub-Themenfindung, \\ Antrag \end{tabular} & \\ \hline
            
			xx.xx.xx & 1,5h & alle & \begin{tabular}[c]{@{}l@{}}Projektplanung/ \\ Spezifikationen \end{tabular}  & \\ \hline
            
			xx.xx.xx & ?h & alle & \begin{tabular}[c]{@{}l@{}}tbd \\ tbd \\ tbd \end{tabular} & 
			\begin{tabular}[c]{@{}l@{}}tbd  \end{tabular} \\ \hline
            
			xx.xx.xx & 2h & alle & 1. Review & \begin{tabular}[c]{@{}l@{}}tbd \end{tabular} \\ \hline
            
			xx.xx.xx & 1h & alle & \begin{tabular}[c]{@{}l@{}}tbd \\ tbd  \end{tabular} & \begin{tabular}[c]{@{}l@{}}tbd  \end{tabular} \\ \hline
            
			xx.xx.xx & 1h & alle & 2. Review & \begin{tabular}[c]{@{}l@{}}tbd \end{tabular} \\ \hline
            
			xx.xx.xx & 3h & alle & tbd & \begin{tabular}[c]{@{}l@{}}tbd \end{tabular} \\ \hline
            
			xx.xx.xx & 2h & alle & Vorbereitung: DA-Abgabe & \begin{tabular}[c]{@{}l@{}}Gestaltung der DA \\ Erster Vorentwurf der DA \end{tabular} \\ \hline
            
			xx.xx.xx & 1h & alle & Abgabe, Projektabschluss & \begin{tabular}[c]{@{}l@{}}Projektendstand \\ * Erreichte Ziele \\ * Offene Punkte \\ * Ausblick \\ Projektabschluss \end{tabular} \\ \hline
			06.04.21 & 1h & & DA-Abgabe & \\ \hline
			
		\end{tabular}
	\end{table}
	\newpage
}
