EmanuelKaefer/Open-robot-arm/doc/template/template_mama/.template_mama/main-DESKTOP-Q4UTU8T.pdf

# Entwicklung eines 6dof Roboterarms

### ASIT-Projekt verfasst von

## Matteo Gassler Emanuel Kafer ¨ Alexander Dick

### Betreuer: Prof. Dr. Gerhard Gaube

### HTBLA Saalfelden

### Abteilung fur Elektrotechnik ¨

### Abgabevermerk:


Saalfelden, 2 April 2026 | ubernommen von: ¨

# Vorwort

Vorwort Einfugen ¨

Ort Datum Einfugen ¨
Matteo Gassler & Emanuel Kafer & Alexander Dick ¨

ii

# Inhaltsverzeichnis

Vorwort | ii
1 Einleitung | 1
2 Software | 2
3 Hardware | 3
4 Elektrisches | 4

iii

# 1 Einleitung

# 2 Software

# 3 Hardware

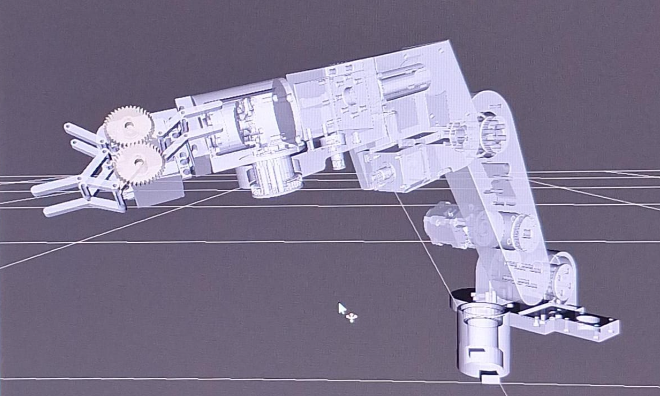
[picture p48: figure]

Abbildung 3.1: Blockdiagramm des 6-DOF-Roboterarms

# 4 Elektrisches

Die Entwicklung moderner Roboterarme basiert stark auf den Prinzipien der kollaborativen Robotik,[ws2812b] bei denen Sicherheit und Flexibilitat im Vordergrund stehen ¨

[ws2812].

# Abbildungsverzeichnis

3.1 | Blockdiagramm des 6-DOF-Roboterarms | | 3
