EmanuelKaefer/Open-robot-arm/doc/Software/pics/stall_stall1.png

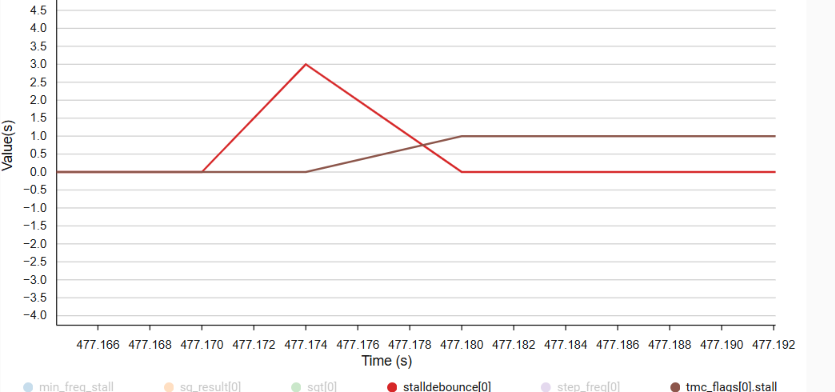
doc/Software/pics/stall_stall1.png
