EmanuelKaefer/Open-robot-arm/doc/Software/pics/stall_stall.png

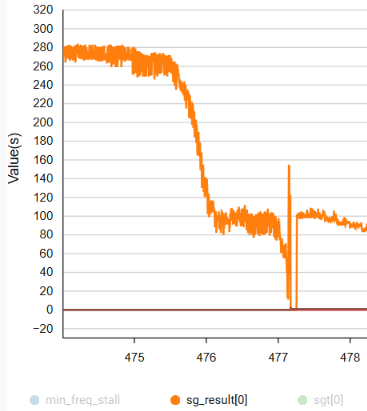
doc/Software/pics/stall_stall.png
