EmanuelKaefer/Open-robot-arm/doc/Software/pics/stall_start.png

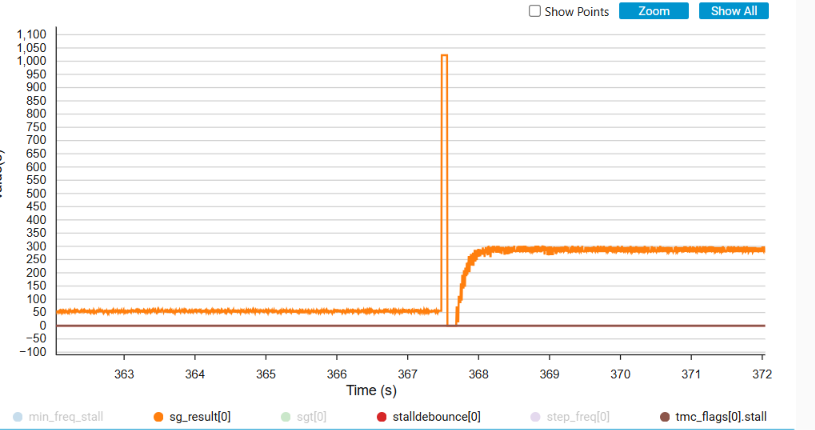
doc/Software/pics/stall_start.png
