EmanuelKaefer/Open-robot-arm/doc/template/template_mama/.template_mama/figures/allgemein/roboterarm_flowchart.png

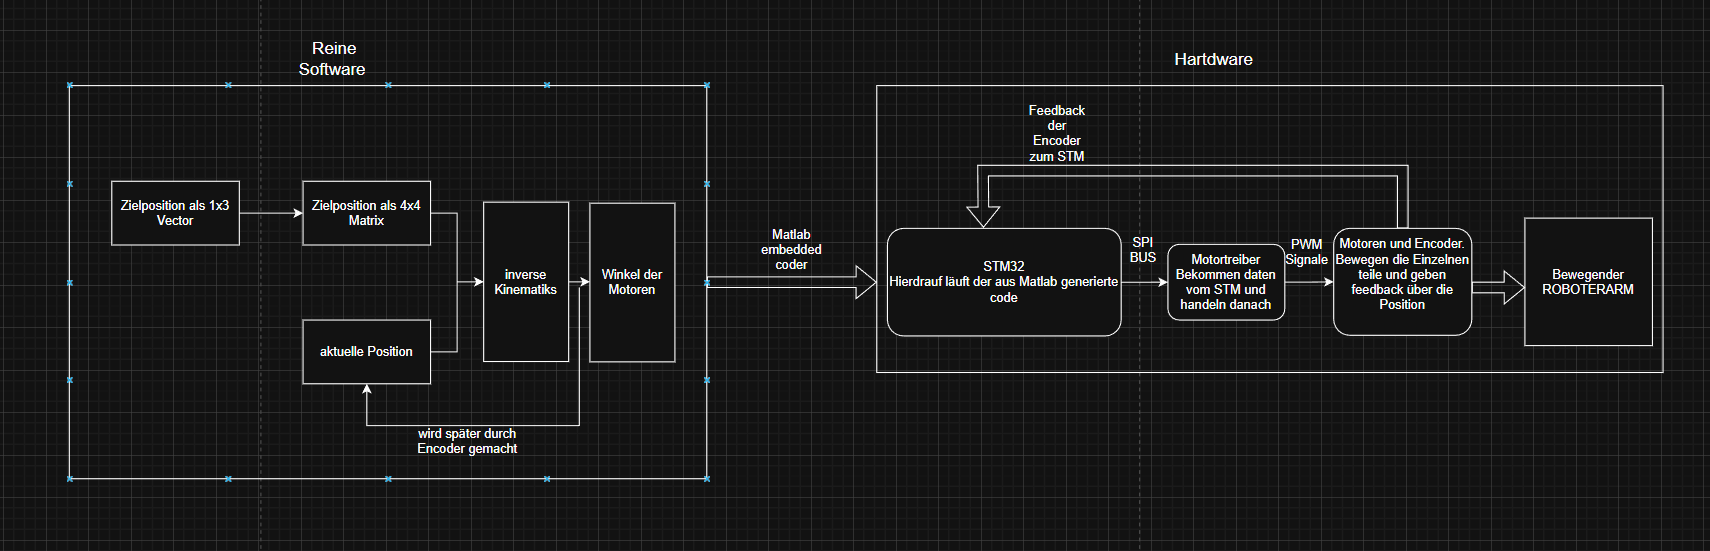
doc/template/template_mama/.template_mama/figures/allgemein/roboterarm_flowchart.png
