EmanuelKaefer/Open-robot-arm/Mechanical/V6/Prints/upperarm/upperarm_main.SLDPRT

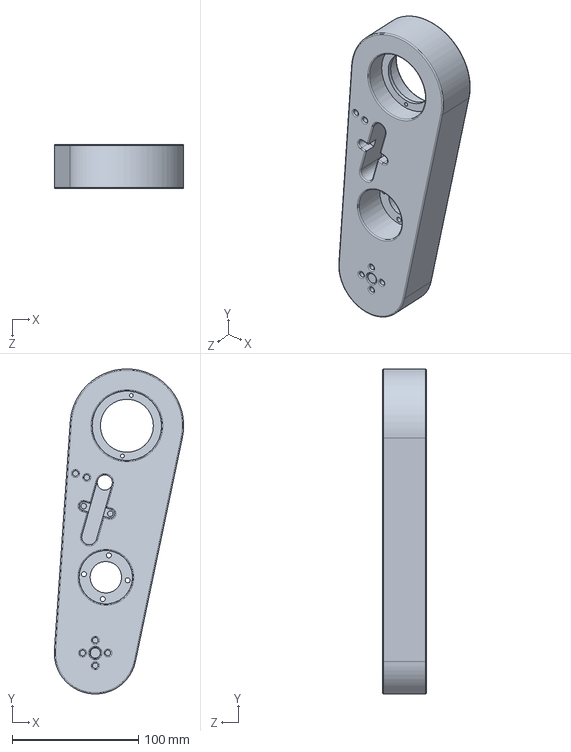
[picture p53: CAD file, 2026-05-28]
Mechanical/V6/Prints/upperarm/upperarm_main.SLDPRT
102.4 x 257.4 x 35.0 mm
