EmanuelKaefer/Open-robot-arm/Mechanical/V6_rework/O-R-A_V6_rework.SLDASM

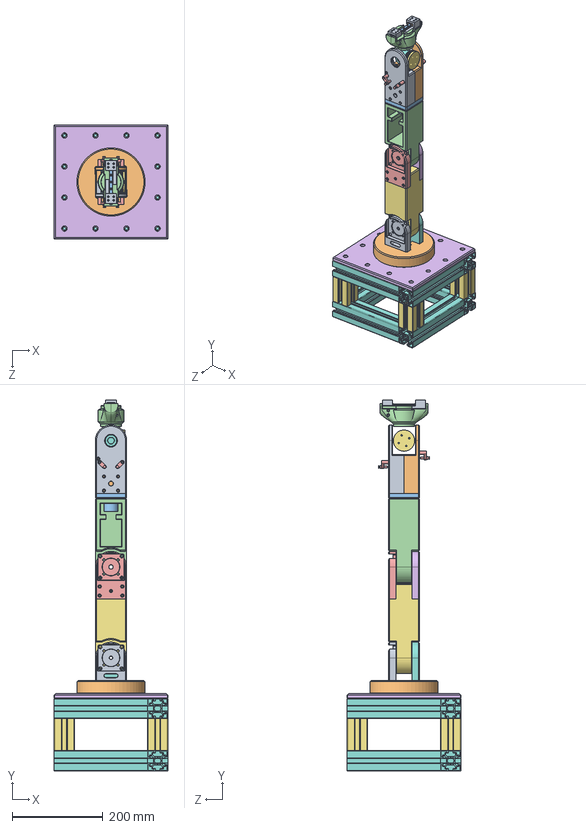
[picture p54: CAD file, 2026-10-24]
Mechanical/V6_rework/O-R-A_V6_rework.SLDASM
250.0 x 816.4 x 250.0 mm
bosch_profil_45x45x205mm x 8
bosch_profil_45x45x70mm x 4
Baseplate_V6_rework
Upper_bearing_retainer_V6_rework
Lower_bearing_retainer_V6_rework
Axis1_Axle_V6_rework
Rotating_plate_V6_rework
Shoulder_L_V6_rework
Shoulder_R_V6_rework
Upperarm_V6_rework
Upperarm_R_holder_V6_rework
Upperarm_L_holder_V6_rework
Forearm_V6_rework
Lower_Wrist_V6_rework
Upper_Wrist_L_V6_rework
Upper_Wrist_R_V6_rework
Wrist_tilt_V6_rework
Wrist_axle_pinion_V6_rework
Wrist_axial_bearing_dummy
Wrist_belt_tensioner_V6_rework x 4
Gripper_base_V6_rework x 2
MGN7 rail
MGN7C x 2
Gripper_finger_V6_rework x 2
