EmanuelKaefer/Open-robot-arm/Mechanical/V6_rework/Parts_V6_rework/Base_V6_rework/Base_V6_rework-DESKTOP-4B5VSPA.SLDASM

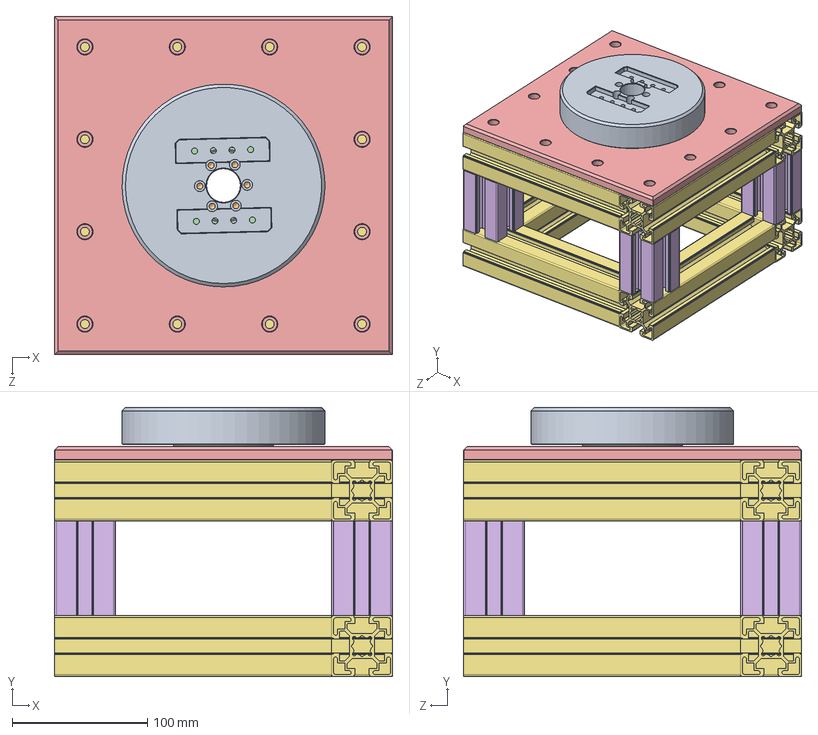
[picture p55: CAD file, 2026-10-24]
Mechanical/V6_rework/Parts_V6_rework/Base_V6_rework/Base_V6_rework-DESKTOP-4B5VSPA.SLDASM
250.0 x 199.0 x 250.0 mm
bosch_profil_45x45x205mm x 8
bosch_profil_45x45x70mm x 4
Baseplate_V6_rework
Upper_bearing_retainer_V6_rework
Lower_bearing_retainer_V6_rework
Axis1_Axle_V6_rework
Rotating_plate_V6_rework
