EmanuelKaefer/Open-robot-arm/Mechanical/V6_rework/Parts_V6_rework/Forearm_V6_rework/Forearm_V6_rework.SLDASM

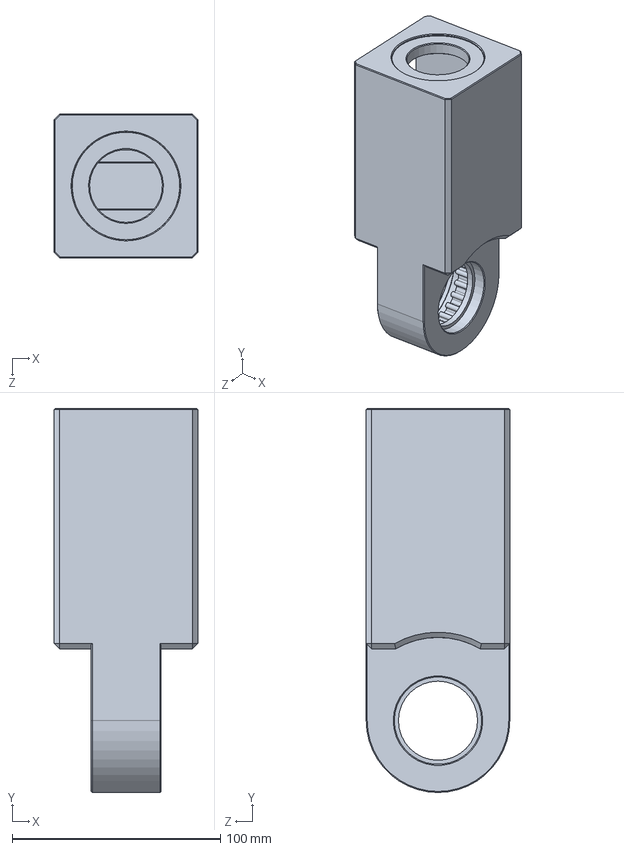
[picture p56: CAD file, 2026-10-24]
Mechanical/V6_rework/Parts_V6_rework/Forearm_V6_rework/Forearm_V6_rework.SLDASM
69.0 x 184.5 x 69.0 mm
