EmanuelKaefer/Open-robot-arm/Mechanical/V6_rework/Parts_V6_rework/Gripper_V6_rework/Gripper_V6_rework.SLDASM

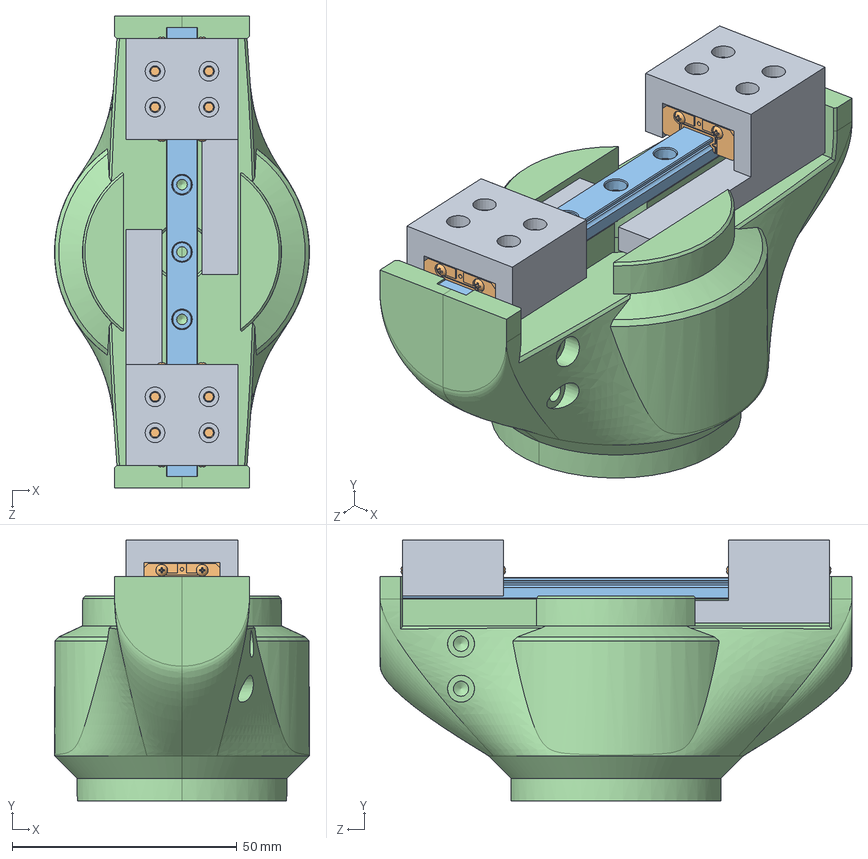
[picture p57: CAD file, 2026-10-24]
Mechanical/V6_rework/Parts_V6_rework/Gripper_V6_rework/Gripper_V6_rework.SLDASM
56.8 x 58.1 x 105.0 mm
Gripper_base_V6_rework x 2
MGN7 rail
MGN7C x 2
Gripper_finger_V6_rework x 2
