EmanuelKaefer/Open-robot-arm/Mechanical/V6_rework/Parts_V6_rework/Upperarm_V6_rework/Upperarm_V6_rework.SLDASM

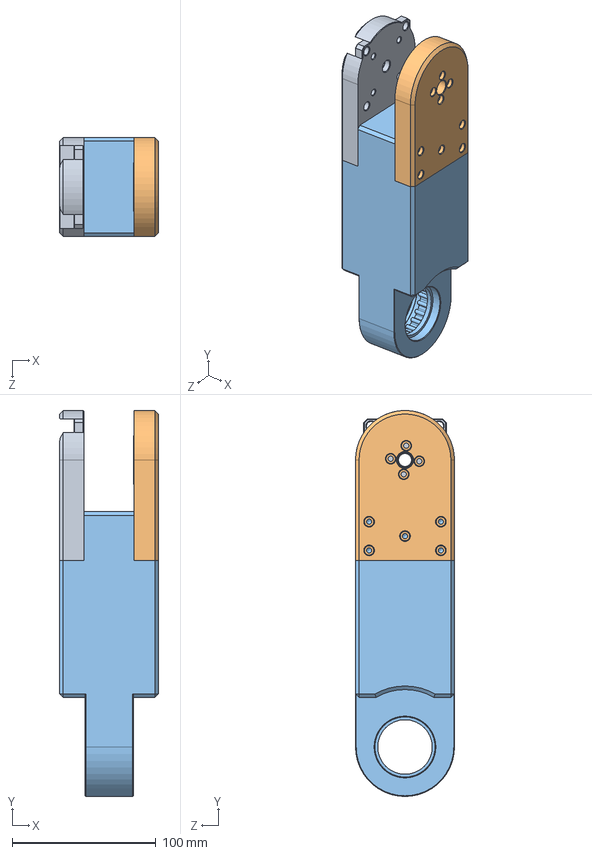
[picture p58: CAD file, 2026-10-24]
Mechanical/V6_rework/Parts_V6_rework/Upperarm_V6_rework/Upperarm_V6_rework.SLDASM
69.0 x 269.0 x 69.0 mm
Upperarm_V6_rework
Upperarm_R_holder_V6_rework
Upperarm_L_holder_V6_rework
