EmanuelKaefer/Open-robot-arm/Mechanical/V6/Prints/base/base_mainSLDPRT.SLDPRT

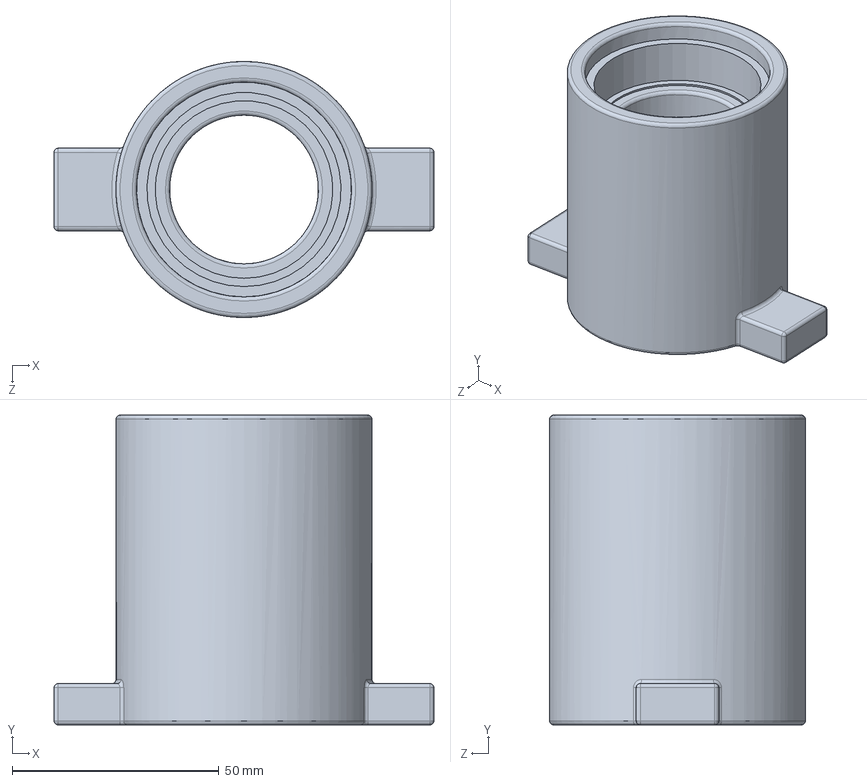
[picture p59: CAD file, 2025-12-02]
Mechanical/V6/Prints/base/base_mainSLDPRT.SLDPRT
92.0 x 75.0 x 62.0 mm
