EmanuelKaefer/Open-robot-arm/Mechanical/V6/Prints/gripper/gripperV2/gripper_main.SLDPRT

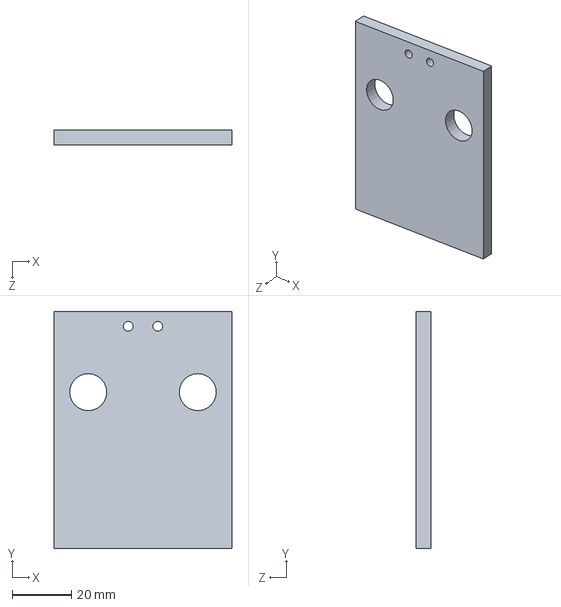
[picture p60: CAD file, 2025-12-04]
Mechanical/V6/Prints/gripper/gripperV2/gripper_main.SLDPRT
60.0 x 80.0 x 5.00 mm
