EmanuelKaefer/Open-robot-arm/Mechanical/V6/Prints/wrist/collision_wrist_main.STL

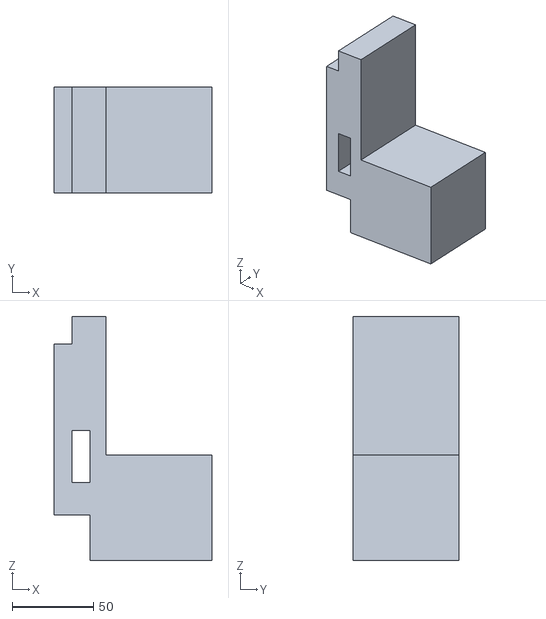
[picture p61: CAD file, 2025-12-04]
Mechanical/V6/Prints/wrist/collision_wrist_main.STL
97.0 x 65.0 x 150.0
