EmanuelKaefer/Open-robot-arm/Mechanical/V6/Prints/base/base_axle.SLDPRT

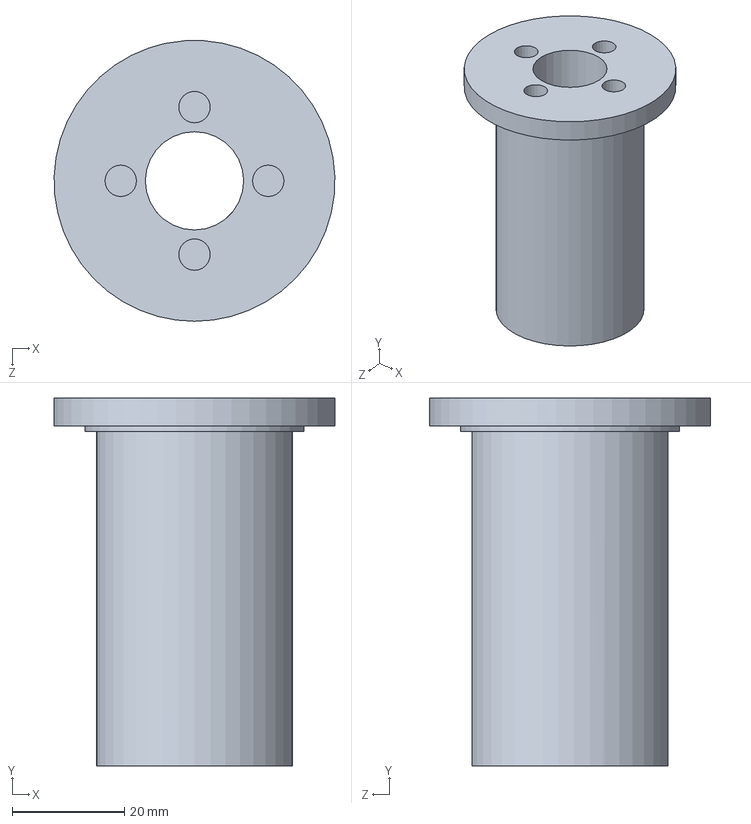
[picture p62: CAD file, 2025-12-02]
Mechanical/V6/Prints/base/base_axle.SLDPRT
50.0 x 65.5 x 49.9 mm
