EmanuelKaefer/Open-robot-arm/Mechanical/V6/Prints/electrical/gx-f8a.SLDPRT

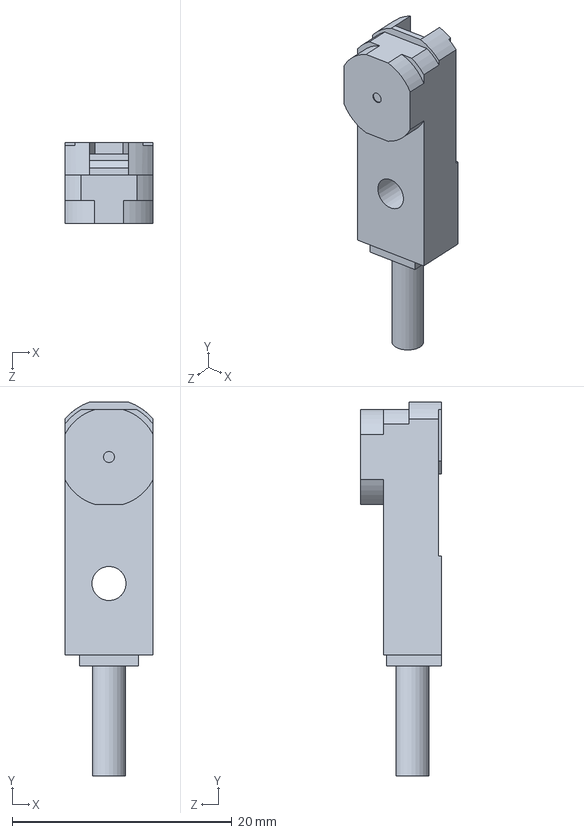
[picture p63: CAD file, 2025-11-23]
Mechanical/V6/Prints/electrical/gx-f8a.SLDPRT
8.00 x 34.0 x 7.40 mm
