EmanuelKaefer/Open-robot-arm/Mechanical/V6/Prints/forearm/Forearm2.SLDPRT

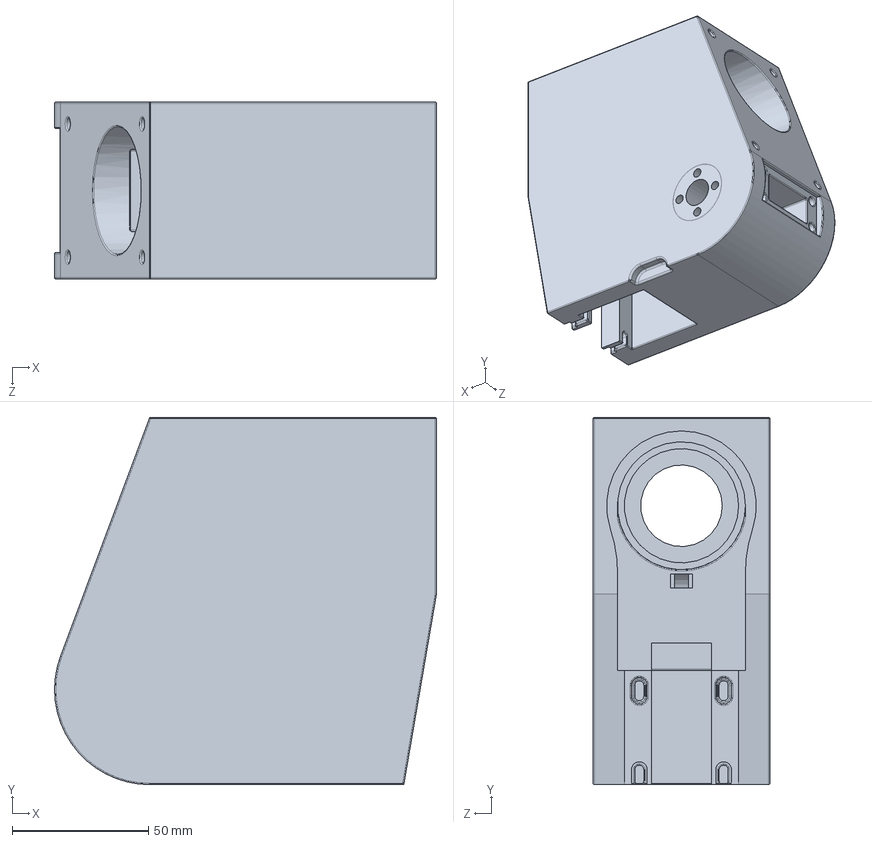
[picture p64: CAD file, 2026-05-28]
Mechanical/V6/Prints/forearm/Forearm2.SLDPRT
140.4 x 135.0 x 65.0 mm
