EmanuelKaefer/Open-robot-arm/Mechanical/V6/Prints/gripper/gripperV2/gripper_collision.SLDPRT

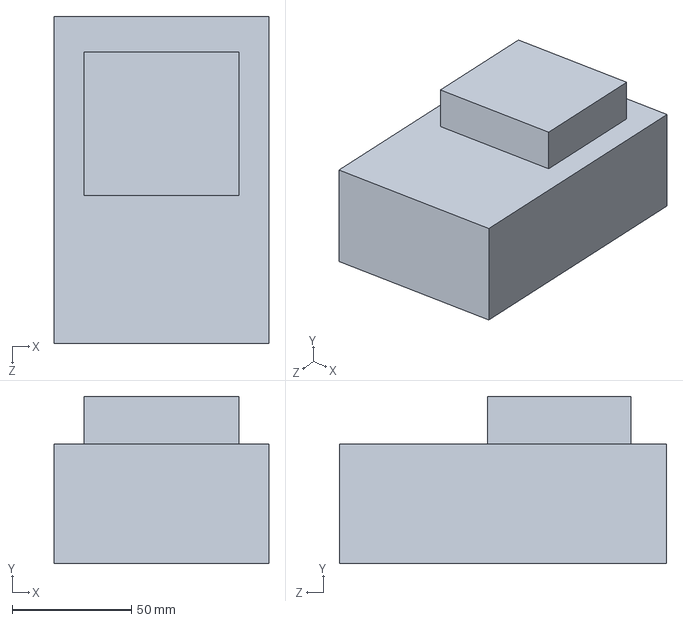
[picture p65: CAD file, 2025-12-04]
Mechanical/V6/Prints/gripper/gripperV2/gripper_collision.SLDPRT
90.0 x 70.0 x 137.0 mm
