EmanuelKaefer/Open-robot-arm/Mechanical/V6/Prints/upperarm/gear/upperarm_upper_gear1.SLDPRT

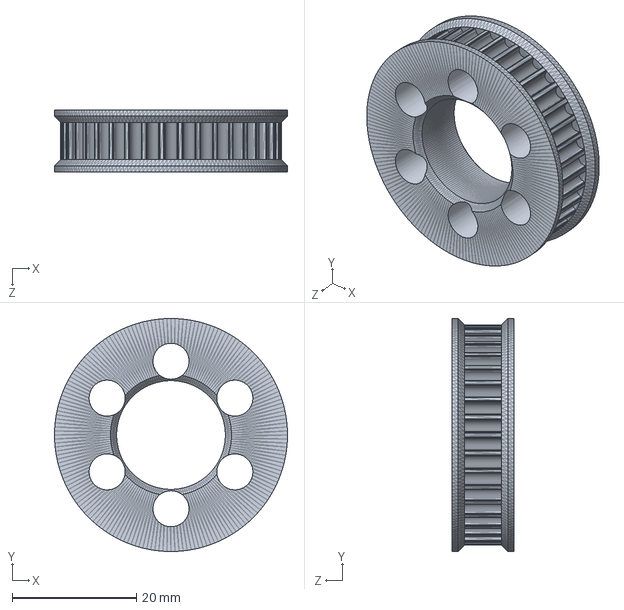
[picture p66: CAD file, 2026-05-28]
Mechanical/V6/Prints/upperarm/gear/upperarm_upper_gear1.SLDPRT
37.5 x 37.5 x 10.0 mm
