EmanuelKaefer/Open-robot-arm/Mechanical/V6/Prints/wrist/gear/wirst_secondary_HTD3M48T.stl

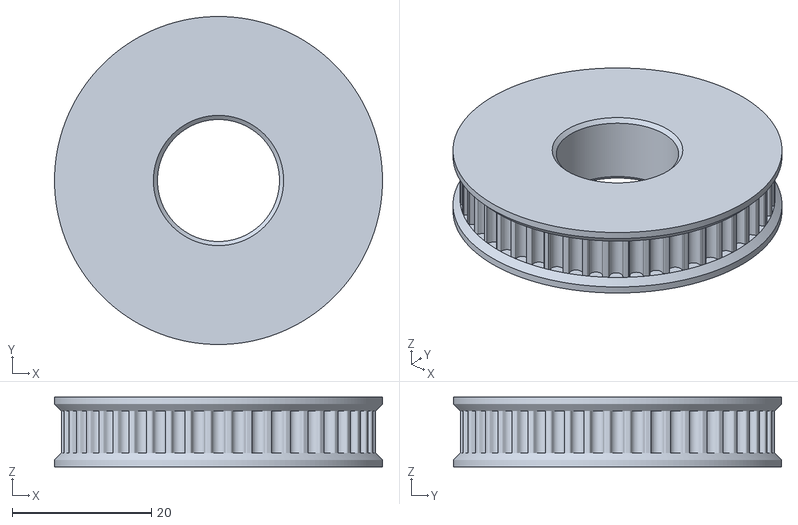
[picture p67: CAD file, 2025-12-02]
Mechanical/V6/Prints/wrist/gear/wirst_secondary_HTD3M48T.stl
47.1 x 47.1 x 10.0
