EmanuelKaefer/Open-robot-arm/Mechanical/V6/Prints/wrist/wrist_secondary_axle.SLDPRT

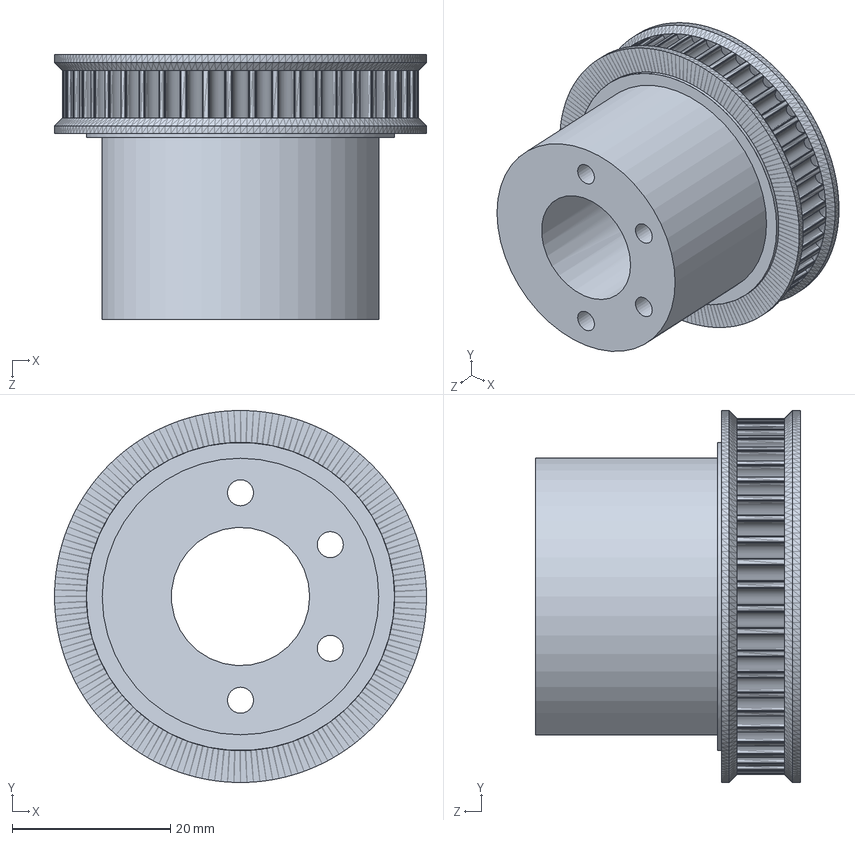
[picture p68: CAD file, 2026-05-28]
Mechanical/V6/Prints/wrist/wrist_secondary_axle.SLDPRT
47.1 x 47.1 x 33.5 mm
