EmanuelKaefer/Open-robot-arm/Mechanical/V6_rework/Parts_V6_rework/Base_V6_rework/Base_construction/Upper_bearing_retainer_V6_rework.SLDPRT

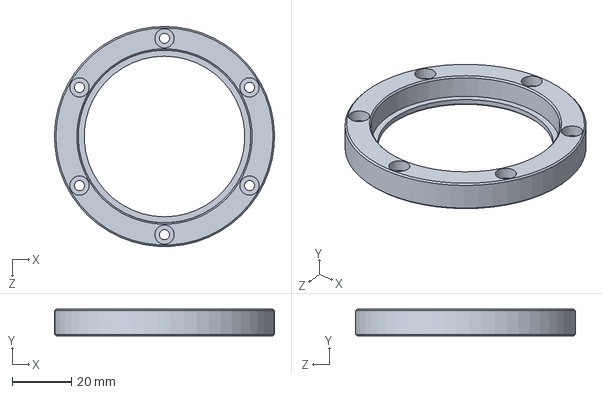
[picture p69: CAD file, 2026-10-23]
Mechanical/V6_rework/Parts_V6_rework/Base_V6_rework/Base_construction/Upper_bearing_retainer_V6_rework.SLDPRT
74.0 x 9.00 x 74.0 mm
