EmanuelKaefer/Open-robot-arm/Mechanical/V6_rework/Parts_V6_rework/Cycloidal_drive_V6_rework/Cycloidal_drive_construction/Cyloidaldrive_housing.SLDPRT

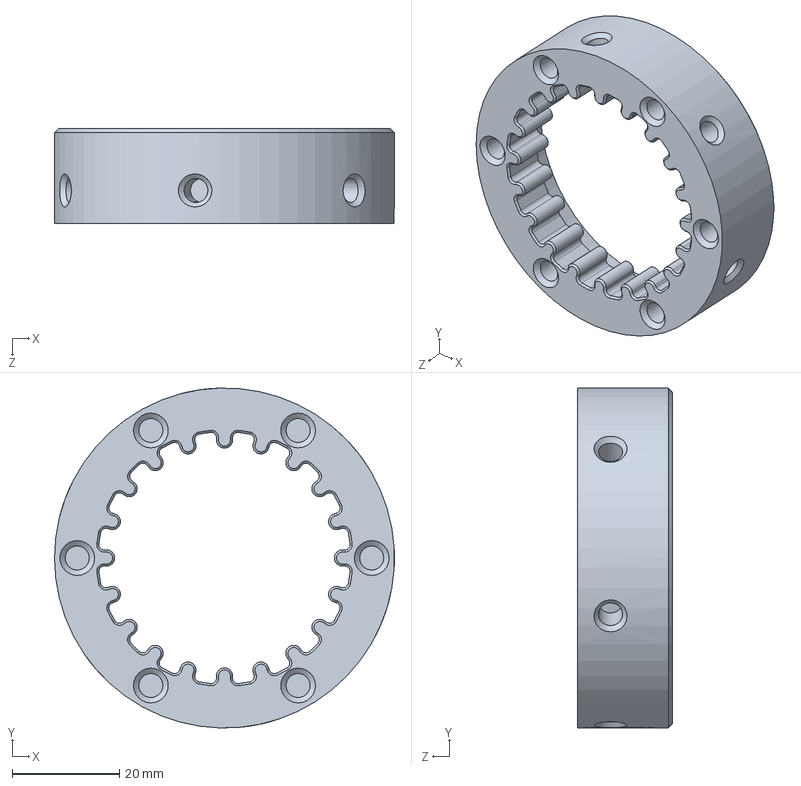
[picture p70: CAD file, 2026-10-20]
Mechanical/V6_rework/Parts_V6_rework/Cycloidal_drive_V6_rework/Cycloidal_drive_construction/Cyloidaldrive_housing.SLDPRT
63.5 x 63.5 x 17.8 mm
