EmanuelKaefer/Open-robot-arm/Mechanical/V6_rework/Parts_V6_rework/Gripper_V6_rework/Gripper_construction/Gripper_base_V6_rework.SLDPRT

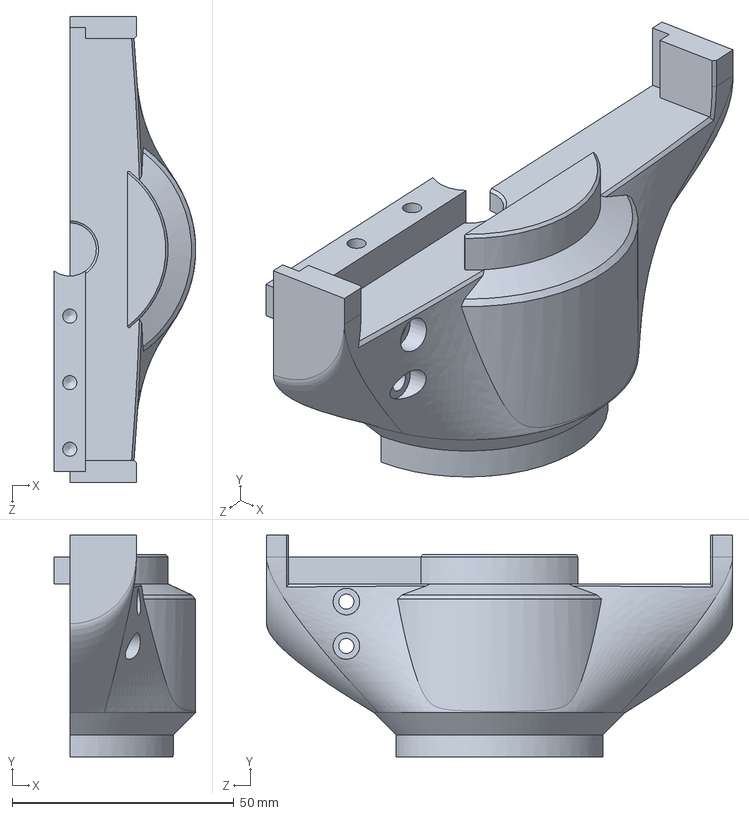
[picture p71: CAD file, 2026-10-24]
Mechanical/V6_rework/Parts_V6_rework/Gripper_V6_rework/Gripper_construction/Gripper_base_V6_rework.SLDPRT
31.9 x 50.0 x 105.0 mm
