EmanuelKaefer/Open-robot-arm/Mechanical/V6_rework/Parts_V6_rework/Shoulder_V6_rework/Shoulder_R_V6_rework.SLDPRT

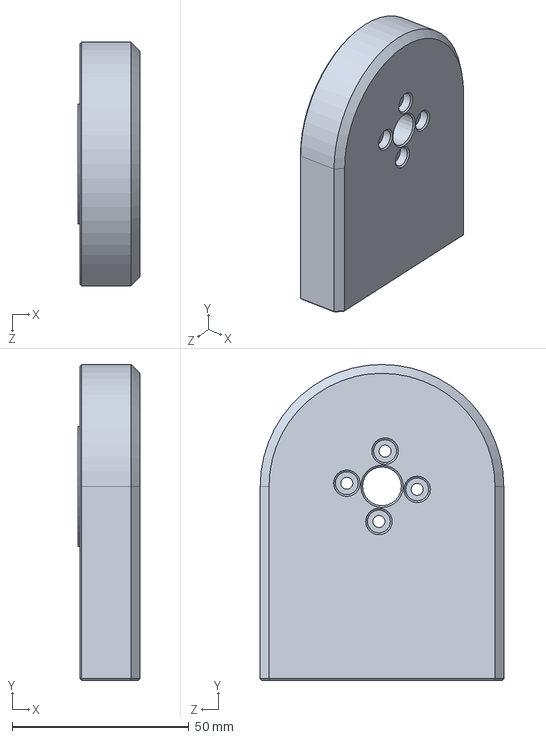
[picture p72: CAD file, 2026-10-23]
Mechanical/V6_rework/Parts_V6_rework/Shoulder_V6_rework/Shoulder_R_V6_rework.SLDPRT
17.5 x 89.5 x 69.0 mm
