EmanuelKaefer/Open-robot-arm/Mechanical/V6_rework/Parts_V6_rework/Upperarm_V6_rework/Upperame_construction/Upperarm_V6_rework.SLDPRT

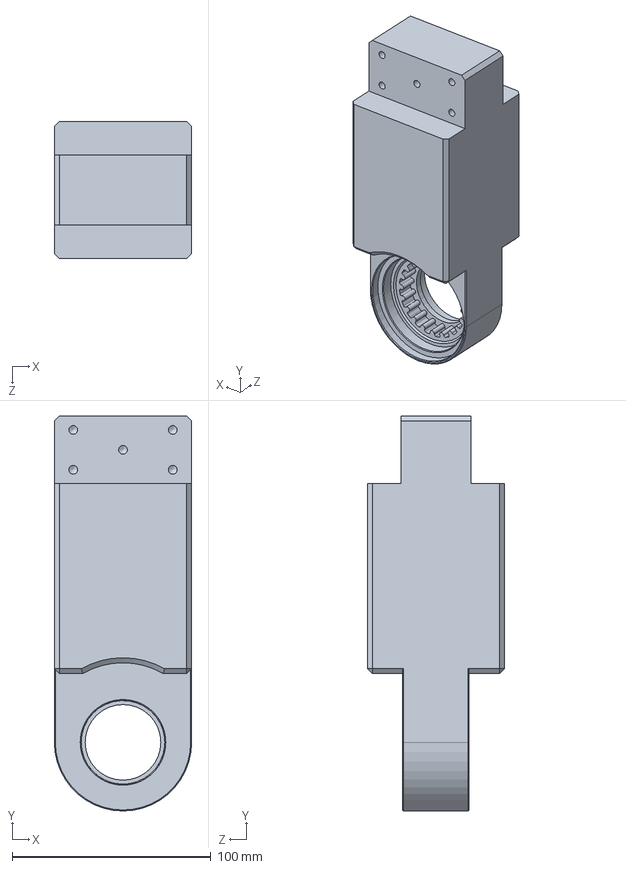
[picture p73: CAD file, 2026-10-24]
Mechanical/V6_rework/Parts_V6_rework/Upperarm_V6_rework/Upperame_construction/Upperarm_V6_rework.SLDPRT
69.0 x 198.5 x 69.0 mm
