EmanuelKaefer/Open-robot-arm/Mechanical/V6_rework/Parts_V6_rework/Wrist_V6_rework/Wrist_construction/Upper_Wrist_R_V6_rework.SLDPRT

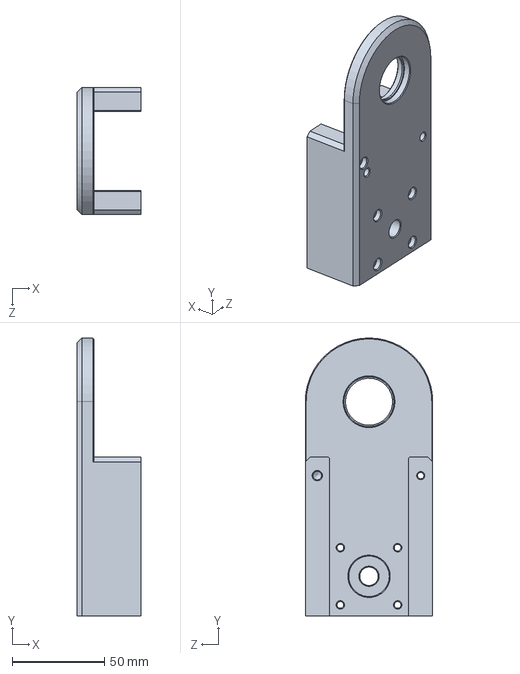
[picture p74: CAD file, 2026-10-24]
Mechanical/V6_rework/Parts_V6_rework/Wrist_V6_rework/Wrist_construction/Upper_Wrist_R_V6_rework.SLDPRT
34.5 x 150.5 x 69.0 mm
