EmanuelKaefer/Open-robot-arm/Mechanical/V6_rework/Parts_V6_rework/Wrist_V6_rework/Wrist_construction/Wrist_axle_construction/Wrist_axle_v6_rework.SLDPRT

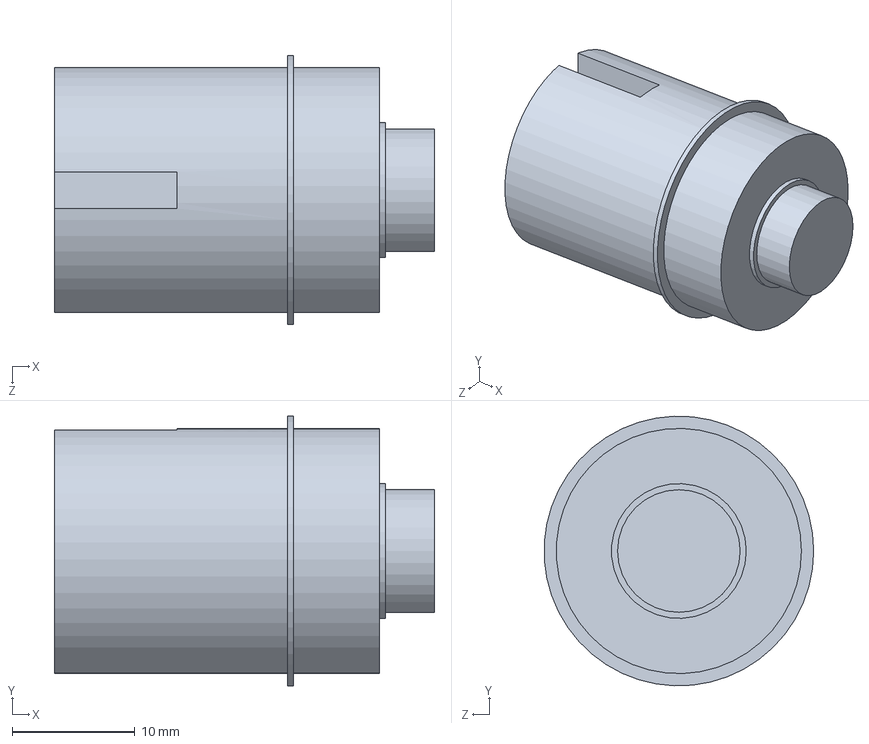
[picture p75: CAD file, 2026-10-23]
Mechanical/V6_rework/Parts_V6_rework/Wrist_V6_rework/Wrist_construction/Wrist_axle_construction/Wrist_axle_v6_rework.SLDPRT
31.0 x 22.0 x 22.0 mm
