EmanuelKaefer/Open-robot-arm/Software/robotarm/meshes/forearm_link.STL

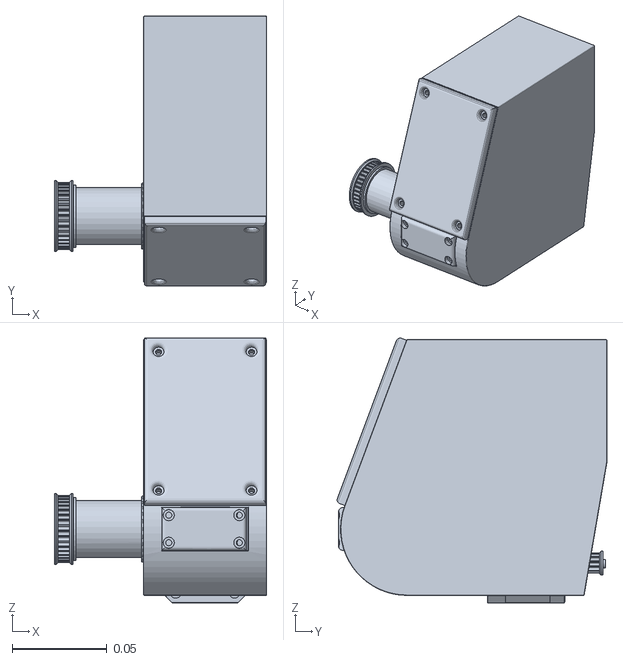
[picture p76: CAD file, 2025-12-04]
Software/robotarm/meshes/forearm_link.STL
0.112 x 0.142 x 0.14
