EmanuelKaefer/Open-robot-arm/Software/ros2_ws/src/robot_description/meshes/gripper_left_finger_link.STL

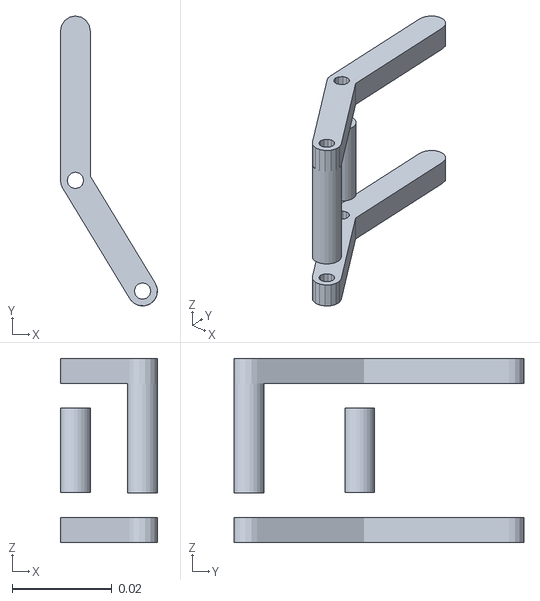
[picture p77: CAD file, 2025-12-04]
Software/ros2_ws/src/robot_description/meshes/gripper_left_finger_link.STL
0.0195 x 0.0582 x 0.037
