EmanuelKaefer/Open-robot-arm/Mechanical/V6/Prints/forearm/collision_forearm.SLDPRT

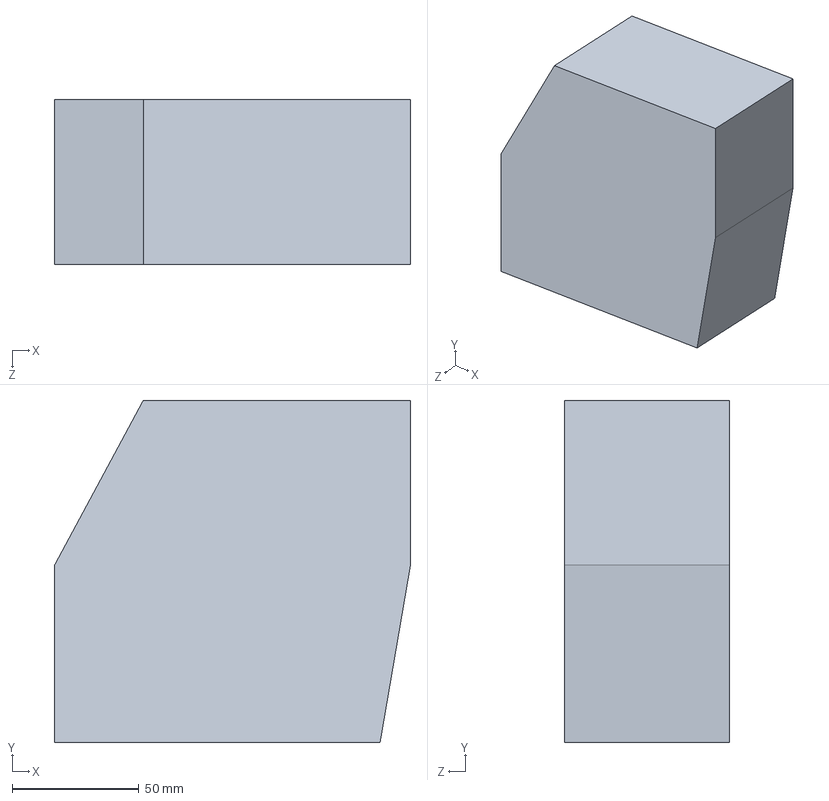
[picture p78: CAD file, 2025-11-24]
Mechanical/V6/Prints/forearm/collision_forearm.SLDPRT
140.4 x 135.0 x 65.0 mm
