EmanuelKaefer/Open-robot-arm/Mechanical/V6/Prints/upperarm/gear/upperarm_lower_gear.stl

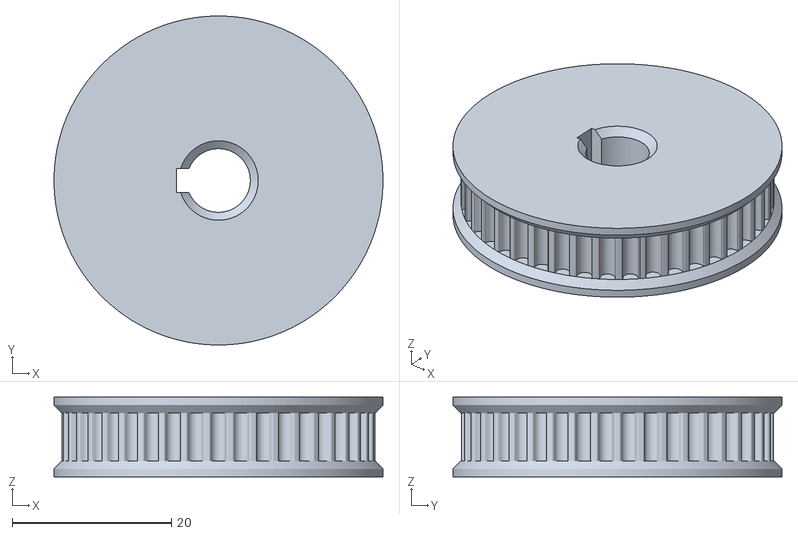
[picture p79: CAD file, 2025-11-23]
Mechanical/V6/Prints/upperarm/gear/upperarm_lower_gear.stl
41.3 x 41.3 x 10.0
