EmanuelKaefer/Open-robot-arm/Mechanical/V6_rework/Parts_V6_rework/Base_V6_rework/Base_construction/Rotating_plate_V6_rework.SLDPRT

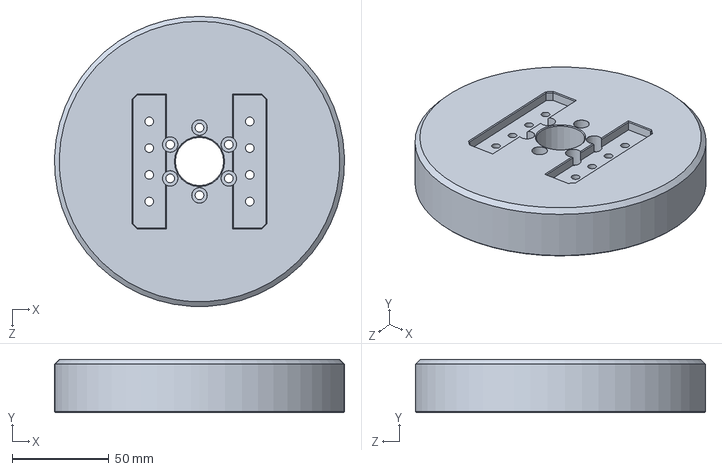
[picture p80: CAD file, 2026-10-23]
Mechanical/V6_rework/Parts_V6_rework/Base_V6_rework/Base_construction/Rotating_plate_V6_rework.SLDPRT
149.9 x 27.5 x 150.0 mm
