EmanuelKaefer/Open-robot-arm/Mechanical/V6_rework/Parts_V6_rework/Gripper_V6_rework/Gripper_construction/MGN7 rail.SLDPRT

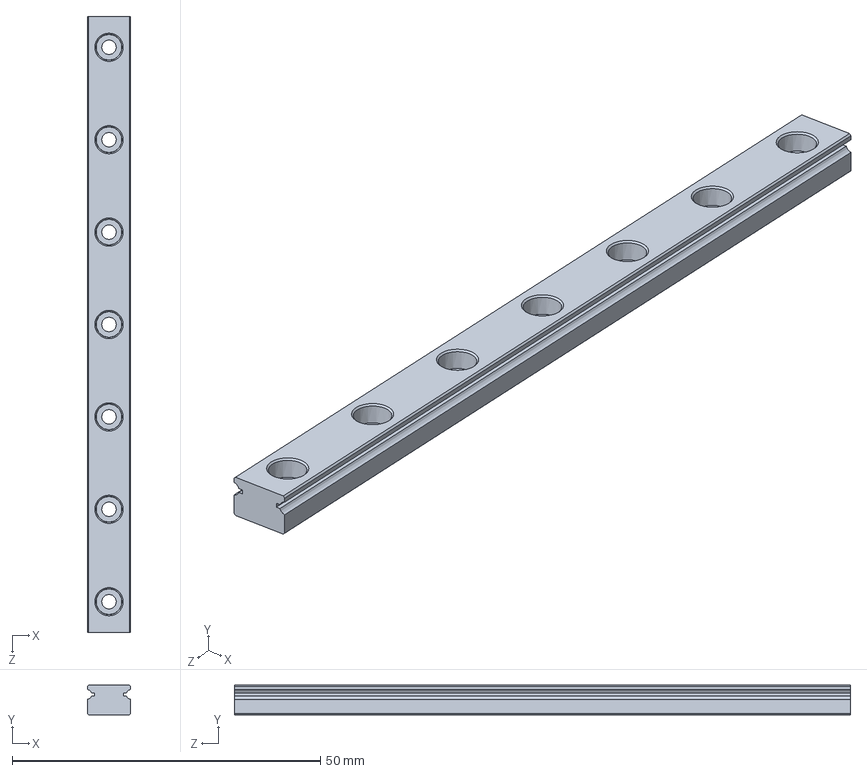
[picture p81: CAD file, 2026-10-23]
Mechanical/V6_rework/Parts_V6_rework/Gripper_V6_rework/Gripper_construction/MGN7 rail.SLDPRT
7.00 x 4.80 x 100.0 mm
