EmanuelKaefer/Open-robot-arm/Mechanical/V6_rework/Parts_V6_rework/Shoulder_V6_rework/Shoulder_L_V6_rework.SLDPRT

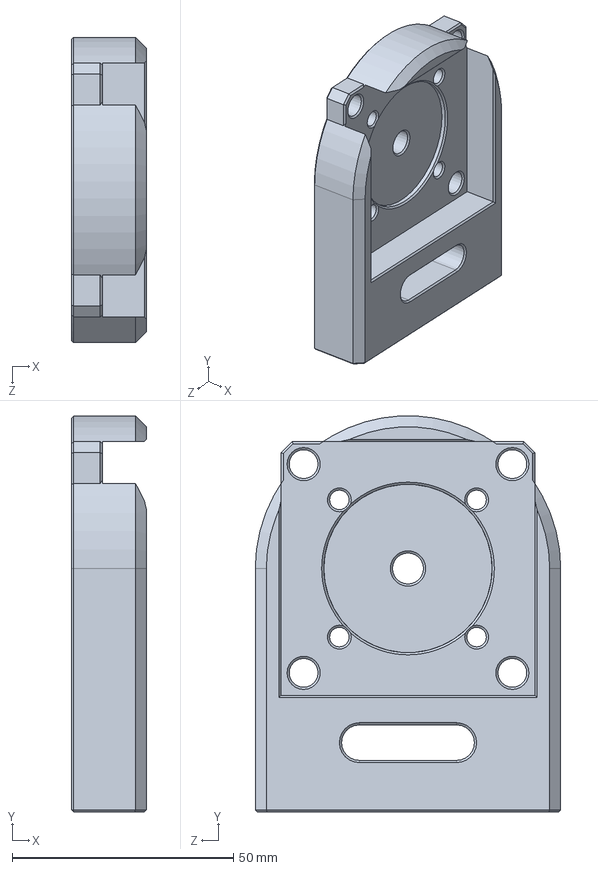
[picture p82: CAD file, 2026-10-23]
Mechanical/V6_rework/Parts_V6_rework/Shoulder_V6_rework/Shoulder_L_V6_rework.SLDPRT
17.0 x 89.4 x 69.0 mm
