EmanuelKaefer/Open-robot-arm/Mechanical/V6_rework/Parts_V6_rework/Wrist_V6_rework/Wrist_construction/Wrist_axial_bearing_dummy.SLDPRT

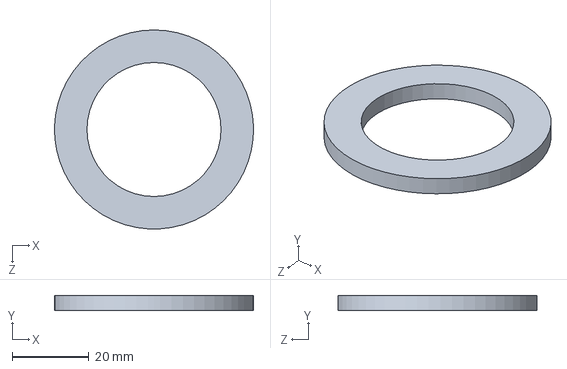
[picture p84: CAD file, 2026-10-24]
Mechanical/V6_rework/Parts_V6_rework/Wrist_V6_rework/Wrist_construction/Wrist_axial_bearing_dummy.SLDPRT
52.0 x 4.00 x 52.0 mm
