EmanuelKaefer/Open-robot-arm/Software/robotarm/meshes/gripper_right_drive_arm_link.STL

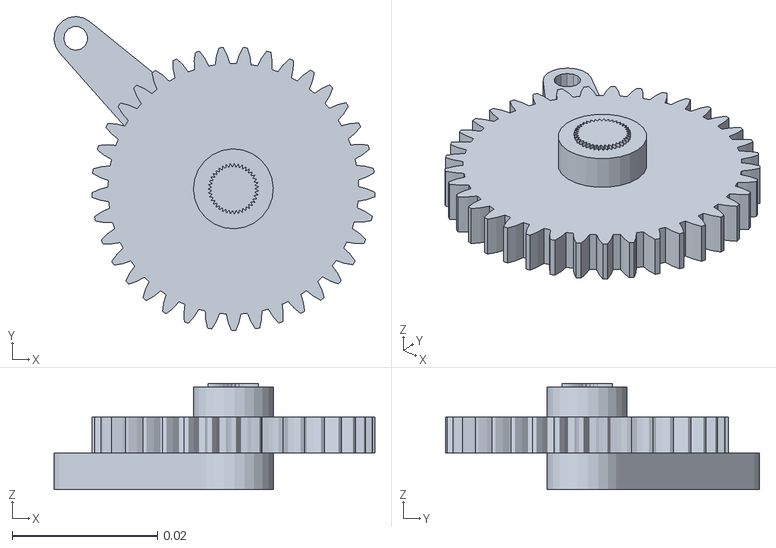
[picture p85: CAD file, 2025-12-04]
Software/robotarm/meshes/gripper_right_drive_arm_link.STL
0.0442 x 0.0432 x 0.0146
