EmanuelKaefer/Open-robot-arm/Mechanical/V6/Prints/gripper/gripperV2/gripper_parallel_arm.SLDPRT

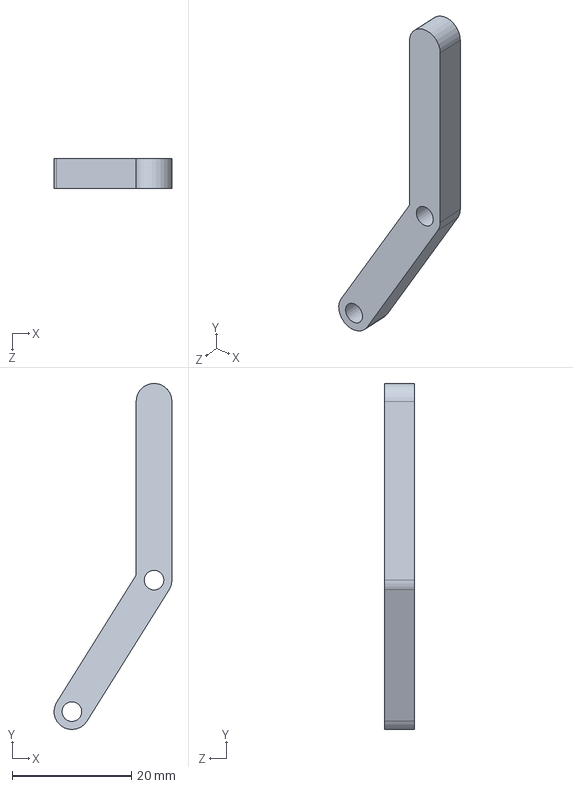
[picture p86: CAD file, 2025-12-02]
Mechanical/V6/Prints/gripper/gripperV2/gripper_parallel_arm.SLDPRT
19.8 x 58.0 x 5.00 mm
