EmanuelKaefer/Open-robot-arm/Mechanical/V6_rework/Parts_V6_rework/Base_V6_rework/Base_construction/Baseplate_V6_rework.SLDPRT

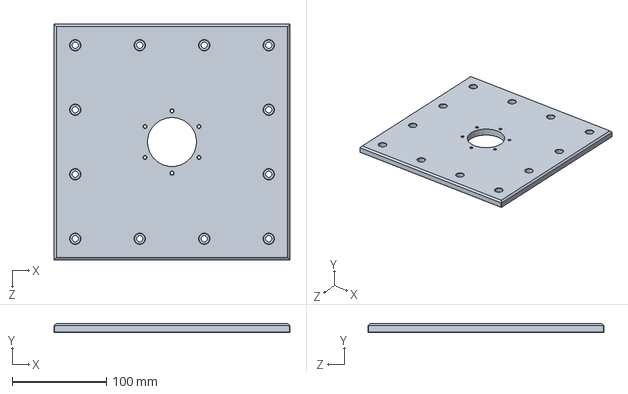
[picture p87: CAD file, 2026-10-23]
Mechanical/V6_rework/Parts_V6_rework/Base_V6_rework/Base_construction/Baseplate_V6_rework.SLDPRT
250.0 x 10.0 x 250.0 mm
