EmanuelKaefer/Open-robot-arm/Mechanical/V6_rework/Parts_V6_rework/Gripper_V6_rework/Gripper_construction/Gripper_finger_V6_rework.SLDPRT

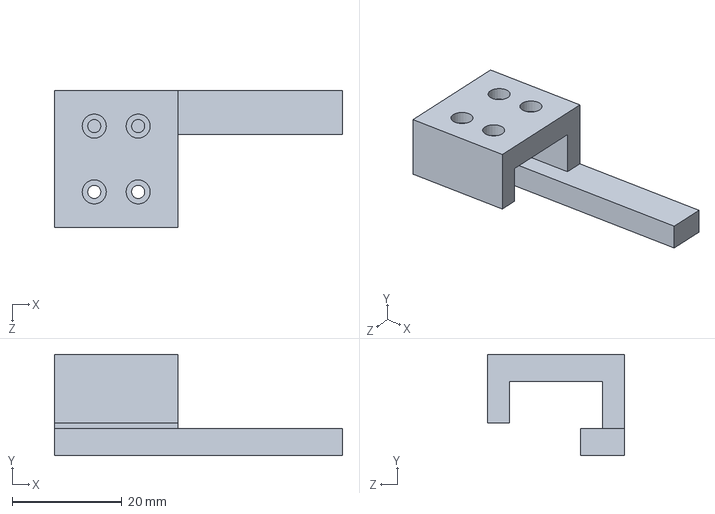
[picture p88: CAD file, 2026-10-23]
Mechanical/V6_rework/Parts_V6_rework/Gripper_V6_rework/Gripper_construction/Gripper_finger_V6_rework.SLDPRT
52.5 x 18.5 x 25.0 mm
