EmanuelKaefer/Open-robot-arm/Mechanical/V6_rework/Parts_V6_rework/Upperarm_V6_rework/Upperame_construction/Upperarm_L_holder_V6_rework.SLDPRT

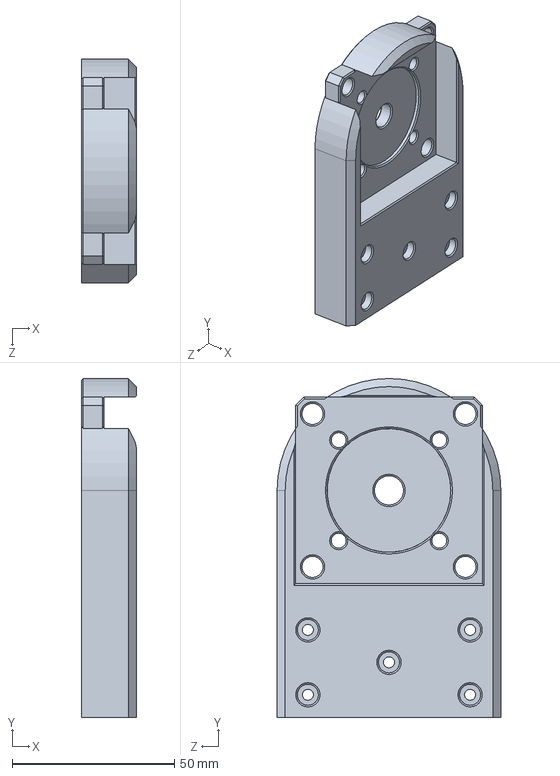
[picture p89: CAD file, 2026-10-23]
Mechanical/V6_rework/Parts_V6_rework/Upperarm_V6_rework/Upperame_construction/Upperarm_L_holder_V6_rework.SLDPRT
17.0 x 104.5 x 69.0 mm
