EmanuelKaefer/Open-robot-arm/Mechanical/V6_rework/Parts_V6_rework/Wrist_V6_rework/Wrist_construction/Lower_Wrist_V6_rework.SLDPRT

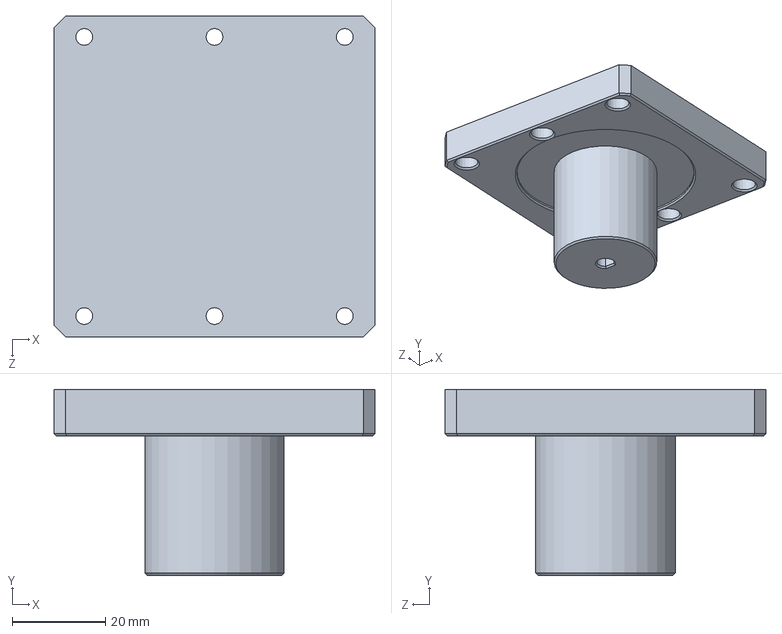
[picture p90: CAD file, 2026-10-24]
Mechanical/V6_rework/Parts_V6_rework/Wrist_V6_rework/Wrist_construction/Lower_Wrist_V6_rework.SLDPRT
69.0 x 40.0 x 69.0 mm
