EmanuelKaefer/Open-robot-arm/Mechanical/V6/Prints/gripper/gripperV2/gripper_arm_small_spacer.SLDPRT

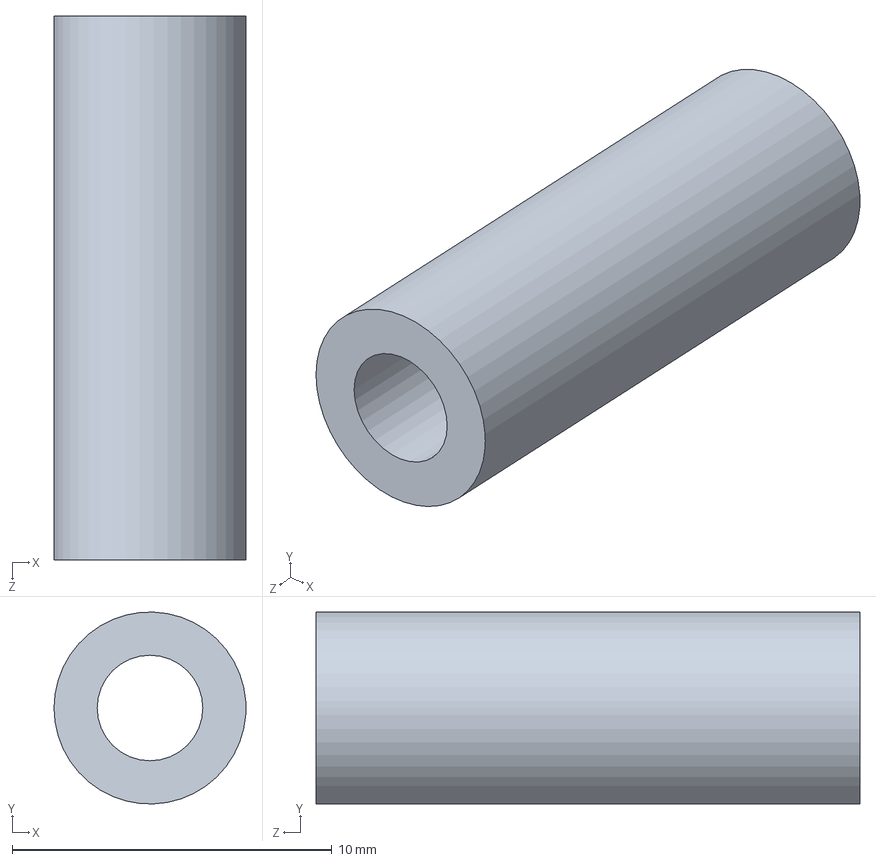
[picture p91: CAD file, 2025-12-02]
Mechanical/V6/Prints/gripper/gripperV2/gripper_arm_small_spacer.SLDPRT
6.00 x 6.00 x 17.0 mm
