EmanuelKaefer/Open-robot-arm/Mechanical/V6_rework/Parts_V6_rework/Base_V6_rework/Base_construction/bosch_profil_45x45x70mm.SLDPRT

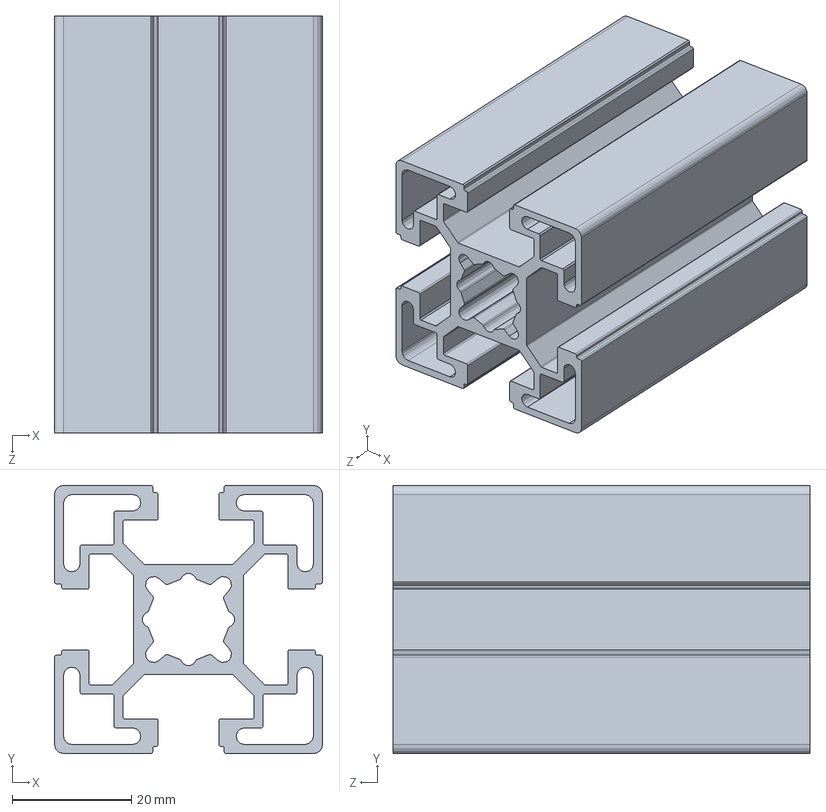
[picture p92: CAD file, 2026-10-23]
Mechanical/V6_rework/Parts_V6_rework/Base_V6_rework/Base_construction/bosch_profil_45x45x70mm.SLDPRT
45.0 x 45.0 x 70.0 mm
