EmanuelKaefer/Open-robot-arm/Mechanical/V6_rework/Parts_V6_rework/Gripper_V6_rework/Gripper_construction/MGN7C.SLDPRT

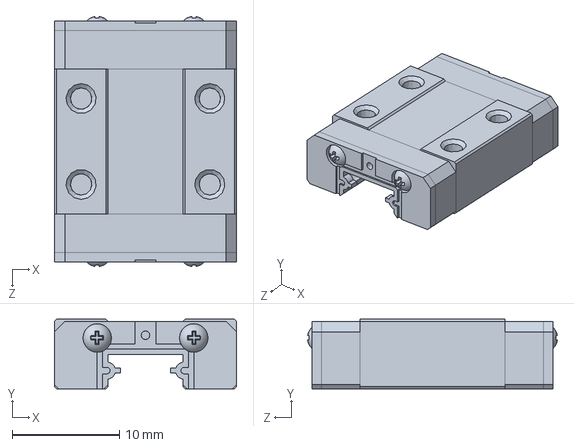
[picture p93: CAD file, 2026-10-23]
Mechanical/V6_rework/Parts_V6_rework/Gripper_V6_rework/Gripper_construction/MGN7C.SLDPRT
17.0 x 6.50 x 23.3 mm
