EmanuelKaefer/Open-robot-arm/Mechanical/V6_rework/Parts_V6_rework/Wrist_V6_rework/Wrist_construction/Wrist_axle_pinion_V6_rework.SLDPRT

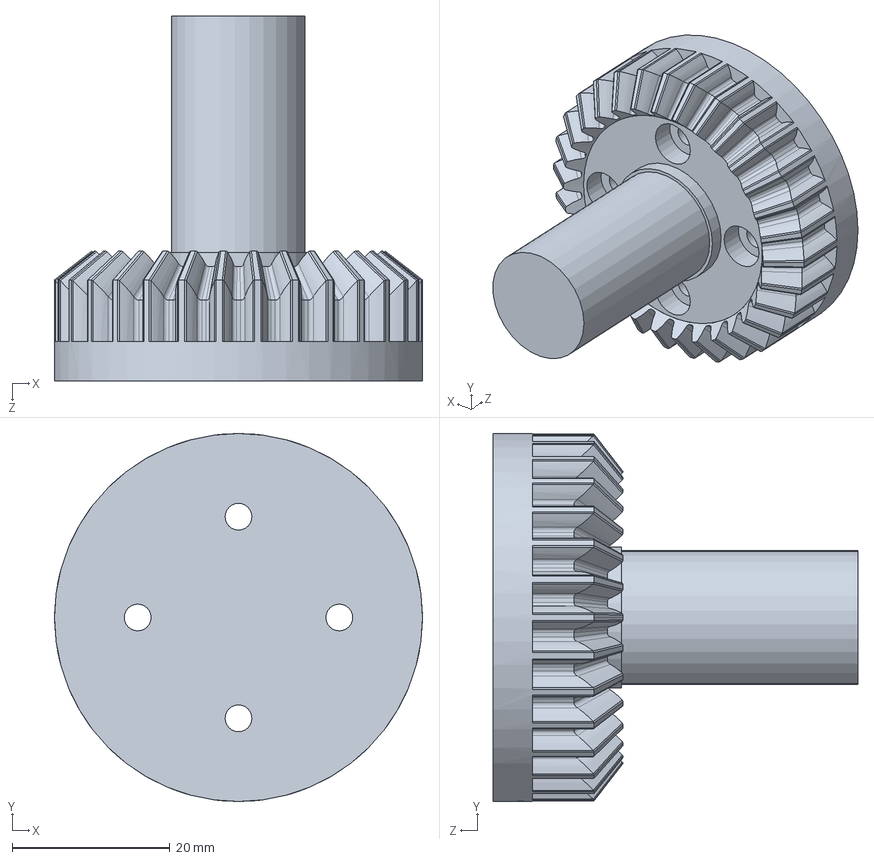
[picture p94: CAD file, 2026-10-24]
Mechanical/V6_rework/Parts_V6_rework/Wrist_V6_rework/Wrist_construction/Wrist_axle_pinion_V6_rework.SLDPRT
46.7 x 46.7 x 46.3 mm
