EmanuelKaefer/Open-robot-arm/Mechanical/V6_rework/Parts_V6_rework/Wrist_V6_rework/Wrist_construction/Wrist_axle_pinion_V6_rework-DESKTOP-4B5VSPA.SLDPRT

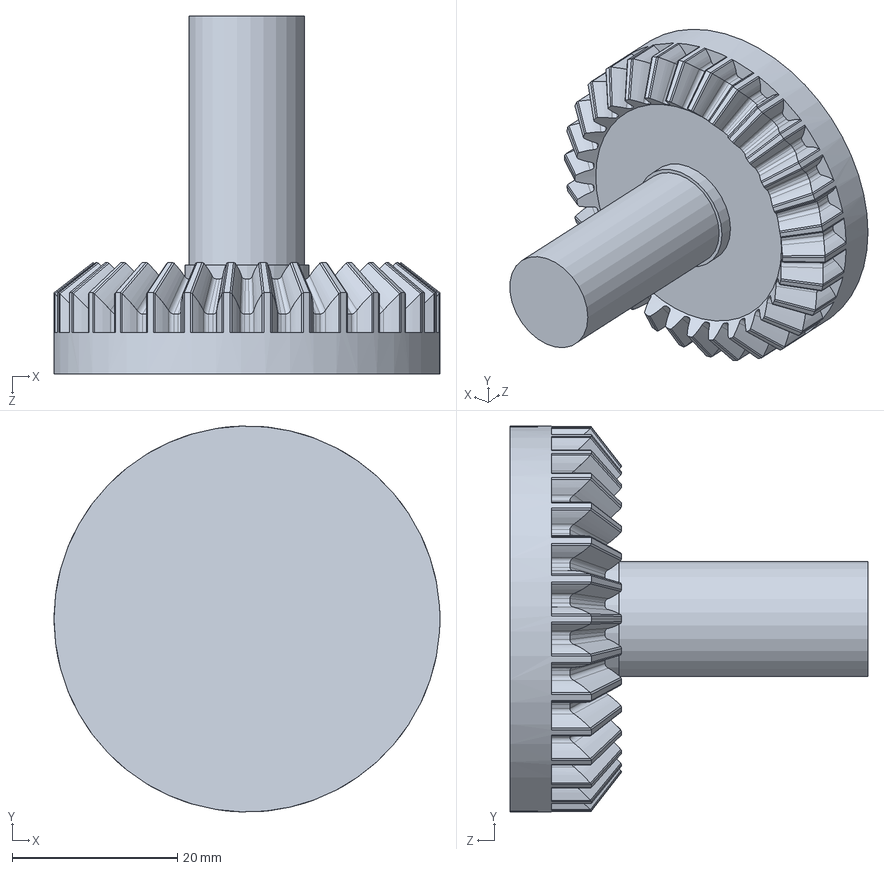
[picture p97: CAD file, 2026-10-24]
Mechanical/V6_rework/Parts_V6_rework/Wrist_V6_rework/Wrist_construction/Wrist_axle_pinion_V6_rework-DESKTOP-4B5VSPA.SLDPRT
46.7 x 46.7 x 43.3 mm
