EmanuelKaefer/Open-robot-arm/Mechanical/V6_rework/Parts_V6_rework/Base_V6_rework/Base_construction/Axis1_Axle_V6_rework.SLDPRT

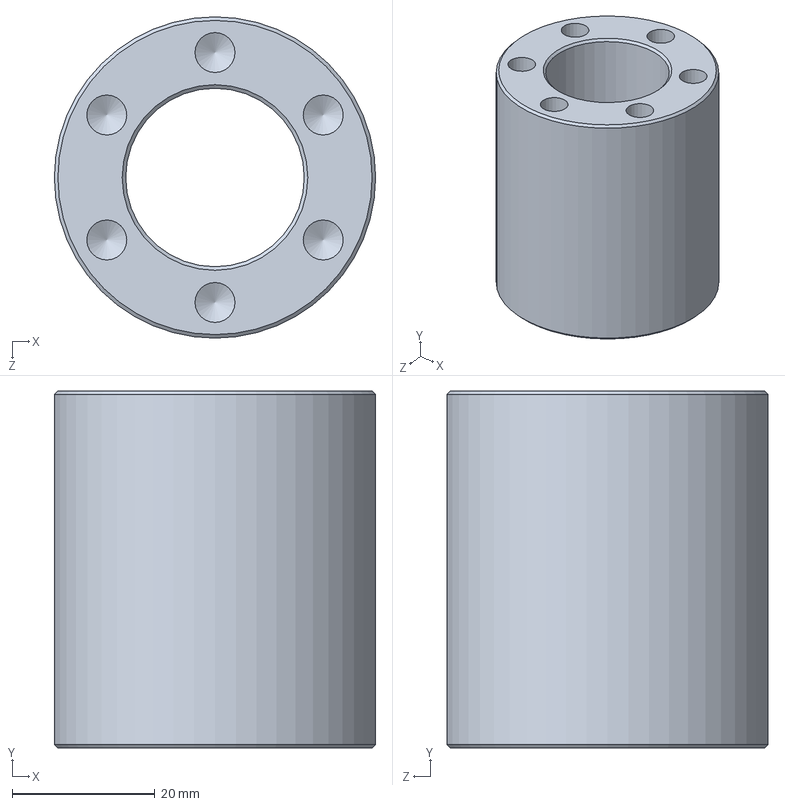
[picture p98: CAD file, 2026-10-23]
Mechanical/V6_rework/Parts_V6_rework/Base_V6_rework/Base_construction/Axis1_Axle_V6_rework.SLDPRT
45.0 x 50.0 x 45.0 mm
