EmanuelKaefer/Open-robot-arm/Mechanical/V6_rework/Parts_V6_rework/Wrist_V6_rework/Wrist_construction/Wrist_tilt_V6_rework.SLDPRT

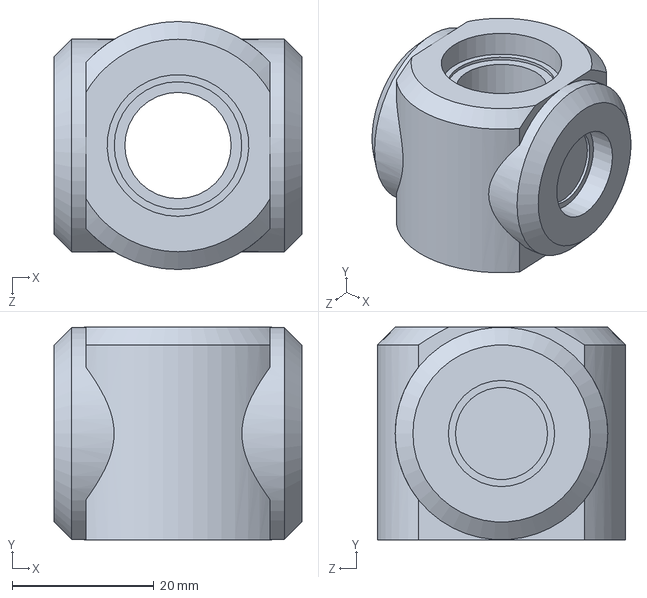
[picture p99: CAD file, 2026-10-24]
Mechanical/V6_rework/Parts_V6_rework/Wrist_V6_rework/Wrist_construction/Wrist_tilt_V6_rework.SLDPRT
35.0 x 30.0 x 35.0 mm
