EmanuelKaefer/Open-robot-arm/Mechanical/V6_rework/Parts_V6_rework/Base_V6_rework/Base_construction/T-Nuts_P10-M6.SLDPRT

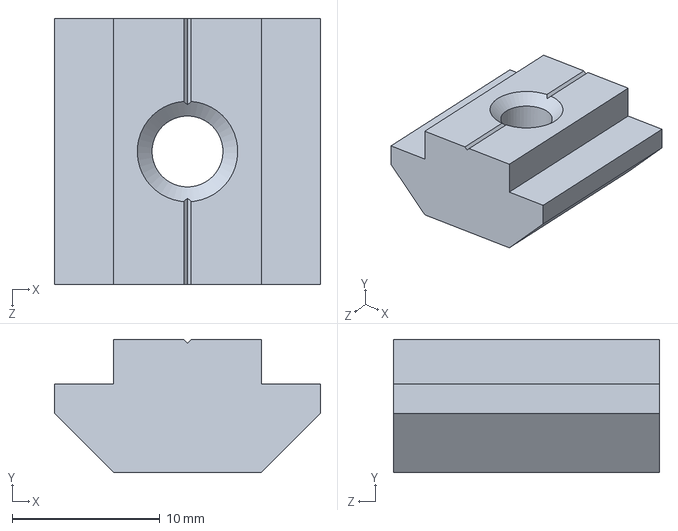
[picture p100: CAD file, 2026-10-20]
Mechanical/V6_rework/Parts_V6_rework/Base_V6_rework/Base_construction/T-Nuts_P10-M6.SLDPRT
18.0 x 9.00 x 18.0 mm
