EmanuelKaefer/Open-robot-arm/Mechanical/V6_rework/Parts_V6_rework/Wrist_V6_rework/Wrist_construction/Wrist_belt_tensioner_V6_rework.SLDPRT

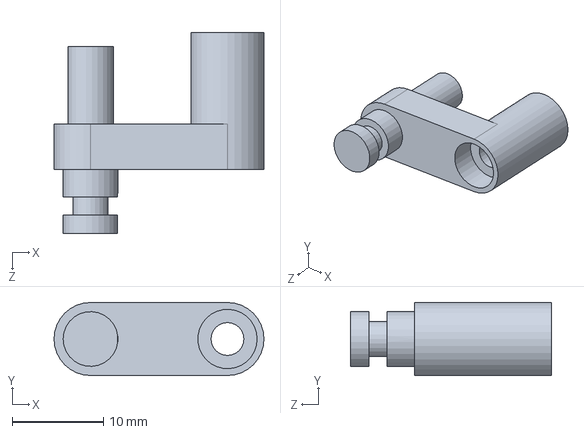
[picture p101: CAD file, 2026-10-24]
Mechanical/V6_rework/Parts_V6_rework/Wrist_V6_rework/Wrist_construction/Wrist_belt_tensioner_V6_rework.SLDPRT
23.0 x 8.00 x 22.0 mm
