EmanuelKaefer/Open-robot-arm/Mechanical/V6_rework/Parts_V6_rework/Wrist_V6_rework/Wrist_construction/Lower_pulley_HTD3M_16T_V6_rework.SLDPRT

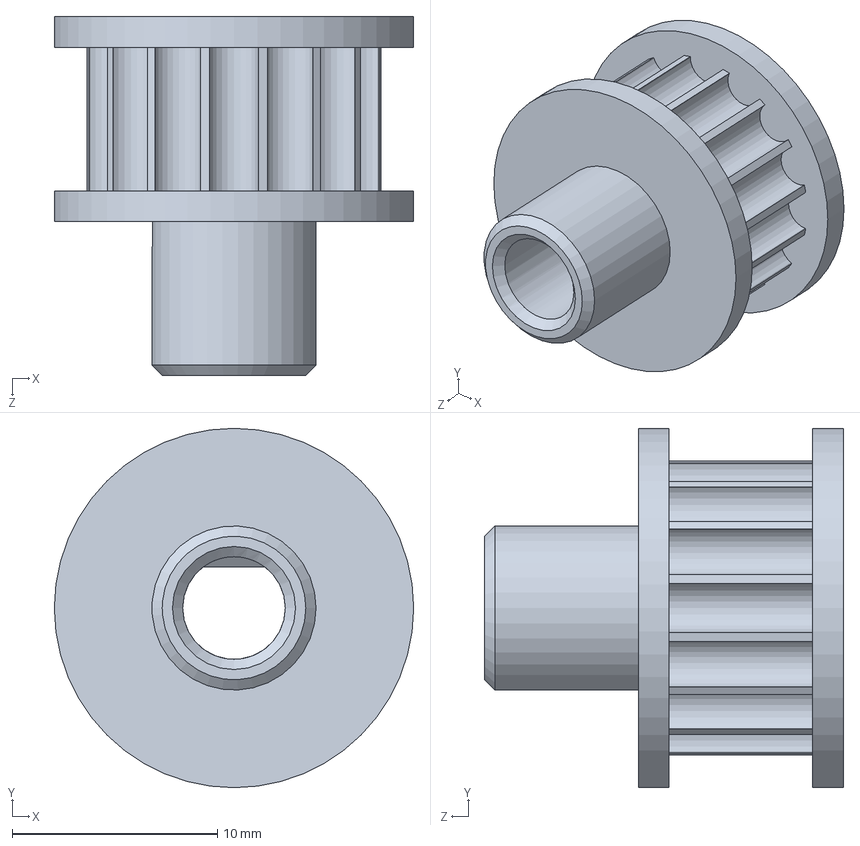
[picture p102: CAD file, 2026-10-23]
Mechanical/V6_rework/Parts_V6_rework/Wrist_V6_rework/Wrist_construction/Lower_pulley_HTD3M_16T_V6_rework.SLDPRT
17.5 x 17.5 x 17.5 mm
