EmanuelKaefer/Open-robot-arm/Mechanical/V6_rework/Parts_V6_rework/Wrist_V6_rework/Wrist_construction/Upper_pulley_HTD3M_48T_V6_rework.SLDPRT

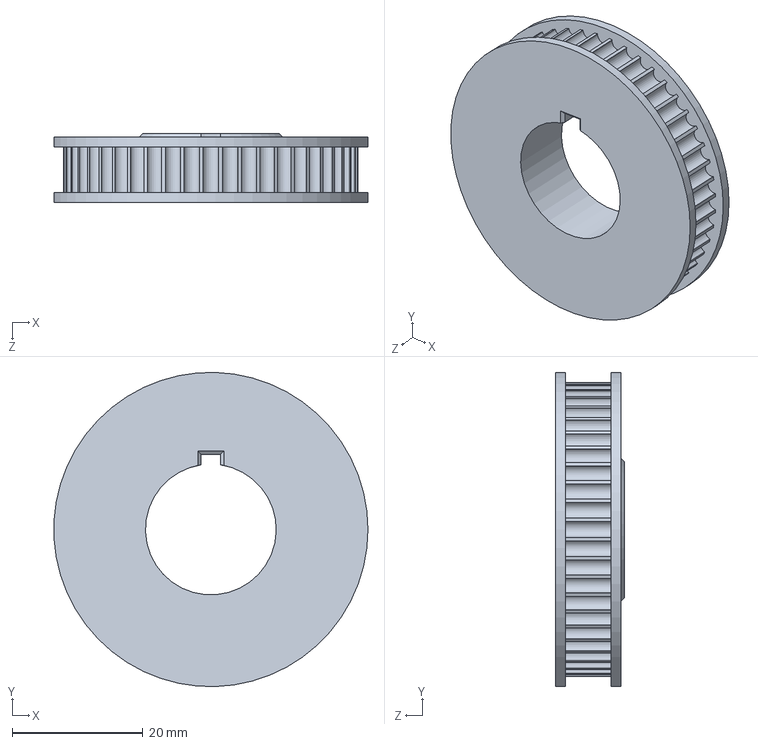
[picture p103: CAD file, 2026-10-23]
Mechanical/V6_rework/Parts_V6_rework/Wrist_V6_rework/Wrist_construction/Upper_pulley_HTD3M_48T_V6_rework.SLDPRT
48.0 x 48.1 x 10.5 mm
