EmanuelKaefer/Open-robot-arm/Mechanical/V6_rework/Parts_V6_rework/Wrist_V6_rework/Wrist_construction/Wrist_axle_gear_V6_rework.SLDPRT

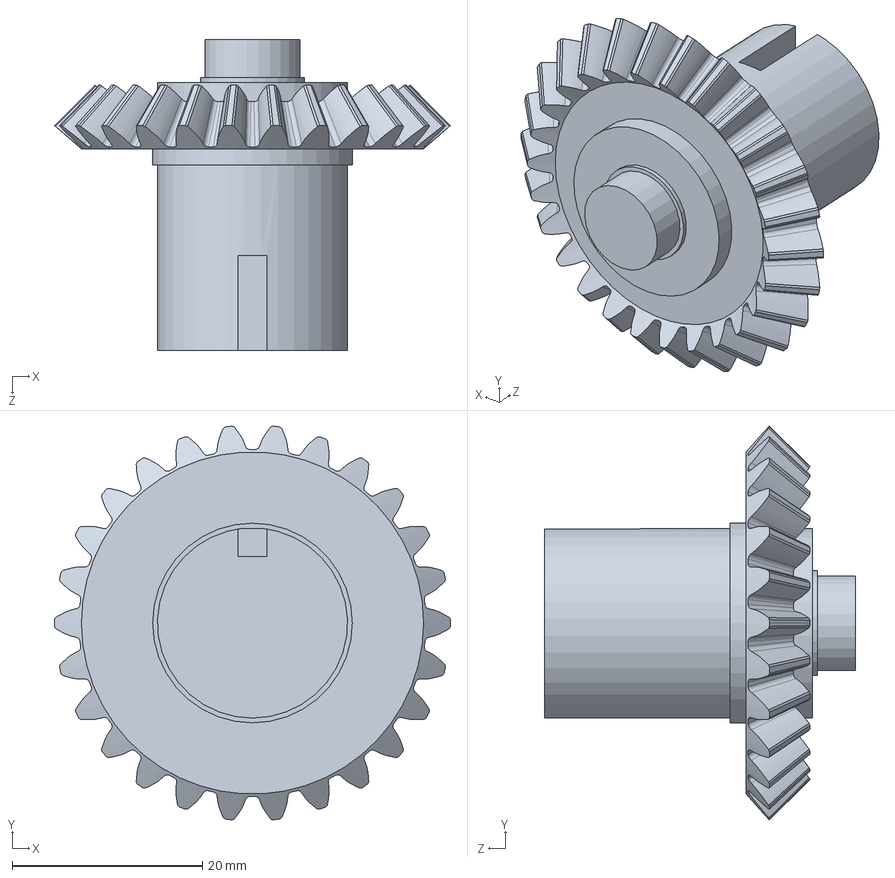
[picture p104: CAD file, 2026-10-23]
Mechanical/V6_rework/Parts_V6_rework/Wrist_V6_rework/Wrist_construction/Wrist_axle_gear_V6_rework.SLDPRT
41.7 x 41.4 x 32.7 mm
