EmanuelKaefer/Open-robot-arm/Mechanical/V6_rework/Parts_V6_rework/Wrist_V6_rework/Wrist_V6_rework.SLDASM

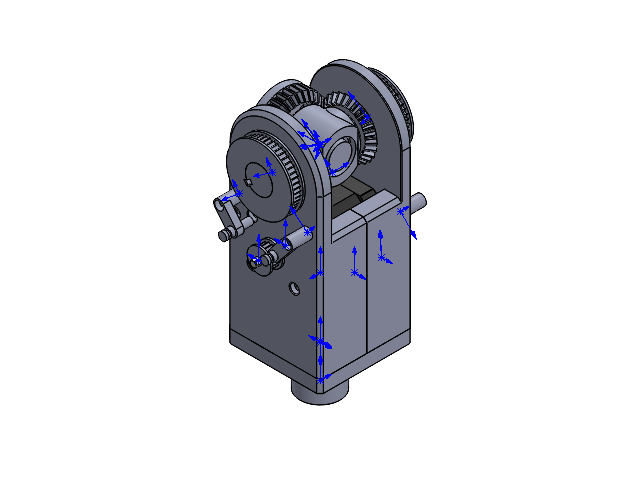
[picture p105: CAD file, 2026-10-24]
Mechanical/V6_rework/Parts_V6_rework/Wrist_V6_rework/Wrist_V6_rework.SLDASM
Lower_Wrist_V6_rework
Upper_Wrist_L_V6_rework
Upper_Wrist_R_V6_rework
Wrist_tilt_V6_rework
Wrist_axle_pinion_V6_rework
Wrist_axle_gear_V6_rework x 2
Upper_pulley_HTD3M_48T_V6_rework x 2
Lower_pulley_HTD3M_16T_V6_rework x 2
17HE19-2004S.step x 2
Wrist_axial_bearing_dummy
Wrist_belt_tensioner_V6_rework x 4
