EmanuelKaefer/Open-robot-arm/Mechanical/V6_rework/Parts_V6_rework/Wrist_V6_rework/Wrist_V6_rework-DESKTOP-4B5VSPA.SLDASM

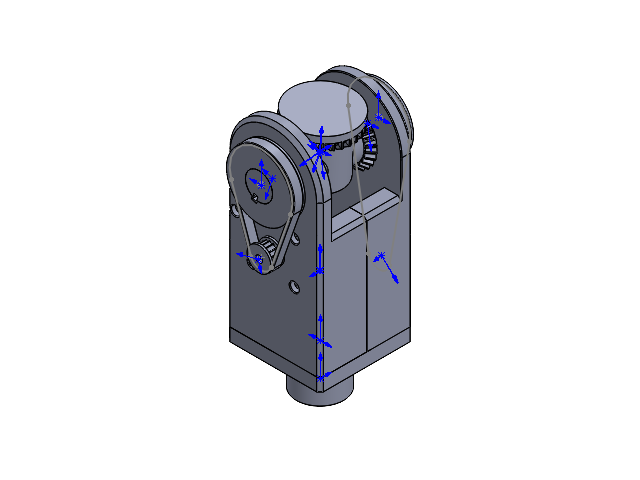
[picture p106: CAD file, 2026-10-24]
Mechanical/V6_rework/Parts_V6_rework/Wrist_V6_rework/Wrist_V6_rework-DESKTOP-4B5VSPA.SLDASM
Lower_Wrist_V6_rework
Upper_Wrist_L_V6_rework
Upper_Wrist_R_V6_rework
Wrist_tilt_V6_rework
Wrist_axle_pinion_V6_rework
Wrist_axle_gear_V6_rework x 2
Upper_pulley_HTD3M_48T_V6_rework x 2
Lower_pulley_HTD3M_16T_V6_rework x 2
Belt1-1^Wrist_V6_rework
Belt2-2^Wrist_V6_rework
