EmanuelKaefer/Open-robot-arm/(list of files, cad)

Other CAD files:
Mechanical/V6_rework/Parts_V6_rework/Base_V6_rework/Base_V6_rework.SLDASM
Mechanical/V6_rework/Parts_V6_rework/Forearm_V6_rework/Forearm_V6_rework-DESKTOP-4B5VSPA.SLDASM
Mechanical/V6_rework/Parts_V6_rework/Upperarm_V6_rework/Upperarm_V6_rework-DESKTOP-4B5VSPA.SLDASM
Mechanical/V6_rework/Parts_V6_rework/Forearm_V6_rework/Forearm_construction/Forearm_V6_rework.SLDPRT
Mechanical/V6_rework/Parts_V6_rework/Wrist_V6_rework/Wrist_construction/Upper_Wrist_L_V6_rework.SLDPRT
Mechanical/V1/Grundgerüst_Achsen_V1.SLDASM
Mechanical/V1/Mittelarm_V1.SLDPRT
Mechanical/V1/Oberarm_V1.SLDPRT
Mechanical/V1/Unterste_Achse_V1.SLDPRT
Mechanical/V2/3mf/Hüsei_unten.3MF
Mechanical/V2/3mf/Prototyp_Mittelarm_V2.3MF
Mechanical/V2/3mf/Prototyp_Oberarm_Mount_V2.3MF
Mechanical/V2/3mf/Prototyp_Oberarm_V2.3MF
Mechanical/V2/Hüsei_unten.SLDPRT
Mechanical/V2/Parts/Kugellager-Axial/171977864-7-skf_bearing_51105_2/skf_bearing_51105_2.SLDASM
Mechanical/V2/Parts/Kugellager-Axial/171977864-7-skf_bearing_51105_2/skf_bearing_51105_2_01.SLDPRT
Mechanical/V2/Parts/Kugellager-Axial/171977864-7-skf_bearing_51105_2/skf_bearing_51105_2_02.SLDPRT
Mechanical/V2/Parts/Kugellager-Axial/171977864-7-skf_bearing_51105_2/skf_bearing_51105_2_03.SLDPRT
Mechanical/V2/Parts/Kugellager-Radial/171978234-7-w_619_9-2z/3mf/w_619_9-2z.3MF
Mechanical/V2/Parts/Kugellager-Radial/171978234-7-w_619_9-2z/w_619_9-2z.SLDASM
Mechanical/V2/Parts/Kugellager-Radial/171978234-7-w_619_9-2z/w_619_9-2z_01.SLDPRT
Mechanical/V2/Parts/Kugellager-Radial/171978234-7-w_619_9-2z/w_619_9-2z_02.SLDPRT
Mechanical/V2/Parts/Kugellager-Radial/171978234-7-w_619_9-2z/w_619_9-2z_03.SLDPRT
Mechanical/V2/Parts/Kugellager-Radial/171978234-7-w_619_9-2z/w_619_9-2z_04.SLDPRT
Mechanical/V2/Parts/Kugellager-Radial/171978234-7-w_619_9-2z/w_619_9-2z_05.SLDPRT
Mechanical/V2/Parts/Schrägkugellager/171978786-7-skf_bearing_7200_bep_2/skf_bearing_7200_bep_2.SLDASM
Mechanical/V2/Parts/Schrägkugellager/171978786-7-skf_bearing_7200_bep_2/skf_bearing_7200_bep_2_01.SLDPRT
Mechanical/V2/Parts/Schrägkugellager/171978786-7-skf_bearing_7200_bep_2/skf_bearing_7200_bep_2_02.SLDPRT
Mechanical/V2/Parts/Schrägkugellager/171978786-7-skf_bearing_7200_bep_2/skf_bearing_7200_bep_2_03.SLDPRT
Mechanical/V2/Prototyp_Grundgerüst_V2.SLDPRT.SLDASM
Mechanical/V2/Prototyp_Mittelarm_V2.SLDPRT
Mechanical/V2/Prototyp_Oberarm_Mount_V2.SLDPRT
Mechanical/V2/Prototyp_Oberarm_V2.SLDPRT
Mechanical/V3/Base_V3.SLDPRT
Mechanical/V3/Main_V3.SLDPRT
Mechanical/V3/Main_V3_2.SLDPRT
Mechanical/V3/Nema 17 Gear Stepper Motor 50 to 1 Planetary Gearbox (17HS15-1684D-EG50-AR4).SLDPRT
Mechanical/V3/Nema-17_17HS24-2104S.SLDPRT
Mechanical/V3/Overworked/Base_g_V3.SLDASM
Mechanical/V3/Overworked/Base_g_V3.SLDPRT
Mechanical/V3/Overworked/Nema_wg_V3.SLDASM
Mechanical/V3/Overworked/Oberarm_shell-V3.SLDPRT
Mechanical/V3/Overworked/Robo_wB_V3.SLDASM
Mechanical/V3/Overworked/Robo_wB_V3_2.SLDASM
Mechanical/V3/Robo_V3.SLDASM
Mechanical/V3/V3_3/172219421-7-skf_bearing_30202_2/skf_bearing_30202_2.SLDASM
Mechanical/V3/V3_3/172219421-7-skf_bearing_30202_2/skf_bearing_30202_2_01.SLDPRT
Mechanical/V3/V3_3/172219421-7-skf_bearing_30202_2/skf_bearing_30202_2_02.SLDPRT
Mechanical/V3/V3_3/172219421-7-skf_bearing_30202_2/skf_bearing_30202_2_03.SLDPRT
Mechanical/V3/V3_3/172308679-7-61904/61904.3mf
Mechanical/V3/V3_3/172308679-7-61904/61904.SLDASM
Mechanical/V3/V3_3/172308679-7-61904/61904_01.SLDPRT
Mechanical/V3/V3_3/172308679-7-61904/61904_02.SLDPRT
Mechanical/V3/V3_3/172308679-7-61904/61904_03.SLDPRT
Mechanical/V3/V3_3/172454229-7-635/635.3mf
Mechanical/V3/V3_3/172454229-7-635/635.SLDASM
Mechanical/V3/V3_3/172454229-7-635/635_01.SLDPRT
Mechanical/V3/V3_3/172454229-7-635/635_02.SLDPRT
Mechanical/V3/V3_3/172454229-7-635/635_03.SLDPRT
Mechanical/V3/V3_3/172540569-7-61805/61805.3mf
Mechanical/V3/V3_3/172540569-7-61805/61805.SLDASM
Mechanical/V3/V3_3/172540569-7-61805/61805_01.SLDPRT
Mechanical/V3/V3_3/172540569-7-61805/61805_02.SLDPRT
Mechanical/V3/V3_3/172540569-7-61805/61805_03.SLDPRT
Mechanical/V3/V3_3/173678980-7-skf_bearing_51110_2/Print/51110_balls.3MF
Mechanical/V3/V3_3/173678980-7-skf_bearing_51110_2/Print/51110_balls.STEP
Mechanical/V3/V3_3/173678980-7-skf_bearing_51110_2/Print/51110_bottom.3MF
Mechanical/V3/V3_3/173678980-7-skf_bearing_51110_2/Print/51110_bottom.STEP
Mechanical/V3/V3_3/173678980-7-skf_bearing_51110_2/Print/51110_top.3MF
Mechanical/V3/V3_3/173678980-7-skf_bearing_51110_2/Print/51110_top.STEP
Mechanical/V3/V3_3/173678980-7-skf_bearing_51110_2/skf_bearing_51110_2.SLDASM
Mechanical/V3/V3_3/173678980-7-skf_bearing_51110_2/skf_bearing_51110_2_01.SLDPRT
Mechanical/V3/V3_3/173678980-7-skf_bearing_51110_2/skf_bearing_51110_2_02.SLDPRT
Mechanical/V3/V3_3/173678980-7-skf_bearing_51110_2/skf_bearing_51110_2_03.SLDPRT
Mechanical/V3/V3_3/173679759-7-61810/61810.SLDASM
Mechanical/V3/V3_3/173679759-7-61810/61810_01.SLDPRT
Mechanical/V3/V3_3/173679759-7-61810/61810_02.SLDPRT
Mechanical/V3/V3_3/173679759-7-61810/61810_03.SLDPRT
Mechanical/V3/V3_3/3D Print Planetary gearbox/Planet.stl
Mechanical/V3/V3_3/3D Print Planetary gearbox/body_lower.stl
Mechanical/V3/V3_3/3D Print Planetary gearbox/carrier.stl
Mechanical/V3/V3_3/3D Print Planetary gearbox/lid.stl
Mechanical/V3/V3_3/3D Print Planetary gearbox/output_shaft.stl
Mechanical/V3/V3_3/3D Print Planetary gearbox/sun_gear.stl
Mechanical/V3/V3_3/3mfs/Cabelhousing_Oberarm.3MF
Mechanical/V3/V3_3/3mfs/Gears/gt2 5mm/gt2_5m_9mm_15T_oberarm_unten.stl
Mechanical/V3/V3_3/3mfs/Gears/gt2 5mm/gt2_5m_9mm_30T_oberarm_oben.stl
Mechanical/V3/V3_3/3mfs/Gears/gt2 5mm/gt2_5m_9mm_35T_oberarm_oben.stl
Mechanical/V3/V3_3/3mfs/Gears/gt2 5mm/gt2_5m_9mm_42T_oberarm_oben.stl
Mechanical/V3/V3_3/3mfs/Gears/oberarm_gear_oben_gt2 3mm.stl
Mechanical/V3/V3_3/3mfs/Gears/oberarm_gear_unten_gt2 3mm.stl
Mechanical/V3/V3_3/3mfs/Oberarm_om.3MF
Mechanical/V3/V3_3/3mfs/main_joint.3MF
Mechanical/V3/V3_3/3mfs/motor_holder_main_joint.3MF
Mechanical/V3/V3_3/3mfs/oberarm_cabelcover.3MF
Mechanical/V3/V3_3/3mfs/oberarm_cover.3mf
Mechanical/V3/V3_3/3mfs/plate 1.3mf
Mechanical/V3/V3_3/3mfs/step/Belt_tensioner_oberarm.STEP
Mechanical/V3/V3_3/3mfs/step/Cabelhousing_Oberarm.STEP
Mechanical/V3/V3_3/3mfs/step/Forearm_2.3MF
Mechanical/V3/V3_3/3mfs/step/Forearm_2.STEP
Mechanical/V3/V3_3/3mfs/step/Forearm_gear_spacer.STEP
Mechanical/V3/V3_3/3mfs/step/Motor_ccoupling_8mm_V3_3.STEP
Mechanical/V3/V3_3/3mfs/step/Oberarm_gear_oben.3mf
Mechanical/V3/V3_3/3mfs/step/Oberarm_gear_oben.STEP
Mechanical/V3/V3_3/3mfs/step/Oberarm_gear_unten.STEP
Mechanical/V3/V3_3/3mfs/step/Oberarm_gear_unten_endcap.STEP
Mechanical/V3/V3_3/3mfs/step/Oberarm_gear_unten_spacer.STEP
Mechanical/V3/V3_3/3mfs/step/Oberarm_om.STEP
Mechanical/V3/V3_3/3mfs/step/achse_motor.STEP
Mechanical/V3/V3_3/3mfs/step/achse_motor_V3.STEP
Mechanical/V3/V3_3/3mfs/step/first_joint.3mf
Mechanical/V3/V3_3/3mfs/step/first_joint.STEP
Mechanical/V3/V3_3/3mfs/step/main_joint.STEP
Mechanical/V3/V3_3/3mfs/step/main_joint_achse.STEP
Mechanical/V3/V3_3/3mfs/step/main_joint_achse_endcap.STEP
Mechanical/V3/V3_3/3mfs/step/main_joint_bearing_spacer.STEP
Mechanical/V3/V3_3/3mfs/step/main_joint_w_gear.STEP
Mechanical/V3/V3_3/3mfs/step/main_support.STEP
Mechanical/V3/V3_3/3mfs/step/motor_cuppling_3dprint.STEP
Mechanical/V3/V3_3/3mfs/step/motor_holder.STEP
Mechanical/V3/V3_3/3mfs/step/motor_holder_ohne gearbox.STEP
Mechanical/V3/V3_3/3mfs/step/oberarm_achse unten_V2.STEP
Mechanical/V3/V3_3/3mfs/step/oberarm_achse.STEP
Mechanical/V3/V3_3/3mfs/step/oberarm_achse_spacer.STEP
Mechanical/V3/V3_3/3mfs/step/oberarm_cabelcover.STEP
Mechanical/V3/V3_3/3mfs/step/oberarm_cover.STEP
Mechanical/V3/V3_3/3mfs/step/riemen_2.STEP
Mechanical/V3/V3_3/3mfs/step/riemen_gt2_3mm.3mf
Mechanical/V3/V3_3/3mfs/step/riemen_gt2_3mm.stl
Mechanical/V3/V3_3/3mfs/step/riemen_maybe.STEP
Mechanical/V3/V3_3/3mfs/step/test__achse.STEP
Mechanical/V3/V3_3/3mfs/step/test__achse_motor.STEP
Mechanical/V3/V3_3/Base mo.SLDASM
Mechanical/V3/V3_3/Base_Colision.SLDPRT
Mechanical/V3/V3_3/Base_shoulder.SLDASM
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
