EmanuelKaefer/Open-robot-arm/Electrical/test_board/README.txt

# Test Board

This board will test the motor drivers and SPI communication before actually implementing them on the driver board.
