EmanuelKaefer/Open-robot-arm/Electrical/test_board/Measurements/Temperature Measurements.xlsx

Temperature measurments during 2-Axis testrun
All temperatures +/. 1.5°C due to thermal imager inconsistencies
With 2-Axis: |  |  |  | For 2min run
STM-Nucleo: |  | TMC's: |  | Board: |  | Motors:
V-Reg U3 | 31°C | Heatsink | 47°C | Traces | 31°C | Steppers | 46°C incl. Idle
MCU U5 | 31°C | Chip | 48°C
Debug U2 | 35°C
With 2-Axis: |  |  |  | For 10min run
STM-Nucleo: |  | TMC's: |  | Board:
V-Reg U3 | 31°C | Heatsink | 48°C | Traces | 31°C | Steppers: | 47°C incl. Idle
MCU U5 | 31°C | Chip | 49,5C
Debug U2 | 35°C
