EmanuelKaefer/Open-robot-arm/Software/test_codes/log.csv

t_s | soll0 | ist0 | fehler0 | soll1 | ist1 | fehler1
0.0 | 0 | 0 | 0 | 0 | 0 | 0
0.01 | 0 | 0 | 0 | 0 | 0 | 0
0.02 | 0 | 0 | 0 | 0 | 0 | 0
0.03 | 0 | 0 | 0 | 0 | 0 | 0
0.04 | 0 | 0 | 0 | 0 | 0 | 0
0.05 | 0 | 0 | 0 | 0 | 0 | 0
0.06 | 0 | 0 | 0 | 0 | 0 | 0
0.07 | 0 | 0 | 0 | 0 | 0 | 0
0.08 | 0 | 0 | 0 | 0 | 0 | 0
0.09 | 0 | 0 | 0 | 0 | 0 | 0
0.1 | 0 | 0 | 0 | 0 | 0 | 0
0.11 | 0 | 0 | 0 | 0 | 0 | 0
0.12 | 0 | 0 | 0 | 0 | 0 | 0
0.13 | 0 | 0 | 0 | 0 | 0 | 0
0.14 | 0 | 0 | 0 | 0 | 0 | 0
0.15 | 0 | 0 | 0 | 0 | 0 | 0
0.16 | 0 | 0 | 0 | 0 | 0 | 0
0.17 | 0 | 0 | 0 | 0 | 0 | 0
0.18 | 0 | 0 | 0 | 0 | 0 | 0
0.19 | 0 | 0 | 0 | 0 | 0 | 0
0.2 | 0 | 0 | 0 | 0 | 0 | 0
0.21 | 0 | 0 | 0 | 0 | 0 | 0
0.22 | 0 | 0 | 0 | 0 | 0 | 0
0.23 | 0 | 0 | 0 | 0 | 0 | 0
0.24 | 0 | 0 | 0 | 0 | 0 | 0
0.25 | 0 | 0 | 0 | 0 | 0 | 0
0.26 | 0 | 0 | 0 | 0 | 0 | 0
0.27 | 0 | 0 | 0 | 0 | 0 | 0
0.28 | 0 | 0 | 0 | 0 | 0 | 0
0.29 | 0 | 0 | 0 | 0 | 0 | 0
0.3 | 0 | 0 | 0 | 0 | 0 | 0
0.31 | 1 | 1 | 0 | 1 | 1 | 0
0.32 | 3 | 3 | 0 | 3 | 3 | 0
0.33 | 6 | 5 | -1 | 6 | 5 | -1
0.34 | 9 | 8 | -1 | 9 | 8 | -1
0.35000000000000003 | 13 | 12 | -1 | 13 | 12 | -1
0.36 | 18 | 16 | -2 | 18 | 16 | -2
0.37 | 23 | 22 | -1 | 23 | 22 | -1
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
