EmanuelKaefer/Open-robot-arm/Mechanical/V3/V3_3/PerformanceLog.txt

Number of Contacts: 1222
Number of contact data: 53877
