EmanuelKaefer/Open-robot-arm/doc/Software/issue interruptforhoming[27.04.2026].odt

Technische Dokumentation

Interrupt-gesteuerte Motorsteuerung mit TMC5160T auf STM32F446RE

Roboterarm-Projekt – Achse 1 Homing-System

1. Projektkontext und Systemarchitektur

Das vorliegende System ist Teil eines 6-Achs-Roboterarms, der mit STM32F446RE-Mikrocontrollern und TMC5160T-Schrittmotortreibern betrieben wird. Jede Achse wird von einem eigenen TMC5160T-Treiber angesteuert, der per SPI konfiguriert wird und im Step/Direction-Modus betrieben wird.

Zum Homing (Referenzfahrt) verwendet das System mechanische Endschalter (Limit Switches), die als Interrupts konfiguriert sind. Wenn ein Endschalter betätigt wird, soll der zugehörige Motor sofort stoppen und in einem definierten Zustand verharren.

Komponente | Details
Mikrocontroller | STM32F446RETx (LQFP64)
Motortreiber | TMC5160T V1.0 (SPI-konfiguriert)
Betriebsmodus | Step/Direction mit PWM-Erzeugung via TIM1
Timer-Takt | 1 MHz (Prescaler=15, HSI 16 MHz)
Homing-Signal | Mechanischer Endschalter an PC10 (LimitSwitch_1)
SPI-Bus | SPI1, Mode 3 (CPOL=1, CPHA=1), 8-Bit MSB

2. Problembeschreibung

2.1 Symptome

Bei der Implementierung der Interrupt-gesteuerten Motorstoppfunktion traten mehrere zusammenhängende Probleme auf:

- Das Netzteil (PSU) schaltete beim Stoppen des Motors in den Constant-Current-Modus (CC).
- Nach dem Stopp zeigte der Motor ein unregelmäßiges Zucken (Twitching).
- Bei betätigtem Endschalter begann der Motor zu rattern und zu schreien (Screaling), ohne sich zu drehen.
- Der SPI-Bus verhielt sich nach dem Interrupt inkonsistent.

2.2 Ursachenanalyse

2.2.1 PSU geht in CC – Haltestrom zu hoch

Der TMC5160T hält den Motor nach dem Stopp unter Strom (Holding Current, IHOLD). Das Register IHOLD_IRUN (0x10) war wie folgt konfiguriert:

TMC_WriteReg(0x10, 0x00061008);

// IHOLD = 0x08 = 8 (ca. 40% des Maximalstroms)

// IRUN = 0x10 = 16

// IHOLDDELAY = 0x06

Ein IHOLD-Wert von 8 ist für das verwendete Netzteil zu hoch, was beim Stoppen sofort zum Überstromschutz (CC-Mode) führte.

2.2.2 SPI-Aufruf im Interrupt-Kontext

Die ursprüngliche Step_Stop()-Funktion enthielt einen SPI-Transfer direkt im ISR-Kontext:

C

static void Step_Stop(void) {

HAL_TIM_PWM_Stop(&htim1, TIM_CHANNEL_1);

TMC_WriteReg(0x10, 0x00061002); // SPI mit HAL_MAX_DELAY im ISR!

}

HAL_SPI_Transmit() mit HAL_MAX_DELAY ist blockierend und darf nicht im Interrupt-Handler aufgerufen werden. Dies führte zur Blockierung des ISR, Korrumpierung des SPI-Zustands und Fehlfunktionen des Motors.

2.2.3 TIM1 Main Output Enable (MOE)

TIM1 und TIM8 sind Advanced Control Timer mit einem Main Output Enable (MOE)-Bit. HAL_TIM_PWM_Stop() alleine deaktiviert den Ausgang nicht vollständig. Das verbleibende MOE-Bit sorgte für Rauschimpulse am STEP-Pin (Twitching).

2.2.4 AutoReloadPreload deaktiviert

Ohne aktiviertes AutoReloadPreload wurden Änderungen am ARR-Register sofort übernommen, was zu unregelmäßigen Pulsbreiten und Geschwindigkeitsschwankungen führte.

2.2.5 Fehlender NVIC-Eintrag für LimitSwitch_6

Für LimitSwitch_6 (PD2 = EXTI2) fehlte der NVIC-Eintrag, weshalb dieser Interrupt nie ausgelöst wurde.

3. Lösung

3.1 Flag-Pattern für ISR-sicheren SPI-Zugriff

Der SPI-Transfer wurde aus dem ISR entfernt. Im Callback wird nur ein Flag gesetzt:

C

volatile uint8_t stop_requested = 0;

void HAL_GPIO_EXTI_Callback(uint16_t GPIO_Pin) {

static uint32_t last = 0;

uint32_t now = HAL_GetTick();

if (now - last < 30) return; // Software-Debounce 30ms

last = now;

if (GPIO_Pin == LimitSwitch_1_Pin) {

HAL_TIM_PWM_Stop(&htim1, TIM_CHANNEL_1);

__HAL_TIM_MOE_DISABLE_UNCONDITIONALLY(&htim1);

stop_requested = 1;

}

}

Im Hauptloop wird das Flag sicher verarbeitet:

C

case STATE_HOMING:

if (stop_requested) {

stop_requested = 0;

TMC_WriteReg(0x10, 0x00061002); // IHOLD=2, sicher hier

currentState = STATE_READY;

}

break;

3.2 MOE-Bit deaktivieren

Durch __HAL_TIM_MOE_DISABLE_UNCONDITIONALLY(&htim1); wird der STEP-Ausgang sofort auf LOW gezogen, was das Twitching verhindert.

3.3 IHOLD-Wert reduzieren

Der Haltestrom wurde auf 2 (ca. 10% des Maximalstroms) reduziert. Dies reicht aus, um die Achse zu halten, ohne das Netzteil zu überlasten.

3.4 NVIC für LimitSwitch_6 ergänzen

Der NVIC-Eintrag und der Handler für EXTI2 wurden hinzugefügt.

4. Pin-Zuordnung der Endschalter

Schalter | MCU-Pin | EXTI Line | IRQ Handler
LimitSwitch_1 | PC10 | EXTI10 | EXTI15_10_IRQn ✔
LimitSwitch_2 | PC11 | EXTI11 | EXTI15_10_IRQn ✔
LimitSwitch_3 | PB12 | EXTI12 | EXTI15_10_IRQn ✔
LimitSwitch_4 | PB13 | EXTI13 | EXTI15_10_IRQn ✔
LimitSwitch_5 | PB14 | EXTI14 | EXTI15_10_IRQn ✔
LimitSwitch_6 | PD2 | EXTI2 | EXTI2_IRQn ✔ (ergänzt)

5. Signalfluss nach Lösung

1. Endschalter schließt (PC10 -> LOW)
2. EXTI15_10_IRQHandler() wird aufgerufen
3. HAL_GPIO_EXTI_Callback()
  - Software-Debounce (30ms)
  - HAL_TIM_PWM_Stop() -> PWM sofort stoppen
  - MOE_DISABLE_UNCONDITIONALLY -> Ausgang auf LOW
  - stop_requested = 1 -> Flag setzen
4. Mainloop (STATE_HOMING)
  - stop_requested erkannt
  - TMC_WriteReg(IHOLD=2) -> SPI-Transfer sicher ausführen
  - currentState = STATE_READY

6. Ergebnis

Problem | Ursache | Lösung
PSU geht in CC | IHOLD zu hoch (=8) | IHOLD auf 2 reduziert
Screaling / kein Drehen | SPI im ISR blockierend | Flag-Pattern, SPI im Mainloop
Twitching nach Stopp | MOE-Bit aktiv | Deaktivierung via Makro
Speed Up/Slow Down | AutoReloadPreload aus | Preload aktiviert
LimitSwitch_6 inaktiv | EXTI2_IRQn fehlte | NVIC + Handler ergänzt

Nach der Implementierung dieser Maßnahmen stoppt der Motor beim Betätigen des Endschalters sauber, das Netzteil bleibt stabil und die Achse wird zuverlässig in Position gehalten.
