EmanuelKaefer/Open-robot-arm/(list of files, drawings)

Other design files:
Electrical/test_board/test_board/freerouting.dsn
Electrical/test_board/test_board/temp-freerouting.dsn
