EmanuelKaefer/Open-robot-arm/Electrical/test_board/test_board/test_board.kicad_pcb

## KiCad design Electrical/test_board/test_board/test_board.kicad_pcb (2026-10-01)

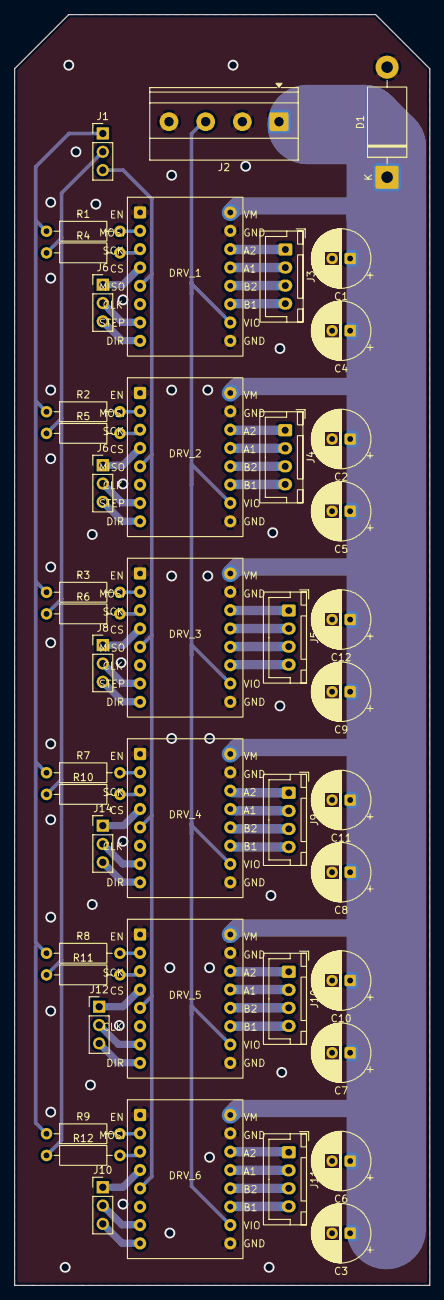
[picture p107: board test_board.kicad_pcb from above]

Board: 2 copper layers, 57.5 x 176.0 mm, 45 parts (0 on the bottom side), 60 nets.

Parts:
C1, C2, C3, C7, C8, C9: 100nF; CP_Radial_D8.0mm_P2.50mm
C4, C5, C6, C10, C11, C12: 100uF; CP_Radial_D8.0mm_P2.50mm
D1: D_TVS; D_DO-201AD_P15.24mm_Horizontal
DRV_1, DRV_2, DRV_3, DRV_4, DRV_5, DRV_6: TMC5160T_V1.0; TMC5160T_Pro_V1.0_Breakout
J1, J6, J6#2, J8, J10, J12, J14: Conn_01x03_Pin; PinHeader_1x03_P2.54mm_Vertical
J2: Screw_Terminal_01x04; TerminalBlock_Phoenix_MKDS-1,5-4-5.08_1x04_P5.08mm_Horizont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
J3, J4, J5, J9, J10#2, J11: Conn_01x04_Socket; JST_XH_B4B-XH-A_1x04_P2.50mm_Vertical
R1, R2, R3, R4, R5, R6, R7, R8, R9, R10, R11, R12: 0Ohm; R_Axial_DIN0207_L6.3mm_D2.5mm_P10.16mm_Horizontal

Connections:
+3.3V: DRV_1.14, DRV_2.14, DRV_3.14, DRV_4.14, DRV_5.14, DRV_6.14, J2.3
+24V: C1.1, C2.1, C3.1, C4.1, C5.1, C6.1, C7.1, C8.1, C9.1, C10.1, C11.1, C12.1, D1.1 (A1), DRV_1.2, DRV_2.2, DRV_3.2, DRV_4.2, DRV_5.2, DRV_6.2, J2.1
GND: C1.2, C2.2, C3.2, C4.2, C5.2, C6.2, C7.2, C8.2, C9.2, C10.2, C11.2, C12.2, D1.2 (A2), DRV_1.1, DRV_1.4, DRV_1.16, DRV_2.1, DRV_2.4, DRV_2.16, DRV_3.1, DRV_3.4, DRV_3.16, DRV_4.1, DRV_4.4, DRV_4.16, DRV_5.1, DRV_5.4, DRV_5.16, DRV_6.1, DRV_6.4, DRV_6.16, J2.2, J2.4
MISO: DRV_1.9, DRV_2.9, DRV_3.9, DRV_4.9, DRV_5.9, DRV_6.9, J1.3
MOSI: J1.1, R1.1, R2.1, R3.1, R7.1, R8.1, R9.1
unnamed: DRV_1.3, R1.2
unnamed: DRV_1.5, R4.2
unnamed: DRV_1.6, J3.1
unnamed: DRV_1.7, J6.1
unnamed: DRV_1.8, J3.2
unnamed: DRV_1.10, J3.3
unnamed: DRV_1.12, J3.4
unnamed: DRV_1.13, J6.2
unnamed: DRV_1.15, J6.3
unnamed: DRV_2.3, R2.2
unnamed: DRV_2.5, R5.2
unnamed: DRV_2.6, J4.1
unnamed: DRV_2.7, J6#2.1
unnamed: DRV_2.8, J4.2
unnamed: DRV_2.10, J4.3
unnamed: DRV_2.12, J4.4
unnamed: DRV_2.13, J6#2.2
unnamed: DRV_2.15, J6#2.3
unnamed: DRV_3.3, R3.2
unnamed: DRV_3.5, R6.2
unnamed: DRV_3.6, J5.1
unnamed: DRV_3.7, J8.1
unnamed: DRV_3.8, J5.2
unnamed: DRV_3.10, J5.3
unnamed: DRV_3.12, J5.4
unnamed: DRV_3.13, J8.2
unnamed: DRV_3.15, J8.3
unnamed: DRV_4.3, R7.2
unnamed: DRV_4.5, R10.2
unnamed: DRV_4.6, J9.1
unnamed: DRV_4.7, J14.1
unnamed: DRV_4.8, J9.2
unnamed: DRV_4.10, J9.3
unnamed: DRV_4.12, J9.4
unnamed: DRV_4.13, J14.2
unnamed: DRV_4.15, J14.3
unnamed: DRV_5.3, R8.2
unnamed: DRV_5.5, R11.2
unnamed: DRV_5.6, J10#2.1
unnamed: DRV_5.7, J12.1
unnamed: DRV_5.8, J10#2.2
unnamed: DRV_5.10, J10#2.3
unnamed: DRV_5.12, J10#2.4
unnamed: DRV_5.13, J12.2
unnamed: DRV_5.15, J12.3
unnamed: DRV_6.3, R9.2
unnamed: DRV_6.5, R12.2
unnamed: DRV_6.6, J11.1
unnamed: DRV_6.7, J10.1
unnamed: DRV_6.8, J11.2
unnamed: DRV_6.10, J11.3
unnamed: DRV_6.12, J11.4
unnamed: DRV_6.13, J10.2
unnamed: DRV_6.15, J10.3
SCK: J1.2, R4.1, R5.1, R6.1, R10.1, R11.1, R12.1
