EmanuelKaefer/Open-robot-arm/Electrical/driver_board/driver_board_v1/driver_board.kicad_pcb

## KiCad design Electrical/driver_board/driver_board_v1/driver_board.kicad_pcb (2025-10-15, an earlier design)

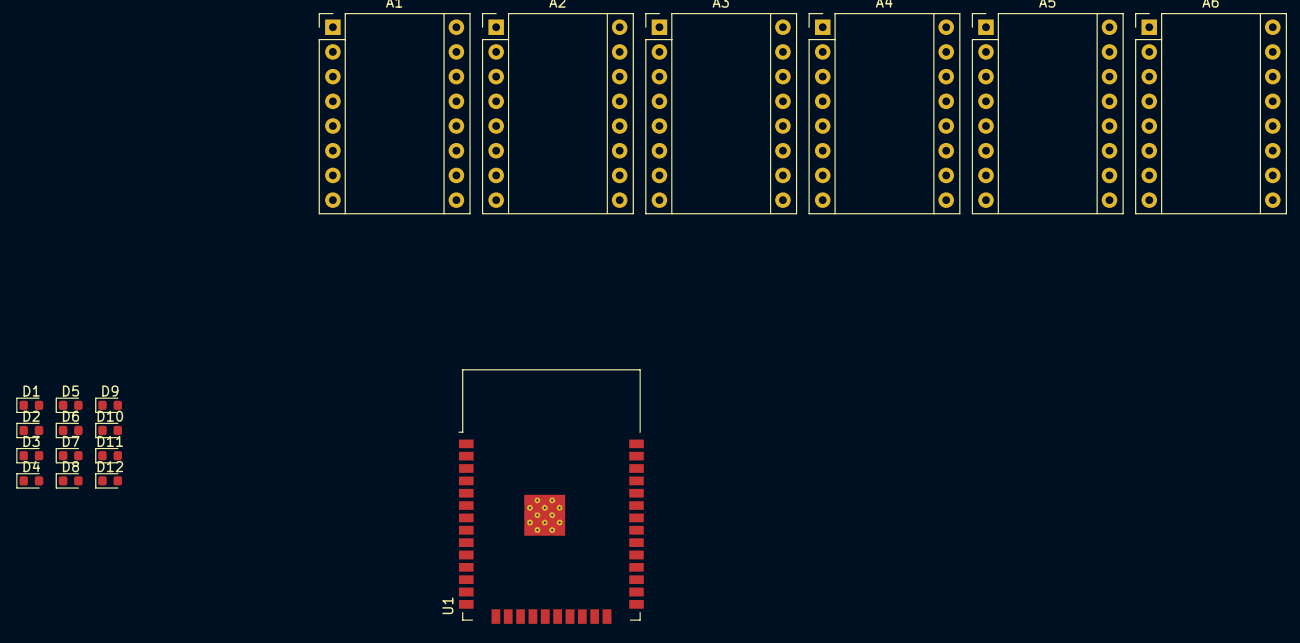
[picture p108: board driver_board.kicad_pcb from above]

Board: 2 copper layers, 19 parts (0 on the bottom side), 26 nets, no tracks yet.

Parts:
A1, A2, A3, A4, A5, A6: Pololu_Breakout_A4988; Pololu_Breakout-16_15.2x20.3mm
D1, D2, D3, D4, D5, D6, D7, D8, D9, D10, D11, D12: LED; LED_0603_1608Metric
U1: ESP32-WROOM-32

Connections:
GND: A1.9 (~ENABLE), A2.9 (~ENABLE), A3.9 (~ENABLE), A4.9 (~ENABLE), A5.9 (~ENABLE), A6.9 (~ENABLE)
IO2: A6.13 (~RESET), U1.24 (IO2)
IO4: A5.13 (~RESET), U1.26 (IO4)
IO5: A4.13 (~RESET), U1.29 (IO5)
IO12: A3.13 (~RESET), U1.14 (IO12)
IO13: A2.13 (~RESET), U1.16 (IO13)
IO14: A1.13 (~RESET), U1.13 (IO14)
IO33: A1.10 (MS1), A2.10 (MS1), A3.10 (MS1), A4.10 (MS1), A5.10 (MS1), A6.10 (MS1)
IO34: A1.11 (MS2), A2.11 (MS2), A3.11 (MS2), A4.11 (MS2), A5.11 (MS2), A6.11 (MS2)
IO35: A1.12 (MS3), A2.12 (MS3), A3.12 (MS3), A4.12 (MS3), A5.12 (MS3), A6.12 (MS3)
NC: U1.3 (EN), U1.4 (SENSOR_VP), U1.5 (SENSOR_VN), U1.17 (SHD/SD2), U1.18 (SWP/SD3), U1.19 (SCS/CMD), U1.20 (SCK/CLK), U1.21 (SDO/SD0), U1.22 (SDI/SD1), U1.25 (IO0)
unnamed: A1.16 (DIR), D2.1 (K)
unnamed: A1.15 (STEP), D1.1 (K)
unnamed: A1.2 (VDD), A1.14 (~SLEEP), A2.2 (VDD), A2.14 (~SLEEP), A3.2 (VDD), A3.14 (~SLEEP), A4.2 (VDD), A4.14 (~SLEEP), A5.2 (VDD), A5.14 (~SLEEP), A6.2 (VDD), A6.14 (~SLEEP), U1.2 (VDD)
unnamed: A1.8 (VMOT), A2.8 (VMOT), A3.8 (VMOT), A4.8 (VMOT), A5.8 (VMOT), A6.8 (VMOT)
unnamed: A2.16 (DIR), D8.1 (K)
unnamed: A2.15 (STEP), D7.1 (K)
unnamed: A3.16 (DIR), D4.1 (K)
unnamed: A3.15 (STEP), D3.1 (K)
unnamed: A4.16 (DIR), D10.1 (K)
unnamed: A4.15 (STEP), D9.1 (K)
unnamed: A5.16 (DIR), D6.1 (K)
unnamed: A5.15 (STEP), D5.1 (K)
unnamed: A6.16 (DIR), D12.1 (K)
unnamed: A6.15 (STEP), D11.1 (K)
unnamed: A1.1 (GND), A1.7 (GND), A2.1 (GND), A2.7 (GND), A3.1 (GND), A3.7 (GND), A4.1 (GND), A4.7 (GND), A5.1 (GND), A5.7 (GND), A6.1 (GND), A6.7 (GND), U1.1 (GND), U1.15 (GND), U1.38 (GND), U1.39 (GND)
