EmanuelKaefer/Open-robot-arm/Software/driver_board_software/driver_board_software.ioc

Mcu.UserName=STM32F446RETx
PA0-WKUP.GPIO_Label=TMC2_STEP
PA0-WKUP.Signal=S_TIM2_CH1_ETR
PA1.GPIO_Label=TMC4_CS
PA1.Signal=GPIO_Output
PA10.GPIO_Label=TMC4_DIR
PA10.Signal=GPIO_Output
PA2.Signal=USART2_TX
PA3.Signal=USART2_RX
PA8.GPIO_Label=TMC1_STEP
PA8.Signal=S_TIM1_CH1
PA9.GPIO_Label=TMC5_DIR
PA9.Signal=GPIO_Output
PB0.GPIO_Label=TMC6_CS
PB0.Signal=GPIO_Output
PB10.Signal=USART3_TX
PB13.Signal=SPI2_SCK
PB14.Signal=SPI2_MISO
PB15.Signal=SPI2_MOSI
PB2.GPIO_Label=TMC1_DIR
PB2.Signal=GPIO_Output
PB4.GPIO_Label=TMC3_STEP
PB4.Signal=S_TIM3_CH1
PB6.GPIO_Label=TMC4_STEP
PB6.Signal=S_TIM4_CH1
PB8.GPIO_Label=TMC6_STEP
PB8.Signal=S_TIM10_CH1
PC0.GPIO_Label=TMC1_CS
PC0.Signal=GPIO_Output
PC1.GPIO_Label=TMC2_CS
PC1.Signal=GPIO_Output
PC2.GPIO_Label=TMC3_CS
PC2.Signal=GPIO_Output
PC4.GPIO_Label=TMC5_CS
PC4.Signal=GPIO_Output
PC5.Signal=USART3_RX
PC6.GPIO_Label=TMC5_STEP
PC6.Signal=S_TIM8_CH1
PC7.GPIO_Label=TMC2_DIR
PC7.Signal=GPIO_Output
PC8.GPIO_Label=TMC3_DIR
PC8.Signal=GPIO_Output
PC9.GPIO_Label=TMC6_DIR
PC9.Signal=GPIO_Output
PH0-OSC_IN.Signal=RCC_OSC_IN
PH1-OSC_OUT.Signal=RCC_OSC_OUT
