EmanuelKaefer/Open-robot-arm/Electrical/driver_board/driver_board_v2/Firmware/driver_board_software/Core/Src/main.c

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
/* Includes ------------------------------------------------------------------*/
#include "main.h"

/* USER CODE BEGIN Includes */
#include <stdio.h>
/* USER CODE END Includes */

SPI_HandleTypeDef hspi2;

TIM_HandleTypeDef htim1;
TIM_HandleTypeDef htim2;
TIM_HandleTypeDef htim3;
TIM_HandleTypeDef htim4;
TIM_HandleTypeDef htim5;
TIM_HandleTypeDef htim8;
TIM_HandleTypeDef htim10;

UART_HandleTypeDef huart2;
UART_HandleTypeDef huart3;

/* USER CODE BEGIN PV */

// Arrays for counting steps for all 6 axes


#define axis 2

#define PI 3.14159265359f //PI
#define MOTOR_STEPS 200.0f //steps/revolution
#define MICROSTEPS 16.0f //defined microsteps
#define GEAR_RATIO 20.0f //gear ratio for every axis

/* USER CODE END PV */

void SystemClock_Config(void);
static void MX_GPIO_Init(void);
static void MX_USART2_UART_Init(void);
static void MX_TIM1_Init(void);
static void MX_USART3_UART_Init(void);
static void MX_TIM2_Init(void);
static void MX_TIM3_Init(void);
static void MX_TIM4_Init(void);
static void MX_TIM5_Init(void);
static void MX_TIM8_Init(void);
static void MX_TIM10_Init(void);
static void MX_SPI2_Init(void);
/* USER CODE BEGIN PFP */
// Deklaration der TMC Funktion, falls nicht über Header verfügbar
//extern void TMC_WriteReg(uint8_t addr, uint32_t value);
//extern uint32_t TMC_ReadReg(uint8_t addr);
/* USER CODE END PFP */

/* USER CODE BEGIN 0 */

// Arrays für die Hardware-Timer
TIM_HandleTypeDef* AXIS_TIMERS[6] = {&htim1, &htim2, &htim3, &htim4, &htim8, &htim10};
uint32_t AXIS_CHANNELS[6] = {TIM_CHANNEL_1, TIM_CHANNEL_1, TIM_CHANNEL_1, TIM_CHANNEL_1, TIM_CHANNEL_1, TIM_CHANNEL_1};

// Homeangles from urdf base und 1 sind vertauscht wegen ding was nicht wolen lösen ich jetzt, müsste trotzdem funktionieren(auch in IQR ganz am ende sehen)
//-0.3470f
//float home_rad[6]={ 0.0f, 0.0f, 0.0f, 0.0f, 0.0f, 0.0f};//eig 0.0171f, 0.3500f, 0.3363f, -1.0126f, -0.0202f, 2.1291f aber stimmt nicht deshalb herausgemessen
//Limitangles from solidworks
//float limit_rad[6]={ 0.0171f, 1.3150f, 1.6177f, -1.0126f, 1.6481f, 2.1291f}; //0.0171f, 1.7615f, 1.6177f, -1.0126f, 1.6481f, 2.1291f

//array for homing pins
GPIO_TypeDef* DIR_PORTS[6] = {TMC1_DIR_GPIO_Port, TMC2_DIR_GPIO_Port,  TMC3_DIR_GPIO_Port, TMC4_DIR_GPIO_Port, TMC5_DIR_GPIO_Port, TMC6_DIR_GPIO_Port};
uint16_t DIR_PINS[6]  = {TMC1_DIR_Pin, TMC2_DIR_Pin,  TMC3_DIR_Pin, TMC4_DIR_Pin, TMC5_DIR_Pin, TMC6_DIR_Pin};

// Status-Variables
uint8_t ax = 0; // 0 = Base, 1 = Achse 1, ..., 5 = Achse 5

float target_steps[] ={50000.0f, 50000.0f, 0.0f,0.0f,0.0f,0.0f};

volatile uint32_t debug_counter = 0;

volatile uint32_t move_start_time = 0;
volatile uint32_t axis_finish_time[6] = {0};
volatile uint8_t print_results_flag = 0;

//registers for TMC
#define GSTAT 0x01
#define GCONF 0x00
#define IOIN 0x04
#define IHOLDIRUN 0x10	//write only, returns 0x0 when read
#define CHOPCONF 0X6C

// Constants for state machine
typedef enum {
    STATE_INIT,
    STATE_HOMING,
    STATE_HOMING_OFFSET,
    STATE_READY,
	STATE_MOVING,
    STATE_ERROR
} SystemState;

SystemState currentState = STATE_INIT;

//variables for ramp profile
typedef struct {
	float    current_freq;   // Hz, aktuelle Schrittfrequenz
	float    vmax;           // Hz, Zielgeschwindigkeit dieser Achse für diesen Move
	float    accel;          // Hz pro Sekunde
    float    pos;             // Schritte, als float für Sub-Schritt-Genauigkeit in der Integration
    float    target;          // Schritte, Ziel
    uint8_t  direction;
    uint8_t  active;
} AxisRamp;

AxisRamp axisRamp[6];
//war exacte fahrt von Limitswitch zu 0 position

//Stop/Start
static void Step_Start(uint8_t ax)
{

    HAL_TIM_PWM_Start(AXIS_TIMERS[ax], AXIS_CHANNELS[ax]);

    // MOE force enable only Advanced Timern
    TIM_HandleTypeDef* htim = AXIS_TIMERS[ax];
    if (htim->Instance == TIM1 || htim->Instance == TIM8) {
    	__HAL_TIM_MOE_ENABLE(htim);
    }
}

static void Step_Stop(uint8_t ax)
{
    TIM_HandleTypeDef* htim = AXIS_TIMERS[ax];
    HAL_TIM_PWM_Stop(htim, AXIS_CHANNELS[ax]);
    HAL_TIM_Base_Stop_IT(htim);

    // MOE force disable only Advanced Timern
    if (htim->Instance == TIM1 || htim->Instance == TIM8) {
        __HAL_TIM_MOE_DISABLE_UNCONDITIONALLY(htim);
    }
}

//set frequenzy
static void Step_SetFreqHz(uint8_t ax, uint32_t freq_hz)
{
    TIM_HandleTypeDef* htim = AXIS_TIMERS[ax];
    uint32_t channel = AXIS_CHANNELS[ax];

    if (freq_hz == 0) {
        __HAL_TIM_SET_COMPARE(htim, channel, 0); // keine Pulse
        return;
    }

    const uint32_t timer_tick_hz = 1000000; // 1 MHz bei Prescaler=15 und 16MHz clock
    uint32_t arr = (timer_tick_hz / freq_hz) - 1;

    if (arr < 2) arr = 2;
    if (arr > 0xFFFF) arr = 0xFFFF;

    htim->Instance->CR1 |= TIM_CR1_ARPE;

    __HAL_TIM_SET_AUTORELOAD(htim, arr);
    __HAL_TIM_SET_COMPARE(htim, channel, (arr + 1) / 2); // 50% duty
}

//Ramps
void UpdateAllRamps(float dt, uint8_t min_freq)
{
	//debug_counter ++;
    for (uint8_t ax = 0; ax < axis; ax++) {
        if (!axisRamp[ax].active) continue;

        float remaining = axisRamp[ax].target - axisRamp[ax].pos;
        float dir_sign = (remaining >= 0) ? 1.0f : -1.0f;
        float remaining_abs = fabsf(remaining);

        // calculate breaking distance
        float decel_dist = (axisRamp[ax].current_freq * axisRamp[ax].current_freq)
                            / (2.0f * axisRamp[ax].accel);

        //calculating if decceleration or acceleration is needed
        if (remaining_abs <= decel_dist) {
            axisRamp[ax].current_freq -= axisRamp[ax].accel * dt;
        } else if (axisRamp[ax].current_freq < axisRamp[ax].vmax) {
            axisRamp[ax].current_freq += axisRamp[ax].accel * dt;
        }

        if (axisRamp[ax].current_freq < min_freq){
        	axisRamp[ax].current_freq = min_freq;
        }
        if (axisRamp[ax].current_freq > axisRamp[ax].vmax){
        	axisRamp[ax].current_freq = axisRamp[ax].vmax;
        }

        // Position update
        axisRamp[ax].pos += dir_sign * axisRamp[ax].current_freq * dt;

        //target reached
        if (remaining_abs < 1.0f) {
            Step_Stop(ax);
            axisRamp[ax].active = 0;
            axis_finish_time[ax] = HAL_GetTick() - move_start_time;

            continue;
        }
        //set a new frequency everytime for every axis
        Step_SetFreqHz(ax, (uint32_t)axisRamp[ax].current_freq);
    }
}

void StartMove(uint8_t ax, float target_steps, float vmax, float accel)
{

	printf("IN STARTMOVE\r\n");
    axisRamp[ax].pos = 0.0f;
    axisRamp[ax].target = target_steps;
    axisRamp[ax].vmax = vmax;
    axisRamp[ax].accel = accel;
    axisRamp[ax].current_freq = 50.0f;
    axisRamp[ax].active = 1;

    HAL_GPIO_WritePin(DIR_PORTS[ax], DIR_PINS[ax], target_steps>0 ? GPIO_PIN_SET : GPIO_PIN_RESET);

    Step_Start(ax);

}

// Berechnet vmax für eine Achse, damit sie in genau t Sekunden fertig ist
// bei fester Beschleunigung a und Distanz d
float ComputeSyncedVmax(float d, float a, float t)
{
    float disc = (a*t)*(a*t) - 4.0f*a*d;
    if (disc < 0.0f) disc = 0.0f;
    return (a*t - sqrtf(disc)) / 2.0f;
}

void StartSyncedMove(float target_steps[6], float accel, float vmax_max, uint8_t axis_count)
{
    float t_sync = 0.0f;

    // Calculating the time every axis would need for the distance if it would go to vmax.
    for (uint8_t i = 0; i < axis_count; i++) {
        float d = fabsf(target_steps[i]);
        if (d == 0.0f) continue;
        float t_i = (2.0f*vmax_max <= sqrtf(4*d*accel)) ? (d/vmax_max + vmax_max/accel) : (2.0f*sqrtf(d/accel)); //Trapez oder Dreieck ? Trapezformel : Dreiecksformel
        if (t_i > t_sync){
        	t_sync = t_i;	//es wird nach der längsten dauer gesucht und diese wird in t_synch gespeichert
        }
    }

    //Messvariablen zurücksetzen
        for(uint8_t i = 0; i < 6; i++) {
            axis_finish_time[i] = 0;
        }
        print_results_flag = 0;

        // 2. Startzeit merken (genau bevor die ersten Steps generiert werden)
        move_start_time = HAL_GetTick();

    //Für jede Achse vmax neu berechnen, damit alle bei t_sync fertig sind
    for (uint8_t i = 0; i < axis_count; i++) {
        float d = fabsf(target_steps[i]);
        float v = ComputeSyncedVmax(d, accel, t_sync);
        StartMove(i, target_steps[i], v, accel);
    }
}


/* USER CODE END 0 */

/**
  * @brief  The application entry point.
  * @retval int
  */
int main(void)
{

  /* MCU Configuration--------------------------------------------------------*/

  /* Reset of all peripherals, Initializes the Flash interface and the Systick. */
  HAL_Init();

  /* Configure the system clock */
  SystemClock_Config();

  /* Initialize all configured peripherals */
  MX_GPIO_Init();
  MX_USART2_UART_Init();
  MX_TIM1_Init();
  MX_USART3_UART_Init();
  MX_TIM2_Init();
  MX_TIM3_Init();
  MX_TIM4_Init();
  MX_TIM5_Init();
  MX_TIM8_Init();
  MX_TIM10_Init();
  MX_SPI2_Init();
  /* USER CODE BEGIN 2 */

  //start TIM5 in interrupt mode
  HAL_TIM_Base_Start_IT(&htim5);	//goofy ahh das ma des selber mochn muas lowk so 3std debugen bis i do draufkemma bi
  /* USER CODE END 2 */

  /* Infinite loop */
  /* USER CODE BEGIN WHILE */
  while (1)
  {
    /* USER CODE END WHILE */

    /* USER CODE BEGIN 3 */
    switch (currentState)
    {
      case STATE_INIT:
        HAL_Delay(500); //Boot-Delay für die TMC Treiber!
        printf("\r\n--- Starte TMC5160 Initialisierung ---\r\n");
        uint8_t all_ok = 1;
        for (uint8_t ax = 0; ax < axis; ax++) {
			printf("axis %d\r\n", ax );
        	TMC_WriteReg(ax, GSTAT, 0x00000007);
        	printf("GSTAT of %d: 0x%08lx\r\n",ax, TMC_ReadReg(ax, GSTAT));

        	TMC_WriteReg(ax, GCONF, 0x00000005);
        	printf("GCONF of %d: 0x%08lx\r\n",ax, TMC_ReadReg(ax, GCONF));

        	TMC_WriteReg(ax, IHOLDIRUN, 0x0008100A);

        	TMC_WriteReg(ax, CHOPCONF, 0x100C0403);
        	printf("CHOPCONF of %d: 0x%08lx\r\n",ax, TMC_ReadReg(ax, CHOPCONF));

        	if (TMC_ReadReg(ax, GSTAT)==0x0) {
        		printf("GSTAT of %d ok, going into ready\r\n",ax);

        	}else {
        		printf("GSTAT of %d not ok:((  : 0x%08lx\r\n",ax, TMC_ReadReg(ax, GSTAT));
        		all_ok=0;
        	}
        }

        currentState = all_ok ? STATE_READY : STATE_ERROR;

        break;

      case STATE_HOMING:
          //uint8_t started = 0;
          //uint8_t ax = current_homingaxis;


          break;

      case STATE_HOMING_OFFSET:
    	  if (print_results_flag == 0) {

    	          uint8_t all_finished = 1;
    	          for(uint8_t i = 0; i < axis; i++) {
    	              // Wenn eine Achse losfahren sollte, aber ihr active-Flag noch 1 ist
    	              if (axisRamp[i].active == 1) {
    	                  all_finished = 0;
    	                  break; // Nicht alle fertig, Prüfung abbrechen
    	              }
    	          }

    	          // Wenn alle Achsen fertig sind -> Ergebnisse ausdrucken!
    	          if (all_finished == 1) {
    	              printf("\n--- Synchronisations-Test ---\n");
    	              for(uint8_t i = 0; i < axis; i++) {
    	                  if (target_steps[i] != 0.0f) { // Nur bewegte Achsen anzeigen
    	                      printf("Achse %d: %lu ms\n", i, axis_finish_time[i]);
    	                  }
    	              }
    	              printf("-----------------------------\n");

    	              // Flag setzen, damit wir nicht endlos spammen
    	              print_results_flag = 1;

    	          }
    	          //currentState=STATE_HOMING;
    	      }
          break;

      case STATE_READY:

    	  StartSyncedMove(target_steps, 5000, 20000, axis);

    	  currentState=STATE_MOVING;
          break;

      case STATE_MOVING:
    	  printf("MOVING\r\n");

    	  currentState=STATE_HOMING_OFFSET;
	  	  break;
      case STATE_ERROR:
    	  printf("BAD");
    	  currentState=STATE_HOMING_OFFSET;
          break;

    }
  }
  /* USER CODE END 3 */
}

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
/* USER CODE BEGIN 4 */

// Callback für Timer Interrupts aller Achsen (zählt Schritte)
void HAL_TIM_PeriodElapsedCallback(TIM_HandleTypeDef *htim)
{
        if (htim->Instance == TIM5) {
        	UpdateAllRamps(0.001f, 50);
    }
}

// EXTI15_10 callback for homing switches
void HAL_GPIO_EXTI_Callback(uint16_t GPIO_Pin)
{

}


int _write(int file, char *ptr, int len) {
    HAL_UART_Transmit(&huart2, (uint8_t*)ptr, len, HAL_MAX_DELAY);
    return len;
}
/* USER CODE END 4 */
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
