EmanuelKaefer/Open-robot-arm/Electrical/driver_board/driver_board_v2/Firmware/driver_board_software/Core/Src/SPIconfig.c

/*
 * SPIconfig.c
 *
 *  Created on: 27.04.2026
 *      Author: matteo gassler
 *      LICENCED under the GNU GENERAL PUBLIC LICENSE
 */
/*
 * SPDX-License-Identifier: GPL-3.0-or-later
 * Copyright (c) 2026 Emanuel Käfer, Matteo Gassler, and Alexander Dick and contributors
 * This program is free software: you can redistribute it and/or modify
 * it under the terms of the GNU General Public License as published by
 * the Free Software Foundation, either version 3 of the License, or
 * (at your option) any later version.
 * This program is distributed WITHOUT ANY EXPRESS OR IMPLIED WARRANTY.
 * See LICENSE-SOFTWARE in the project root for details.
 */

#include "SPIconfig.h"
// Array für die Chip Select (CS) Pins der SPI-Kommunikation
// (Index 0 = TMC2, Index 1 = TMC1, wie bei den DIR Pins gewünscht)
GPIO_TypeDef* CS_PORTS[6] = {TMC1_CS_GPIO_Port, TMC2_CS_GPIO_Port, TMC3_CS_GPIO_Port, TMC4_CS_GPIO_Port, TMC5_CS_GPIO_Port, TMC6_CS_GPIO_Port};
uint16_t      CS_PINS[6]  = {TMC1_CS_Pin, TMC2_CS_Pin, TMC3_CS_Pin, TMC4_CS_Pin, TMC5_CS_Pin, TMC6_CS_Pin};

extern SPI_HandleTypeDef hspi2;


// --- SPI Write Funktion ---
void TMC_WriteReg(uint8_t ax, uint8_t addr, uint32_t value) {
    uint8_t data[5];
    data[0] = addr | 0x80; // MSB auf 1 setzen für Write
    data[1] = (value >> 24) & 0xFF;
    data[2] = (value >> 16) & 0xFF;
    data[3] = (value >> 8)  & 0xFF;
    data[4] = value & 0xFF;

    // CS LOW, Senden, CS HIGH (Dynamisch über Arrays!)
    HAL_GPIO_WritePin(CS_PORTS[ax], CS_PINS[ax], GPIO_PIN_RESET);
    HAL_SPI_Transmit(&hspi2, data, 5, HAL_MAX_DELAY);
    HAL_GPIO_WritePin(CS_PORTS[ax], CS_PINS[ax], GPIO_PIN_SET);
}

// --- SPI Read Funktion ---
uint32_t TMC_ReadReg(uint8_t ax, uint8_t addr) {
    uint8_t tx_data[5] = {addr & 0x7F, 0, 0, 0, 0}; // MSB auf 0 für Read
    uint8_t rx_data[5] = {0};

    // 1. Transfer: Dem TMC5160 sagen, welches Register wir wollen
    HAL_GPIO_WritePin(CS_PORTS[ax], CS_PINS[ax], GPIO_PIN_RESET);
    HAL_SPI_Transmit(&hspi2, tx_data, 5, HAL_MAX_DELAY);
    HAL_GPIO_WritePin(CS_PORTS[ax], CS_PINS[ax], GPIO_PIN_SET);

    // 2. Transfer: Die eigentlichen Daten abholen
    HAL_GPIO_WritePin(CS_PORTS[ax], CS_PINS[ax], GPIO_PIN_RESET);
    HAL_SPI_TransmitReceive(&hspi2, tx_data, rx_data, 5, HAL_MAX_DELAY);
    HAL_GPIO_WritePin(CS_PORTS[ax], CS_PINS[ax], GPIO_PIN_SET);

    // Bytes zusammenbauen (rx_data[0] ist die Dummy-Antwort der Adresse)
    return ((uint32_t)rx_data[1] << 24) | ((uint32_t)rx_data[2] << 16) |
           ((uint32_t)rx_data[3] << 8)  | rx_data[4];
}
