EmanuelKaefer/Open-robot-arm/(commit log)

2025-10-10 Mechanical parts prototype
    Prototype for the Arm
    [Grundgerüst_Achsen_V1.SLDASM, Mittelarm_V1.SLDPRT, Oberarm_V1.SLDPRT, Unterste_Achse_V1.SLDPRT]
2025-10-11 V2 Prototype
    [Hüsei_unten.3MF, Hüsei_unten.SLDPRT, Prototyp_Grundgerüst_V2.SLDPRT.SLDASM, Prototyp_Mittelarm_V2.3MF, Prototyp_Mittelarm_V2.SLDPRT, Prototyp_Oberarm_Mount_V2.3MF, Prototyp_Oberarm_Mount_V2.SLDPRT, Prototyp_Oberarm_V2.3MF]
2025-10-12 KiCad project and README for motor driver board
    [driver_board.kicad_pcb, driver_board.kicad_sch]
2025-10-12 Initial software skeleton and README for robot arm control
2025-10-12 Smaller clearance
    [w_619_9-2z.3MF]
2025-10-12 added parts
    [Grundgerüst_Achsen_V1.SLDASM, Mittelarm_V1.SLDPRT, Oberarm_V1.SLDPRT, Unterste_Achse_V1.SLDPRT, skf_bearing_51105_2.SLDASM, skf_bearing_51105_2_01.SLDPRT, skf_bearing_51105_2_02.SLDPRT, skf_bearing_51105_2_03.SLDPRT]
2025-10-13 First schematic for driver board v1
    + folder hierarchy change
    [driver_board.kicad_pcb, driver_board.kicad_sch]
2025-10-13 V3 1st joint spun by nema 17
    Base motor added spins 1st joint
    [Base_V3.SLDPRT, Main_V3.SLDPRT, Main_V3_2.SLDPRT, Nima 17 40x42x5mm.SLDPRT, Nima 17 40x42x5mm.STEP, Robo_V3.SLDASM]
2025-10-14 Driver_Board schematic changes
    Added smoothing capacitors
    [driver_board.kicad_sch]
2025-10-14 Update to driver board v1
2025-10-14 Updated driver board v1
    New dip switch allignment and assigned first footprints
    [driver_board.kicad_pcb, driver_board.kicad_sch]
2025-10-15 V3 new design
    [Base mo.SLDASM, Base_V3.SLDPRT, Base_g_V3.SLDASM, Base_g_V3.SLDPRT, Base_shoulder.SLDASM, Main_V3.SLDPRT, Main_V3_2.SLDPRT, Motor_halter_m.SLDASM]
2025-10-15 V3_3 Forearm assembly added
    [61904.SLDASM, 61904_01.SLDPRT, 61904_02.SLDPRT, 61904_03.SLDPRT, Flange, Coupling 10mm v3.step, Forearm.SLDASM, Motor_ccoupling_8mm_V3_3.SLDPRT, Oberarm_om.SLDPRT]
2025-10-17 Gearing added
    [6007.SLDASM, 6007_01.SLDPRT, 6007_02.SLDPRT, 6007_03.SLDPRT, 635.SLDASM, 635_01.SLDPRT, 635_02.SLDPRT, 635_03.SLDPRT]
2025-10-19 Cover added to oberarm
    [61805.SLDASM, 61805_01.SLDPRT, 61805_02.SLDPRT, 61805_03.SLDPRT, Base_shoulder_forearm.SLDASM, Cabelhousing_Oberarm.SLDPRT, Forearm_2.SLDASM, Forearm_2.SLDPRT]
2025-10-19 small tweaks
    [Base_shoulder_forearm.SLDASM, Oberarm_om.3MF, Oberarm_om.SLDPRT, oberarm_cover.SLDPRT]
2025-10-20 smaller design changes
    added limit switches and tweaked the upperarm
    [Base_shoulder_forearm.SLDASM, Cabelhousing_Oberarm.SLDPRT, Forearm_2.SLDASM, Lim_1.SLDPRT, Lim_3.SLDPRT, Lim_5.SLDPRT, Lim_6.SLDPRT, Motor_halter_m.SLDASM]
2025-11-05 small changes
    some changes were made
    [6007.3mf, 6007.SLDASM, 6007_01.SLDPRT, 6007_02.SLDPRT, 6007_03.SLDPRT, 61805.3mf, 61904.3mf, 635.3mf]
2025-11-05 fore arm steuerrung mit homing funktion
2025-11-05 manual reset
    reset per vor und zurück
    [arm_steuerung_mit_limits.ino]
2025-11-06 Design changes
    [Base_shoulder_forearm.SLDASM, Forearm_wrist_turn.SLDPRT, Lim_1.SLDPRT, Oberarm_gear_unten_spacer.SLDPRT, Oberarm_gear_unten_spacer.STEP, SW_LIMITE.SLDASM, main_joint.SLDPRT, main_joint.STEP]
2025-11-06 new code + small design changes
    new code for oberarm + fore-oberarm together and small design tweaks
    [Oberarm_gear_unten_spacer.SLDPRT, Oberarm_gear_unten_spacer.STEP, oberarm_achse.STEP]
2025-11-07 Base plate and gears added
    [61810.SLDASM, 61810_01.SLDPRT, 61810_02.SLDPRT, 61810_03.SLDPRT, Cabelhousing_Oberarm.SLDPRT, First_.SLDPRT, Mai.SLDPRT, Oberarm_gear_oben.3mf]
2025-11-10 added new gears
    [51110_balls.3MF, 51110_balls.STEP, 51110_bottom.3MF, 51110_bottom.STEP, 51110_top.3MF, 51110_top.STEP, 6007_V2.stl, 61810.SLDASM]
2025-11-11 Minimal ciruit for the STM32F446RET6
    [driver_board.kicad_pcb, driver_board.kicad_sch, untitled.kicad_sch]
2025-11-12 Updates to MCU
    [untitled.kicad_sch]
2025-11-13 New urdf + mesh
    [Base_shoulder_forearm_comined.urdf, Link_1_colision.STL, Link_2_colision.STL, Link_3_colision.STL, Link_4_colision.STL, base_link_colision.STL]
2025-11-13 Update to mcu
    [untitled.kicad_sch]
2025-11-13 ros2 first prototype
    [Base_shoulder_forearm_comined.csv, Base_shoulder_forearm_comined.urdf, Link_1.STL, Link_1_colision.STL, Link_2.STL, Link_2_colision.STL, Link_3.STL, Link_3_colision.STL]
2025-11-13 small tweaks in the urdf
    [Base_shoulder_forearm_comined.urdf]
2025-11-19 changes to make rivz worh
    Changes in the urdf and meshes to make rivz show the current arm Version
    [Base_shoulder_forearm_comined.csv, Base_shoulder_forearm_comined.urdf, Link_1.STL, Link_1_colision.STL, Link_2.STL, Link_2_colision.STL, Link_3.STL, Link_3_colision.STL]
2025-11-23 V4 Robotarm design added
    [Forearm.SLDPRT, Forearm2.SLDPRT, Forearm2_cover.SLDPRT, Forearm2_cover2.SLDPRT, Limit Switch.SLDPRT, Nema_17_Planetary_Gearbox.SLDPRT, Nima 17 40x42x5mm.SLDPRT, cabelcover.SLDPRT]
2025-11-24 Updates to driver board
    [driver_board.kicad_sch, microcontroller.kicad_sch, power-supply.kicad_sch]
2025-11-24 mostly finished V4 arm
    [17HE08-1004S.STEP, Collision_shoulder.SLDPRT, MG17-G10.SLDASM, MG17-G10.SLDPRT, MG17-G10.STEP, Nema17_42x42x23.SLDPRT, collision_forearm.SLDPRT, collision_upperarm.SLDPRT]
2025-11-25 urdf + collisions added
    [forearm_link.STL, robot_arm.SLDASM.csv, robot_arm.SLDASM.urdf, robot_arm_collision.SLDASM, robot_arm_collision.SLDASM.csv, robot_arm_collision.SLDASM.urdf, shoulder_link.STL, upperarm_link.STL]
2025-11-25 name changes
    [forearm_link_collison.STL, shoulder_link_collision.STL, upperarm_link_collision.STL, wrist_tilt_link_collision.STL, wrist_turn_link_collision.STL]
2025-11-26 3mfs of V4 added
    [Forearm2.3MF, Forearm2_axle.3MF, Forearm2_cover.3MF, Forearm2_cover2.3MF, base_axle.3MF, base_bambu.3mf, base_main.3MF, cabelcover.3MF]
2025-12-01 change of file structure
    [Base_shoulder_forearm_comined.csv, Base_shoulder_forearm_comined.urdf, Link_1.STL, Link_1_colision.STL, Link_2.STL, Link_2_colision.STL, Link_3.STL, Link_3_colision.STL]
2025-12-02 gripper v1 and v2 added
    [DS3225MG 25KG.STEP, DS3225MG.SLDPRT, Forearm2.3MF, Forearm2_cover.SLDPRT, base_axle.SLDPRT, base_collision.SLDPRT, base_mainSLDPRT.SLDPRT, forearm_link.STL]
2025-12-02 gripper added to robotarm
    [collision_wrist_second.SLDPRT]
2025-12-04 Full gripper, universal gripper and urdf added
    Full gripper, universal gripper and urdf for self made gripper added
    [Collision_shoulder.STL, base_collision.STL, base_link.STL, collision_forearm.STL, collision_upperarm.STL, collision_wrist_main.STL, collision_wrist_second.SLDPRT, collision_wrist_second.STL]
2025-12-04 removed old files
    [forearm_bambu.3mf, forearm_link.STL, forearm_link_collison.STL, robot_arm.SLDASM.csv, robot_arm.SLDASM.urdf, robot_arm_collision.SLDASM.csv, robot_arm_collision.SLDASM.urdf, shoulder_link.STL]
2026-02-02 initial commit
    adds urdf, csv, meshes and a simple Matlab script which displays the robot
2026-02-02 Update MATLAB live script show_robot.mlx
    Update the show_robot.mlx MATLAB live script used for the robot arm visualization. It now displays a few important parameters of the robot
2026-02-04 very simple algorithm ik and first simulink try
    A very simple Matbal inverse kinematics algorithm and a first simulink programm which only displays the robot
2026-02-05 Update to circuit
2026-02-05 Added pin definition
2026-02-16 first try in adding pick-and-place motion planning with IK and trajectory generation
    feat: first try in adding pick-and-place motion planning with IK and trajectory generation
    - Connect Transform Trajectory to Inverse Kinematics block
    - Add Simulink-PS Converter input filtering (order 2) for smooth joint motion
    - Add Unit Delay feedback for IK initial guess continuity
    - Add model InitFcn callback to auto-load robot model
2026-02-17 add pick-and-place trajectory planning with multi-waypoint support
    Add Trapezoidal Velocity Profile Trajectory block for smooth
    multi-waypoint path generation (replaces chained Transform Trajectory)
    Tested with 4 waypoints for pick-lift-move-place cycle
    Without any gripper support yet
2026-02-19 first try in making a gripper controller
    added more waypoints for a better pick and place operation and fixed position of pick and place objekt.
    first steps in creating a gripper controller.
2026-03-02 small changes and clean up
    deleted gripper controller
2026-03-04 first steps in making the simulink model ready to generate code for a microprozessor
    first steps in making the simulink model ready to generate code for a microprozessor
    removed the inverse kinematiks block in the simulink model and changed the waypoints from cartesian to joint angles
2026-03-06 Added full PSU architecture to driverboard
    +24V In
    +12V out
    +5V out
    +3.3V out
2026-03-06 Cleaned up a bit and fixed mistake with NRST pin
2026-03-10 Revise README to provide detailed project overview
    Expanded project description to include details on the robotic arm's design, electronics, and software development.
2026-03-24 Add TMC5160 Software SPI example
    Add an Arduino example (Software_SPI_com.ino) demonstrating communication with a TMC5160 using the TMCStepper library.
2026-03-26 Added footprint of motor driver and added power
2026-03-26 add Roboterarm project
    Update TMC SPI example and add a new PlatformIO sample project for a Roboterarm.
2026-03-31 first test with raspberry pi
    first test with raspberry pi
2026-04-01 Add TMC5160 test script for Raspberry Pi
    Add a working TMC5160 test script that uses spidev and RPi.GPIO to configure and exercise a stepper driver. The script clears latched faults, writes GCONF, IHOLD_IRUN, CHOPCONF (set for 16 microsteps) and PWMCONF, reads GSTAT and DRVSTATUS to verify health, then pulses the STEP pin (3200 pulses for one rev at 16 microsteps) while toggling DIR. Performs status checks after the move and cleans up SPI/GPIO. Intended as a hardware test utility—run only on appropriate Raspberry Pi hardware connected to a TMC5160.
2026-04-01 Add TMC5160 SPI setup and debug scripts
    Add two Python utilities for TMC5160 stepper driver diagnostics and configuration over SPI: setupTMC5160.py clears latched faults, programs GCONF/IHOLD_IRUN/CHOPCONF/PWMCONF and verifies driver readiness; debugregisterTMC5160.py performs a raw register dump and decodes key registers (GSTAT, DRVSTATUS, IOIN, CHOPCONF) into a human-readable summary and checks common fault conditions. Also include raspitest.slx.autosave (Simulink autosave) for the robot arm project.
2026-04-10 open-loop 6DOF stepper motor control via Raspberry Pi
    open-loop 6DOF stepper motor control via Raspberry Pi
    - Implement q→Step subsystem per joint (Gain 10186, Round, Unit Delay, Subtract, Abs)
    - Compute steps/rad based on 200 steps/rev, 16 microsteps, 1:20 gear ratio
2026-04-15 Refactor 6-axis stepper control to use continuous velocity (qd)
    - Eliminated initial trajectory spikes and quantization noise (staircase effect/oscillations).
    - Replaced complex Simulink blocks (1/z, round, diff) with a clean, vectorized MATLAB Function block.
    - Implemented array processing to generate absolute step frequencies (Hz) and direction signals (1/-1) for all 6 joints simultaneously.
    - Validated perfectly synchronized, smooth trapezoidal velocity profiles.
    - Prepared model architecture for open-loop hardware deployment (RasPi -> MCU -> TMC5160).
2026-04-21 Add STM32F446RE firmware project and drivers
    Add a new STM32CubeIDE firmware project for the driver_board_v2 (target: STM32F446RETx). Includes project metadata (.ioc, .cproject, .mxproject, .project), Core sources and headers (Core/Src, Core/Inc), startup and system files, CMSIS headers, STM32F4 HAL driver sources and headers, linker scripts (FLASH/RAM), license files and a Pin Layout spreadsheet. This imports the full HAL/CMSIS stack and build configuration to enable building and debugging the board firmware.
2026-04-21 Enable TIM1 PWM and add TMC step/dir pins
    Enable TIM HAL and add TIM1 PWM support for generating STEP pulses. Changes include: enable HAL_TIM_MODULE in stm32f4xx_hal_conf.h; add TIM driver headers/src to the project; implement MX_TIM1_Init (PWM on TIM1_CH1 / PA8) and HAL TIM MSP/PostInit; expose HAL_TIM_MspPostInit prototype and add htim1 in main.c; add TMC1_STEP and TMC1_DIR pin defines and initialize DIR GPIO; start TIM PWM and set direction during homing state. Project/IDE files (.cproject, .mxproject) updated to include TIM files. Added several datasheet/pinout documents.
2026-04-21 Add USART3 and stepper control helpers
    Introduce UART3 (huart3) with MX_USART3_UART_Init and enable GPIOB clock. Add stepper helper functions Step_Start, Step_Stop and Step_SetFreqHz to configure TIM1 PWM frequency and duty include bounds checks for ARR and a 50% duty default. Replace direct HAL_TIM_PWM_Start usage in homing state with Step_SetFreqHz(8000) + Step_Start and call MX_USART3_UART_Init() from main initialization.
2026-04-23 Add timers, PWM channels and TMC pin mappings
    Add TIM2/3/4/5/8/10 support and PWM channel configuration, plus pin mappings for TMC1..TMC6 (CS/STEP/DIR). Implement MX_TIM*_Init functions, register them in main, and update HAL MSP to enable clocks and configure GPIOs for timer post-init. Update GPIO setup and initial pin states, adjust USART3 GPIO init to use explicit pins, and refresh project .ioc to reflect new pins, timers and signals. Minor .cproject string tweak and add temporary Pin_Layout_STM32_Robot_PCB.xlsx (~$) file.
2026-04-23 Add limit switches, EXTI and homing changes
    Add limit switch support and update pin mappings; configure EXTI interrupts and GPIOs, and modify homing behavior.
    Changes include: new limit switch pin defines in main.h and home/limit angle arrays in main.c; updated pin assignments (e.g. TMC4_CS moved to PA1, TMC1_DIR changed) and GPIO initialization (enable GPIOD, set output levels, configure limit switches as falling-edge inputs with pull-ups). Added HAL_GPIO_EXTI_Callback and EXTI15_10 IRQ handler with simple debounce to stop stepping on switch trigger, and changed homing state to start stepping once at 200 Hz. Project configuration files (.ioc and .cproject) updated to reflect new pins and E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
2026-04-27 Add SPI stubs, homing IRQs, and motor tweaks, fixed interrupt not working
    Add SPIconfig.h/.c stubs and include SPIconfig in main.h. Update main.c to add a stoprequest flag, adjust stepper behavior (start uses higher step frequency and restores holding current, stop lowers holding current when PSU goes into CC and force-disables MOE), and enable TIM1 AutoReloadPreload. Enable and register additional EXTI IRQs (EXTI2 and limit switches 2-5) and set stoprequest in the homing EXTI callback. Add two documentation ODT files for microcontroller software and an interrupt-for-homing issue.
2026-04-27 Add TMC SPI read/write and refactor main
    Move and implement TMC SPI register access into SPIconfig (TMC_WriteReg, TMC_ReadReg) and add prototypes to SPIconfig.h , fix minor type/format issues (limit_rad initialization, comment translations), and tweak stoprequest handling and related comments. Updated documentation. These changes modularize SPI code for reuse and clean up main logic.
2026-04-28 Add homing offset handling and timer/IRQ support
    Implement precise homing offset sequence and timer/IRQ plumbing: add step-tracking globals, motor parameters and Step_Start_Exact() to run an exact number of steps while restoring TMC run current. Add HAL_TIM_PeriodElapsedCallback to count steps and stop when target reached, update Step_Stop to also stop timer interrupts, and start/enable TIM1/TIM10 NVIC entries in MSP. Add unified TIM1_UP_TIM10_IRQHandler and EXTI handlers (EXTI15_10 and EXTI2) and register LimitSwitch_base, renaming LimitSwitch_2 to LimitSwitch_base in headers, GPIO init and .ioc. Tweak TIM1 AutoReloadPreload setting and remove duplicate stoprequest declaration.
2026-04-29 fixing dir pin
    fixing dir pin layout so the motor changes direction
2026-05-01 Add SPDX headers and tweak stepper speeds
    Insert SPDX GPL-3.0-or-later license headers and copyright notices.
    See LICENSE-SOFTWARE in the project root for full license details.
2026-05-08 Refactor homing for multi axis
    Convert homing/stepping code to support 6 axes: replace single-step counters with arrays, add AXIS_TIMERS/AXIS_CHANNELS, and change Step_Start/Stop/SetFreq/Start_Exact to accept an axis index. Add extern TMC register helpers, a short boot delay for TMC init, and a new STATE_HOMING_OFFSET to handle offset moves after limit switch triggers. Update homing state machine and EXTI callback to map limit switches correctly, compute offset steps using MOTOR_STEPS/MICROSTEPS/GEAR_RATIO, and make the timer ISR handle per-axis step counting. Minor housekeeping: adjust DIR pin ordering and suppress noisy READY prints. Also update documentation (.odt) and remove a temporary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
2026-05-08 Scale TMC SPI functions for more axis
    Update SPI/TMC interfaces to support multiple axes by adding an axis parameter . Also include an updated documentation ODT
2026-05-11 Robotarm V5
    In V5 there are new bearing with other dimensions
2026-05-12 Added small test board
2026-05-12 Some tweaks on V5 assembly
    changed some dimensions in v5 an added some main parts to print
2026-05-12 Made and added footprint for tmc5160t pro v1.0
2026-05-12 Started PCB layout for test board
2026-05-12 Updated test board
2026-05-13 fixed severe issue in test board
2026-05-18 Cleaned up test board
2026-05-18 Adjusted test board
2026-05-19 Last changes before first milling to Test board
2026-05-19 Improve homing, add URDF tool and update docs
    Firmware: adjust homing parameters and add debug prints in main.c — home_rad set to zeros because of defined homeposition in the urdf, limit_rad corrected, and several printf() calls added for tracing. Docs: major cleanup and rewrite of software chapter (content/software.tex) to document HAL, SPI init, FSM and homing flow; updated auxiliary files, TOC/figure counters, and added State_maschin.png and updated main.aux/main.* outputs to reflect the changes.
2026-05-28 Update software chapter: low-level arch & homing
    Revise Software chapter
2026-05-29 Final adjustments to test board (hopefully)
2026-06-04 ik code to run on the raspberry pi
    ik code to run on the raspberry pi, changed necessary things in urdf: remove mesh references, j1, j4, j6 from continiout to limits
2026-06-12 Changed switches to encoder
2026-06-23 Added gripper
2026-06-25 Added gnd plane
2026-07-14 Add WebSocket dashboard and update firmware homing
    Introduce a FastAPI WebSocket broker and new static dashboard: adds /ws/dashboard and /ws/data endpoints, a ConnectionManager for broadcasting, and serves static/dashboard.html (replaces the old realtime_dashboard.html). The Raspberry Pi client (kinematics.py) now includes a simple websocket client to send status updates and listen for x/y/z coordinates.
    Firmware changes: restrict driver init loop to axis 1 (likely for testing), increase stepper homing/offset frequency from 1000Hz to 5000Hz, comment out a homing printf, and fix EXTI2 IRQ to use LimitSwitch_2_Pin.
    Also adds a temporary ODT file (~$M32F446RE_pins.odt).
2026-07-23 Switch to SPI2 caus i broke SPI1:( and add ramp motion
    Migrate SPI from SPI1 to SPI2 and remap pins/initialization (hspi1 -> hspi2, MX_SPI2_Init, HAL MSP changes, .ioc and .cproject updates). Add a ramp-based motion controller (AxisRamp struct, StartMove, UpdateAllRamps) driven by TIM5; enable TIM5 IRQ and implement TIM5_IRQHandler to update ramps. Remove/disable previous limit-switch EXTI handling and related GPIO configs and homing code; simplify TMC driver init and add debug prints. Misc: include <math.h>, various cleanups/renames in main.c and SPIconfig.c to use SPI2, and remove unused GPIOD clock enable.
2026-08-10 Add synchronized multi-axis moves & fix SPI/timer mapping
    Implement synchronized multi-axis movement and timing measurement (ComputeSyncedVmax, StartSyncedMove), add per-axis finish timing and result printing. Improve step control: enable/disable MOE for advanced timers in Step_Start/Step_Stop and enforce ARPE in Step_SetFreqHz. Fix hardware mappings: reorder SPI CS arrays and AXIS_TIMERS to match axis indexing, set initial axis count and default target_steps. Update main init to check all axes' GSTAT and use StartSyncedMove in STATE_READY; add minor housekeeping (dir sign handling, loop index fixes). Small header cleanup/comments and an updated binary pinout document.
2026-08-17 creating first 2 nodes
    one node to input a array of [axis, steps, dir] and publishing this and another node to turn this into a standard format for Rviz and Movit2 called joint_states, the name of the joint and the position and a timestamp and publishing this
2026-08-19 everythong works now wow
    fixing a bug in the urdf which caused the ros_controller_node to crash right after startup, caused by the continous joints in the urdf
2026-08-19 inculde node to send to stm via uart
2026-09-02 addad homing which does not currently work
2026-09-02 fixed homing issue
2026-09-24 set up uart
2026-09-29 Value assignment and protection for driver board
2026-10-01 Finished testboard PCB Layout
2026-10-01 switch from STM32 cube IDE to VS code with STM32 cextention
    switch from STM32 cube IDE to VS code with STM32 cextention
    Update uart sytax for stepps
    Update INIT code for TMC drivers
2026-10-02 refactor code
    refactor the code so the uart function is in a seperate file as well as all the motor control functions
2026-10-09 Replace motor control with motion protocol
    Swapped out the old motor_control module for a new motion engine with a FIFO-based setpoint pipeline, state machine (enable/disable/fault handling), and 1 kHz tick integration in main. UART handling was rewritten to a framed binary protocol with CRC, command dispatch (config/setpoint/control), periodic state/diagnostic telemetry, and interrupt-driven RX buffering. Added Python host-side protocol helpers and end-to-end test scripts for motion behavior, UART robustness, and diagnostics.
2026-10-10 Gate motion enable on driver init status
    Adds a new FL_DRV_OK flag and MC_SetDriversOk() so motion enable is blocked until all TMC drivers are successfully initialized. Main loop now performs non-blocking, periodic TMC init retries from STATE_INIT and only transitions to READY once all axes pass register/version checks. Python protocol/test scripts were updated to decode DRV_OK, wait for it before running motion tests, and expect it to remain set after ClearFault.
2026-10-12 Improve STM32 motion control and test tooling
    Adds STM32CubeMX/CMake project artifacts and updates board init for HSE+PLL clocking, GPIOH enable, and immediate PWM startup on all step timers. Reworks motion control to drive real TIM/GPIO outputs, adds direction pin handling, adaptive FIFO pacing, velocity-history-based extrapolation on underrun, redirected late setpoints, synced braking, and a new STARVED fault path after prolonged missing setpoints. Updates UART/protocol flags and expands Python tooling with a new hardware pendulum/drift accuracy test plus revised motion tests for extrapolation, starvation, and synchronized stopping behavior.
2026-10-15 Refactor TMC init service and motion timing
    Move TMC5160 driver initialization/check logic out of main.c into SPIconfig.c as a non-blocking TMC_Service() with periodic retry, and gate driver-ready state through MC_SetDriversOk(TMC_Service()). This removes the old main-loop state-machine init path and centralizes SPI driver bring-up. Motion output timing was also adjusted to always use the fast timer clock/prescaler and clamp commanded frequency to a 200 Hz startup minimum. Added a new test log capture file at Software/test_codes/log.csv.
2026-10-23 Update V6 rework CAD assembly
    Refreshes the V6 rework assemblies and mechanical parts, adds the new gripper components, wrist pulleys and axle hardware, and includes the NEMA 17 motor STEP model.
2026-10-24 Update V6 rework CAD models
    Refreshes the V6 rework assemblies and wrist, gripper, upper-arm, and base components. Adds SolidWorks machine-specific assembly copies along with new wrist bearing and belt-tensioner parts.
2026-11-02 add monitoring and first stallguard attempt
    add monitoring of TMC via the Drive Status register
    add stallguard monitoring and sgt selection via COOLCONF and Drive Status register
2026-11-05 modify programm so stallguard works reliable
    modify programm so stallguard works reliable and can be easaly tuned using the STM32CubeMonitor Software.
    -Add min freq under which stallguard doesent set
    -add debounce
2026-11-06 Fix driver board schematic net labels
    Correct MCU SPI net labels and update the PC7 direction signal label to use the MCU suffix.
2026-11-09 add faststop when stall
    add faststop when stall
