EmanuelKaefer/Open-robot-arm/(notices)

Notices in the files:
Electrical/driver_board/driver_board_v2/Firmware/driver_board_software/Core/Src/main.c:
Copyright (c) 2026 STMicroelectronics.
All rights reserved.
This software is licensed under terms that can be found in the LICENSE file
